as-jackson/-RK3588-Development-Board-/RK3588_image/rk3588-armsom-w3-bananer.png

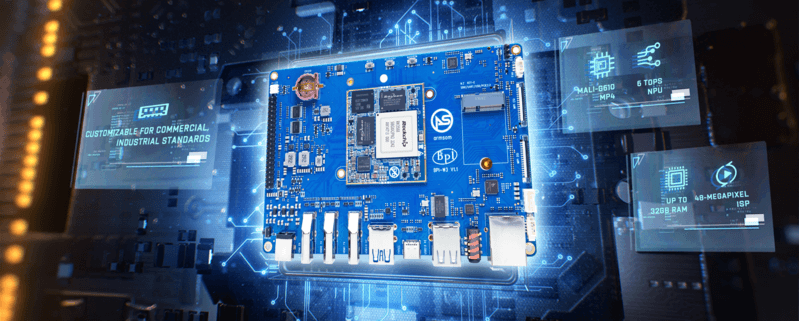
RK3588_image/rk3588-armsom-w3-bananer.png
