as-jackson/-RK3588-Development-Board-/RK3588_image/rk3588-sige7-Metal-shell.jpeg

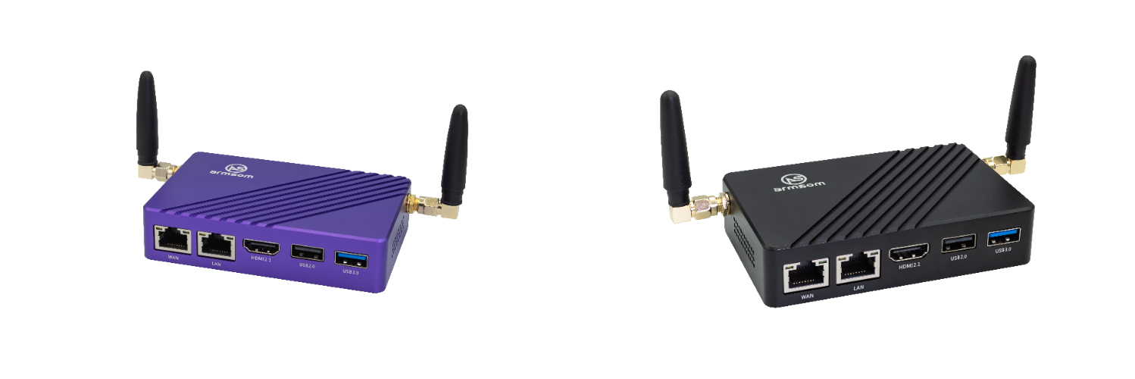
RK3588_image/rk3588-sige7-Metal-shell.jpeg
