as-jackson/-RK3588-Development-Board-/RK3588_Mechanical Drawings/rk3588_core_board_ArmSoM_W3_1V2_bot.dxf

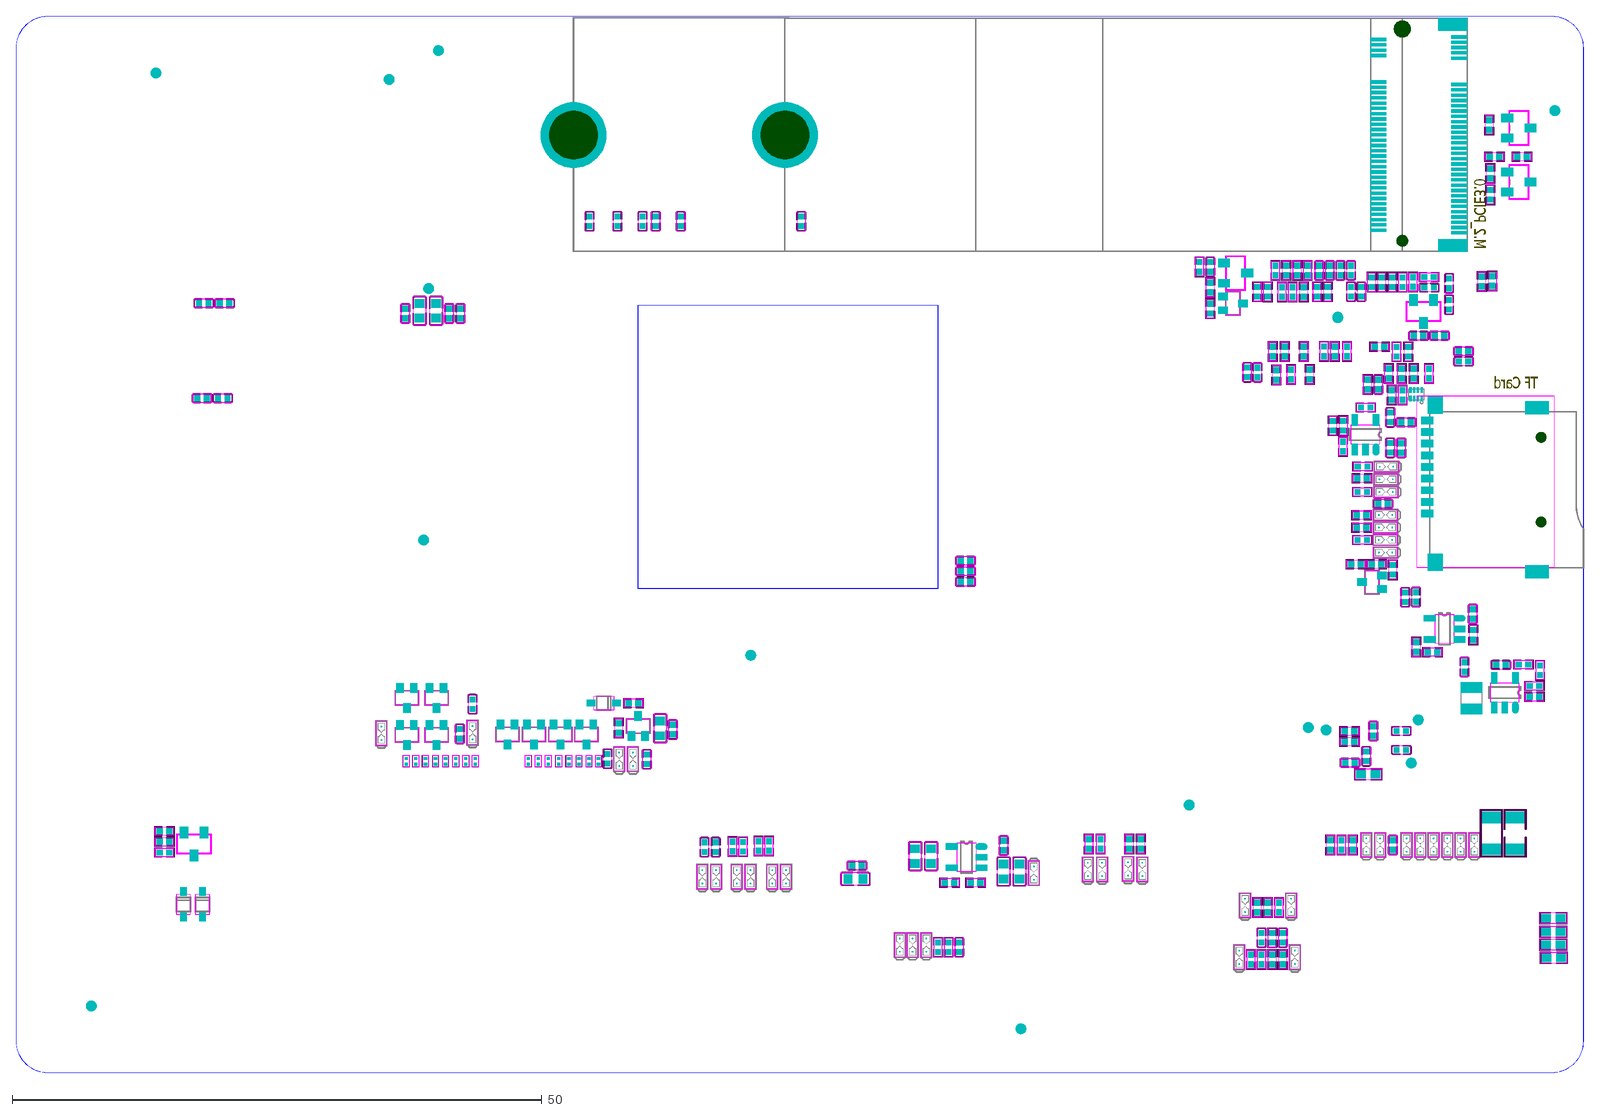
[picture p11: CAD file, 2024-10-31]
RK3588_Mechanical Drawings/rk3588_core_board_ArmSoM_W3_1V2_bot.dxf
M.2_PCIE3.0
TF Card
