as-jackson/-RK3588-Development-Board-/RK3588_Mechanical Drawings/RK3588_sbc_ArmSoM-Sige7_1V1_20231219_bot.dxf

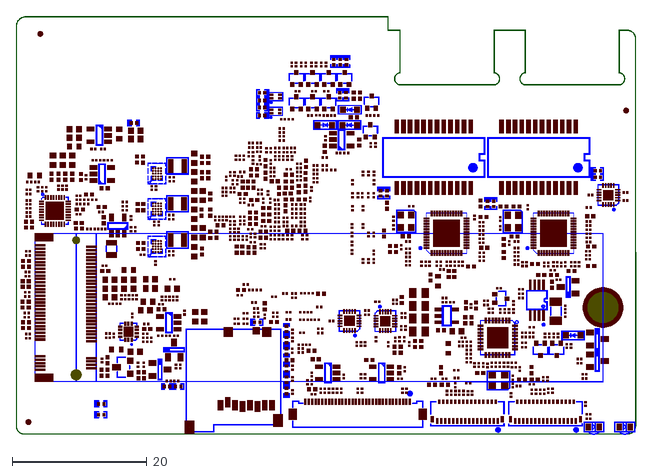
[picture p12: CAD file, 2024-10-31]
RK3588_Mechanical Drawings/RK3588_sbc_ArmSoM-Sige7_1V1_20231219_bot.dxf
92.1 x 62.1
