as-jackson/-RK3588-Development-Board-/RK3588_Component_diagram/RK3588_core_board_ArmSoM_W3_1V2_SMD.pdf

# LED

CR1220

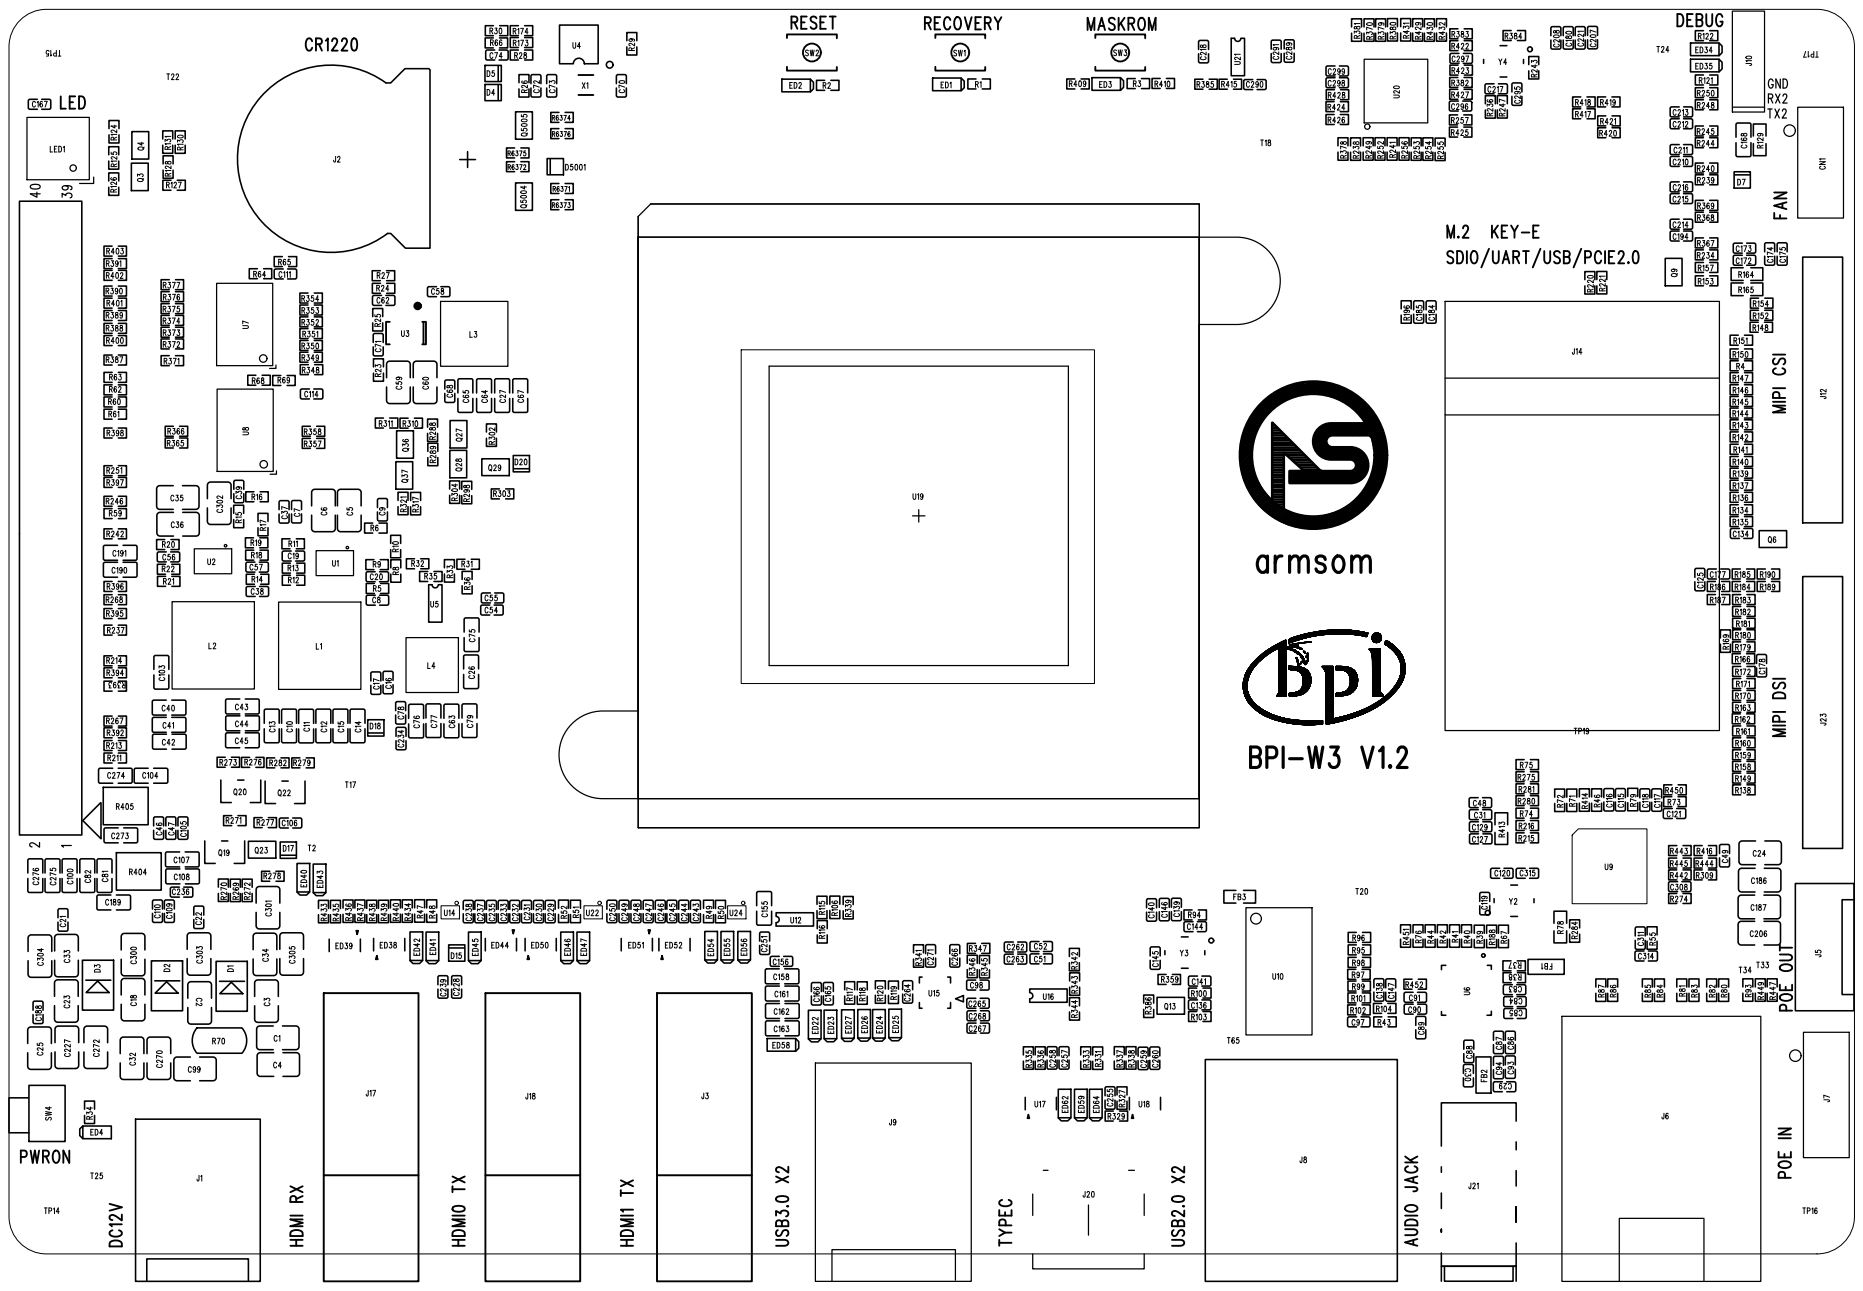
[picture p13: page 1]

POE IN POE OUT

T21

T23

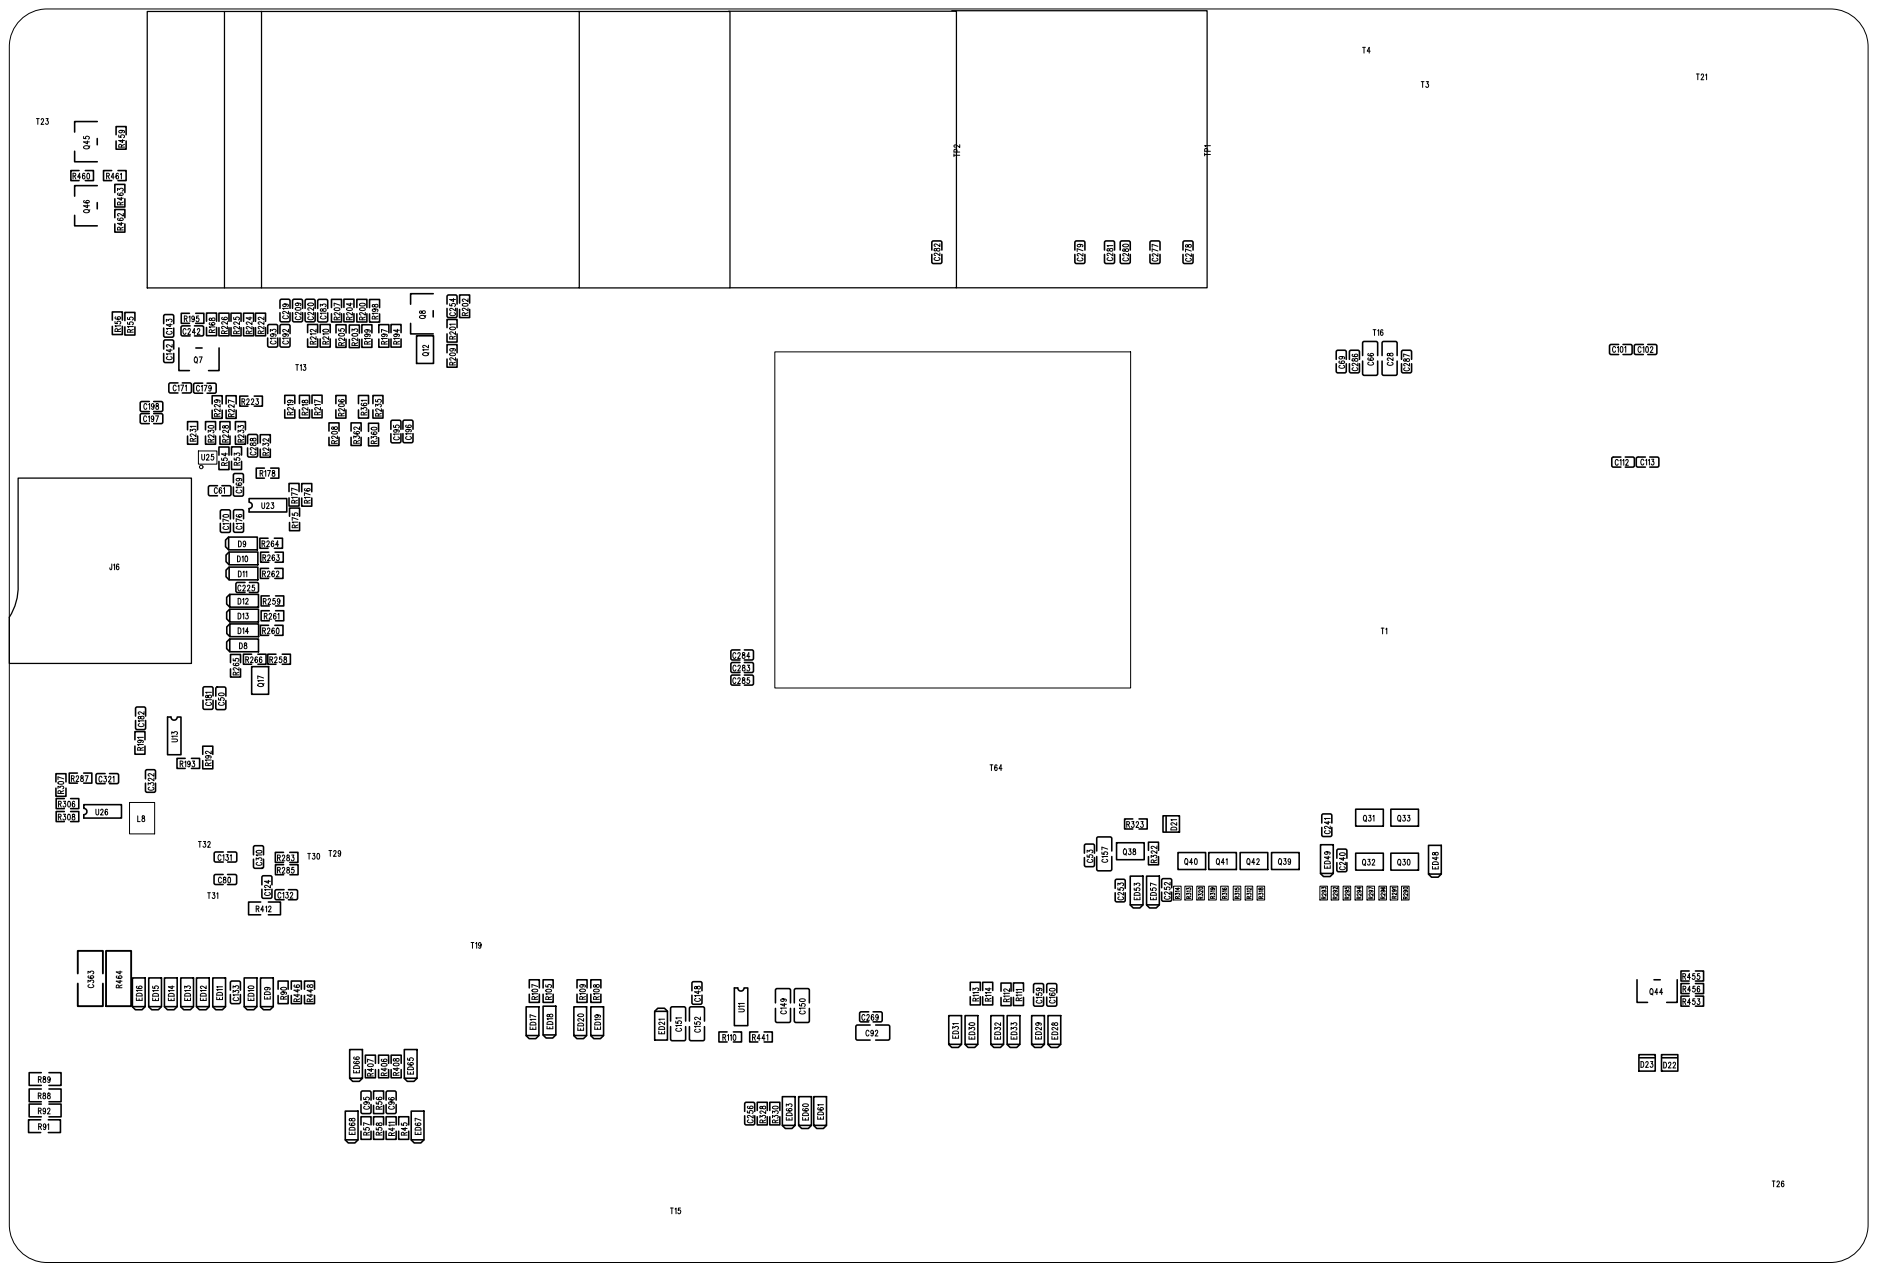
[picture p14: page 2]
