as-jackson/-RK3588-Development-Board-/RK3588_Component_diagram/RK3588_sbc_ArmSoM-Sige7_1V1_SMD.pdf

# SILKSCREEN TOP

CN30

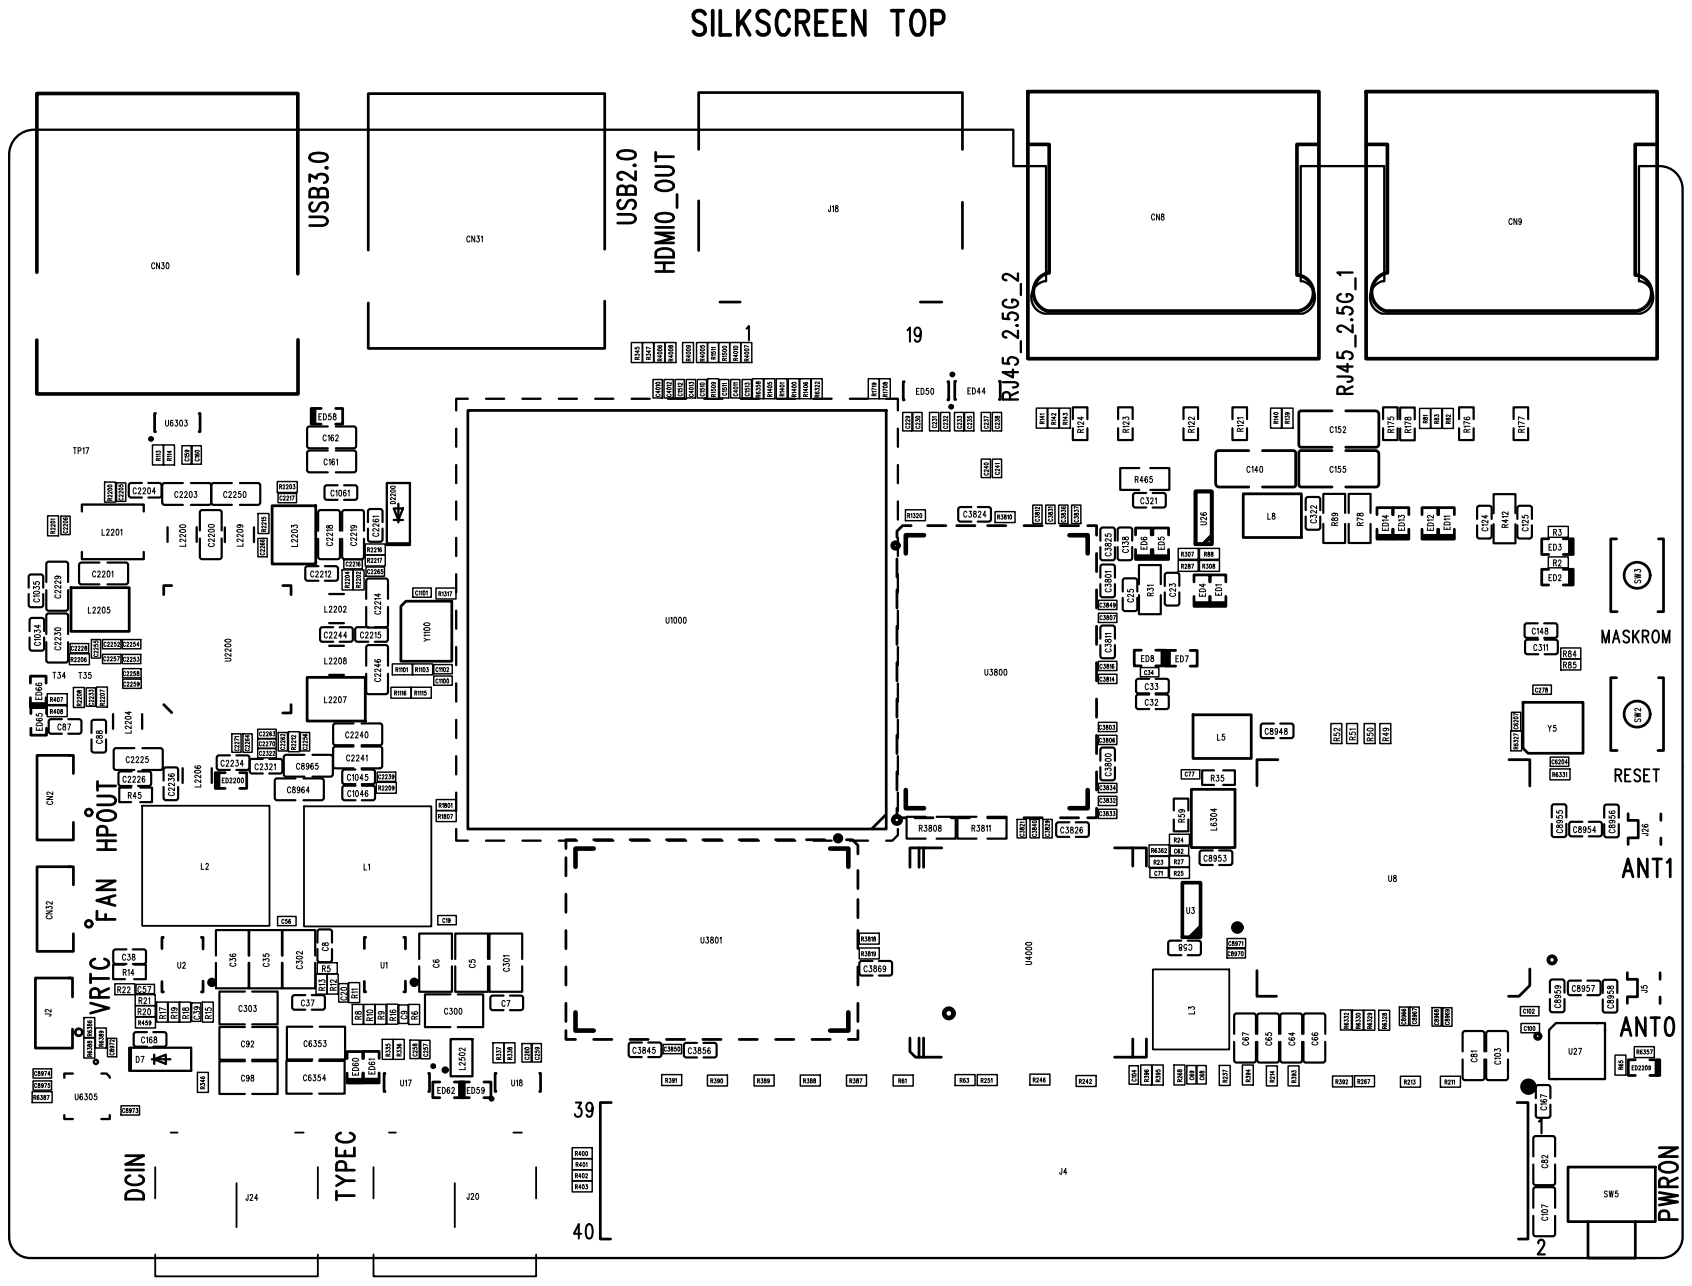
[picture p15: page 1]

# SILKSCREEN BOTTOM

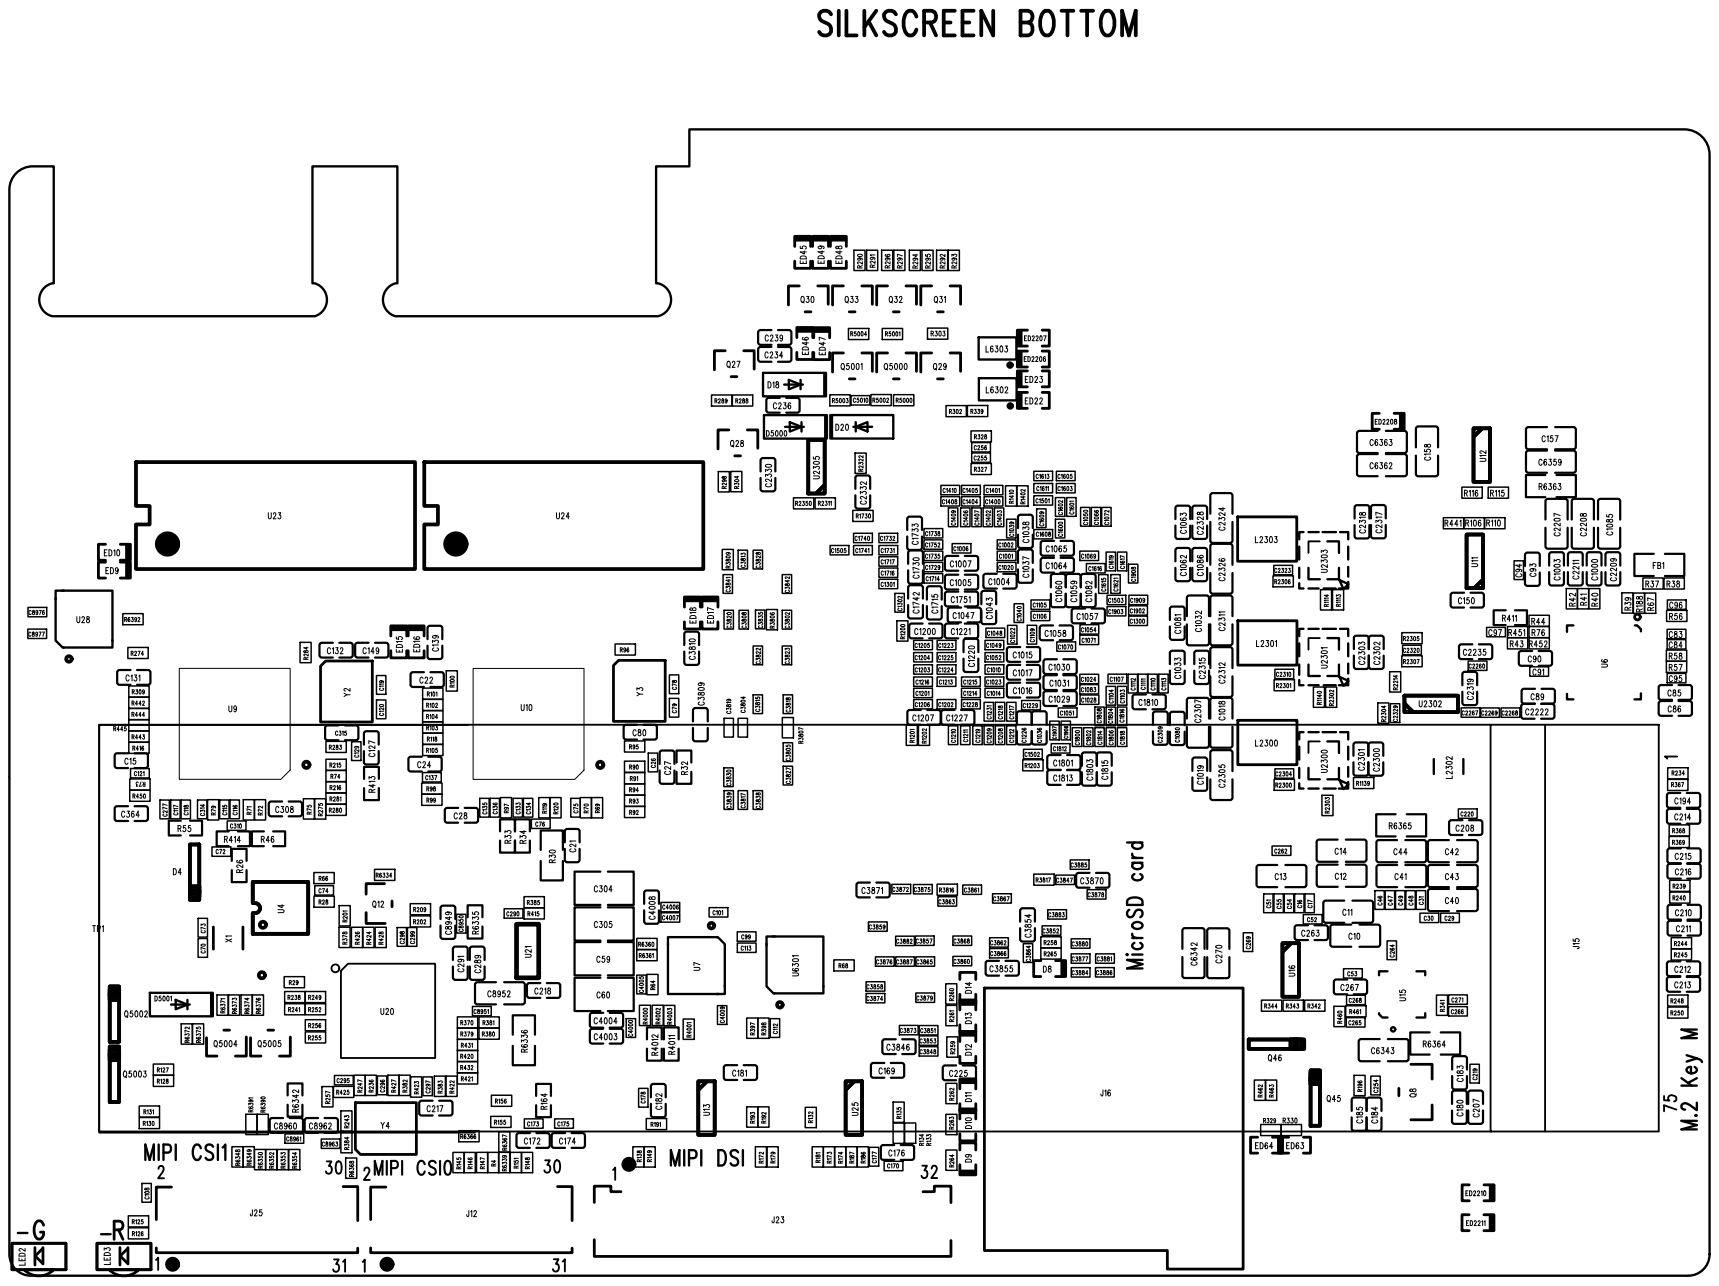
[picture p16: page 2]
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
