as-jackson/-RK3588-Development-Board-/RK3588_Schematics/RK3588_core_board_ArmSoM_W3_1V2_Sch.pdf

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
# Revsion V1.1:

1.PCBPackage change: USBx2=J8, touch switch=SW1/SW2/SW3, TF Card=J16,Typec=J20; 2.PCBPackage change: Debug CON=J10, 32.768KHz=X1; Shield=J13;
3.Fan =J11 change to 3 line;

# Revsion V1.2:

1.add uart2 protect circuit; R410=51K change to NC;

## Project :

Size | Page Name | Re v
Date: | Sheet | o f
https://armsom.org/ | Histroy | V1.2 ARMSOM_W3

# ArmSoM

A3 | Thursday, October 24, 2024 | 1 | 14
Size | Page Name | Re v
https://armsom.org/ | Histroy | V1.2 ARMSOM_W3

# ArmSoM

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

# ArmSoM

A3 | Thursday, October 24, 2024 | 1 | 14

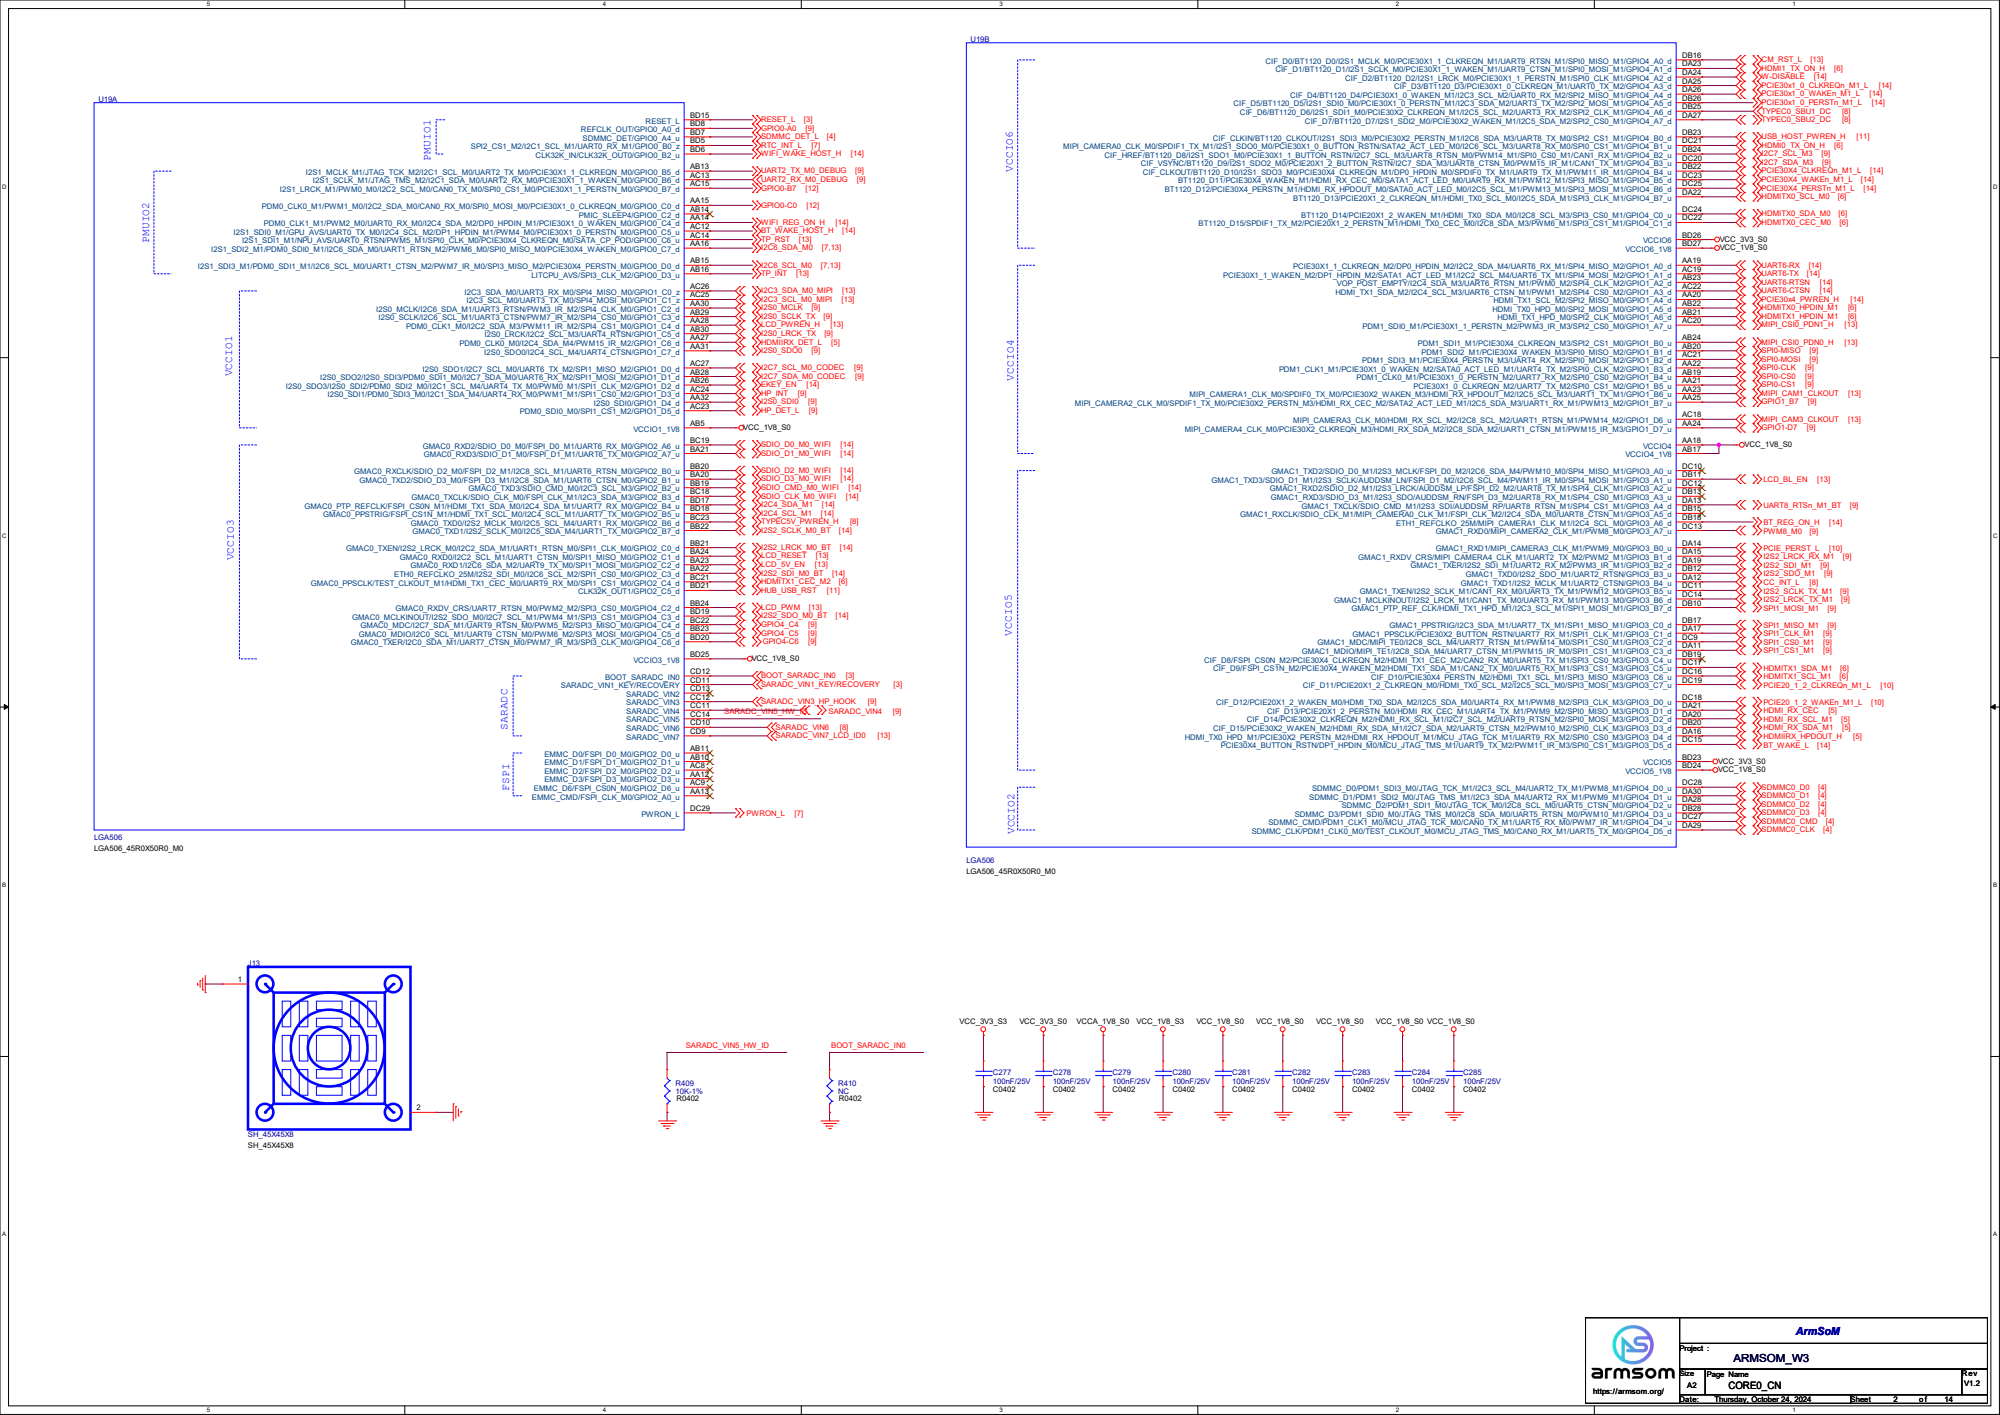
[picture p17: page 2]

PCIE20_1_REFCLKN | [14] PCIE20_1_REFCLKP [14] PCIE20_1_RXN [14] PCIE20_1_RXP [14] PCIE20_1_TXN [14] PCIE20_1_TXP [14] USB30_2_SSRXN [11] USB30_2_SSRXP [11] USB30_2_SSTXN [11] USB30_2_SSTXP [11] PCIE30_PORT0_TX0N [14] PCIE30_PORT0_TX0P [14] PCIE30_PORT0_RX0N [14] PCIE30_PORT0_RX0P [14] PCIE30_PORT0_TX1N [14] PCIE30_PORT0_TX1P [14] PCIE30_PORT0_RX1N [14] PCIE30_PORT0_RX1P [14] PCIE30_PORT1_REFCLKN_IN | [14] PCIE30_PORT1_REFCLKP_IN | [14] PCIE30_PORT1_TX2N [14] PCIE30_PORT1_TX2P [14] PCIE30_PORT1_RX2N [14] PCIE30_PORT1_RX2P [14] PCIE30_PORT1_TX3N [14] PCIE30_PORT1_TX3P [14] PCIE30_PORT1_RX3N [14] PCIE30_PORT1_RX3P [14] PCIE30_PORT0_REFCLKN_IN | [14] PCIE30_PORT0_REFCLKP_IN | [14]

# BA30 MIPI_CSI1_RX_D2P

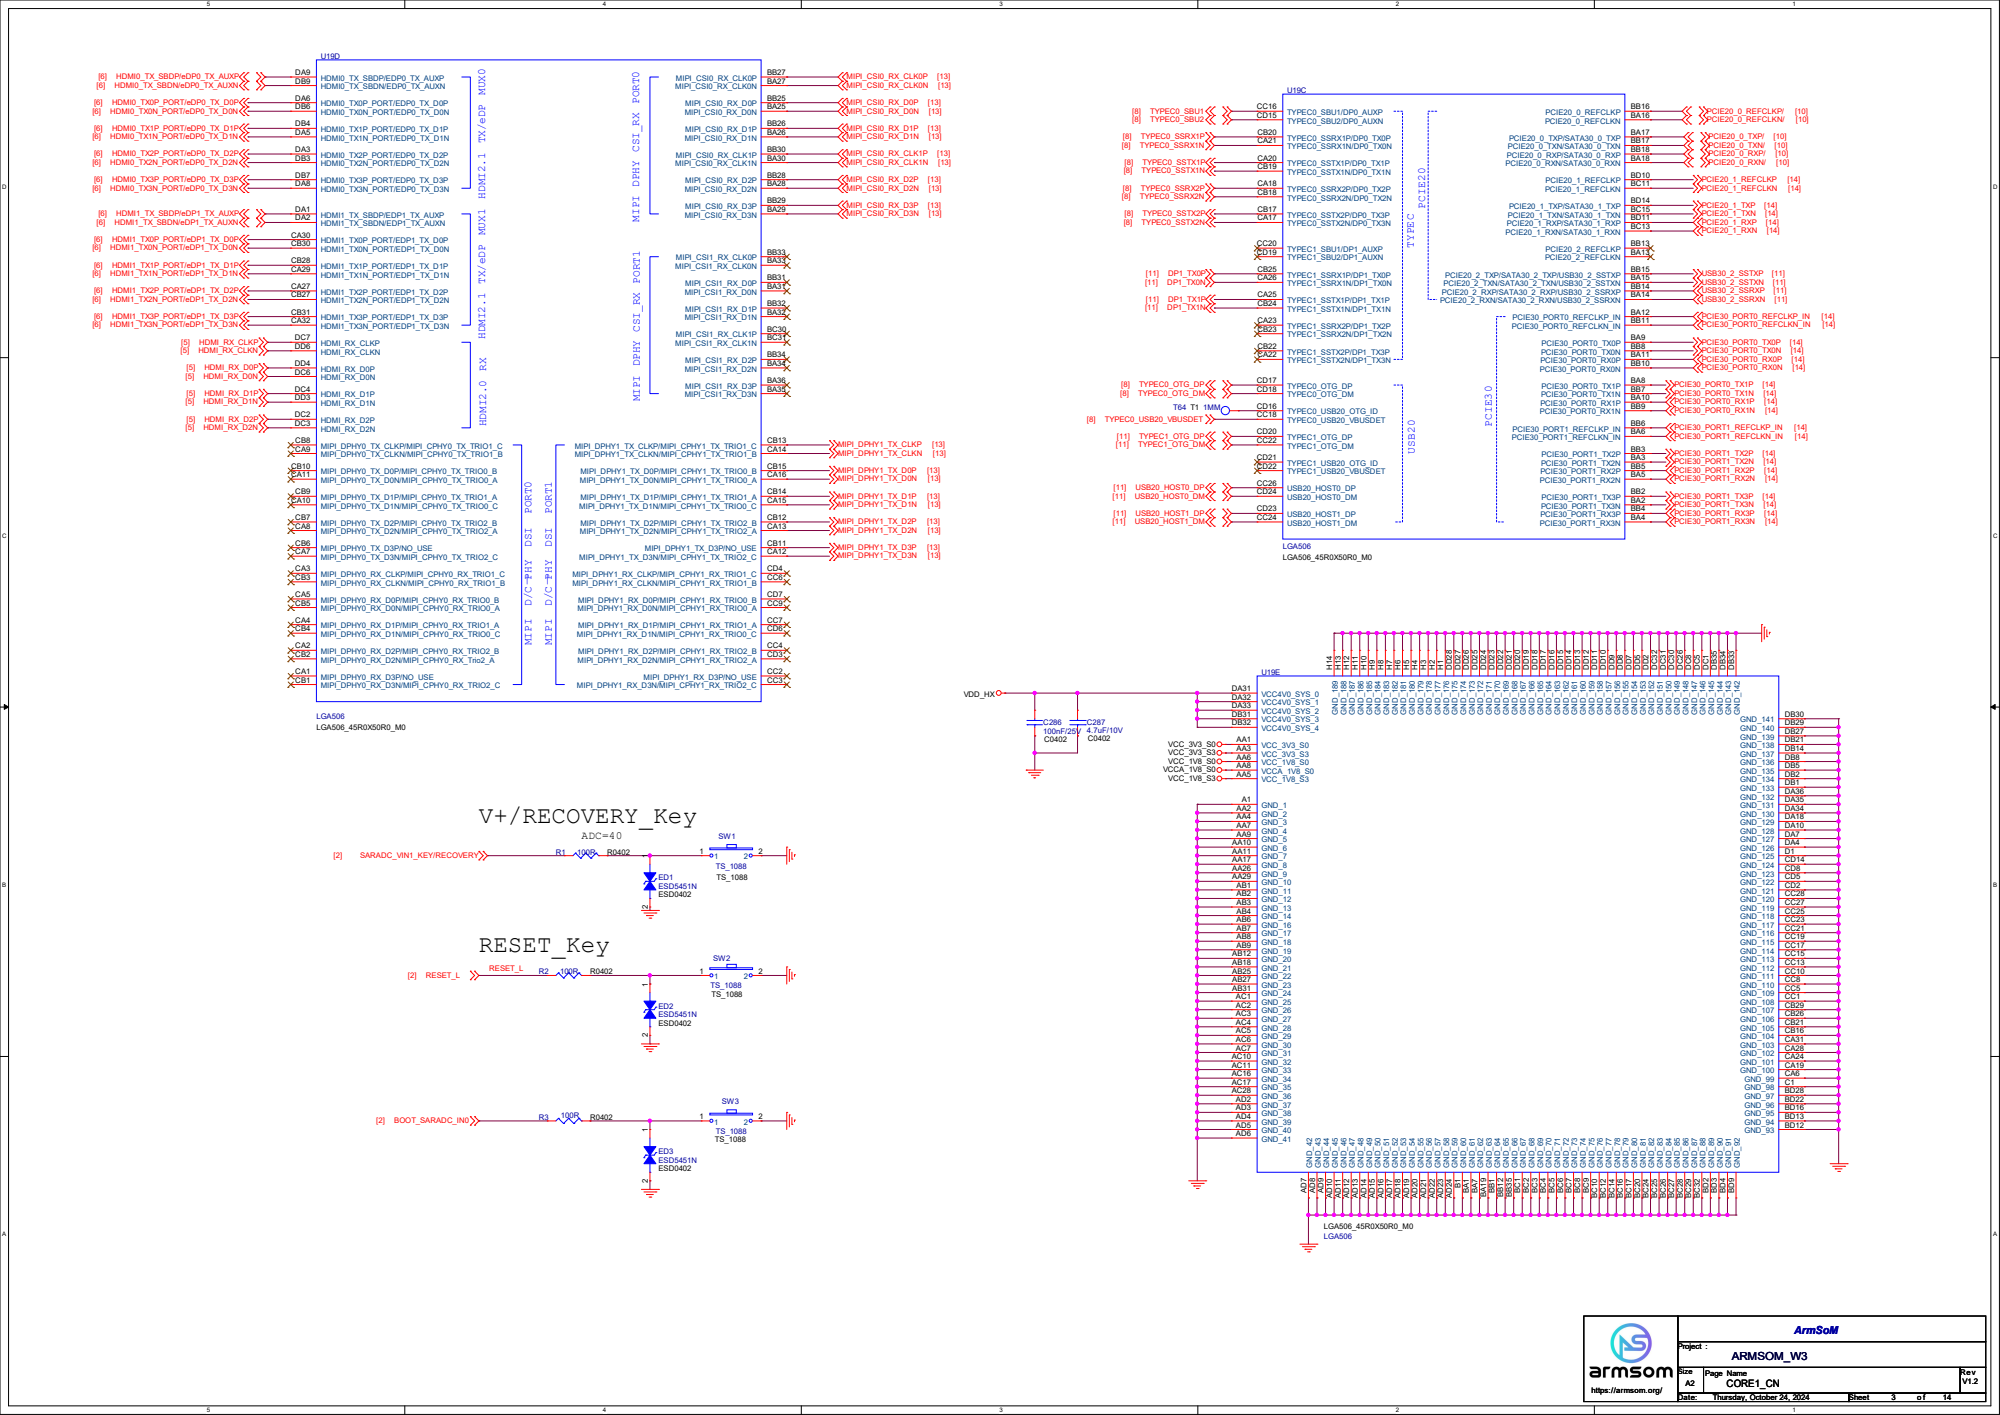
[picture p18: page 3]

D D

# TF CARD

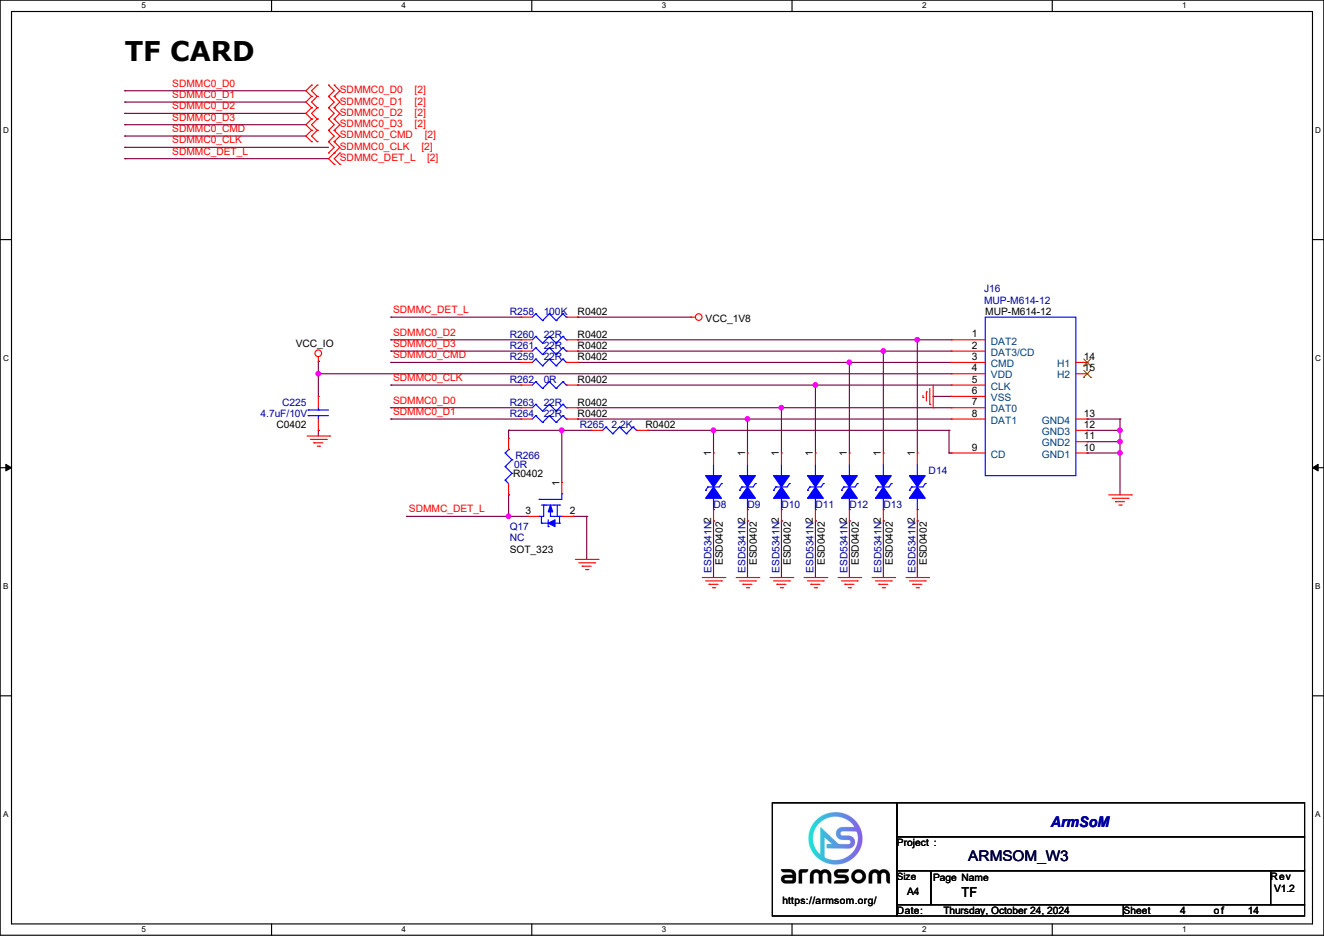
[picture p19: page 4]

# HDMI2.0 RX

HDMI_RX_D1P_PORT HDMI_RX_D1N_PORT | HDMI_RX_D1P_PORT HDMI_RX_D1N_PORT HDMI_RX_D2N_PORT HDMI_RX_D2P_PORT HDMI_RX_D2N_PORT HDMI_RX_D2P_PORT | HDMI_RX_D0N_PORT HDMI_RX_D0P_PORT | HDMI_RX_D0N_PORT HDMI_RX_D0P_PORT HDMI_RX_CLKP_PORT HDMI_RX_CLKN_PORT HDMI_RX_CLKP_PORT HDMIIRX_DET_L | HDMI_RX_CLKN_PORT HDMI_RX_CEC

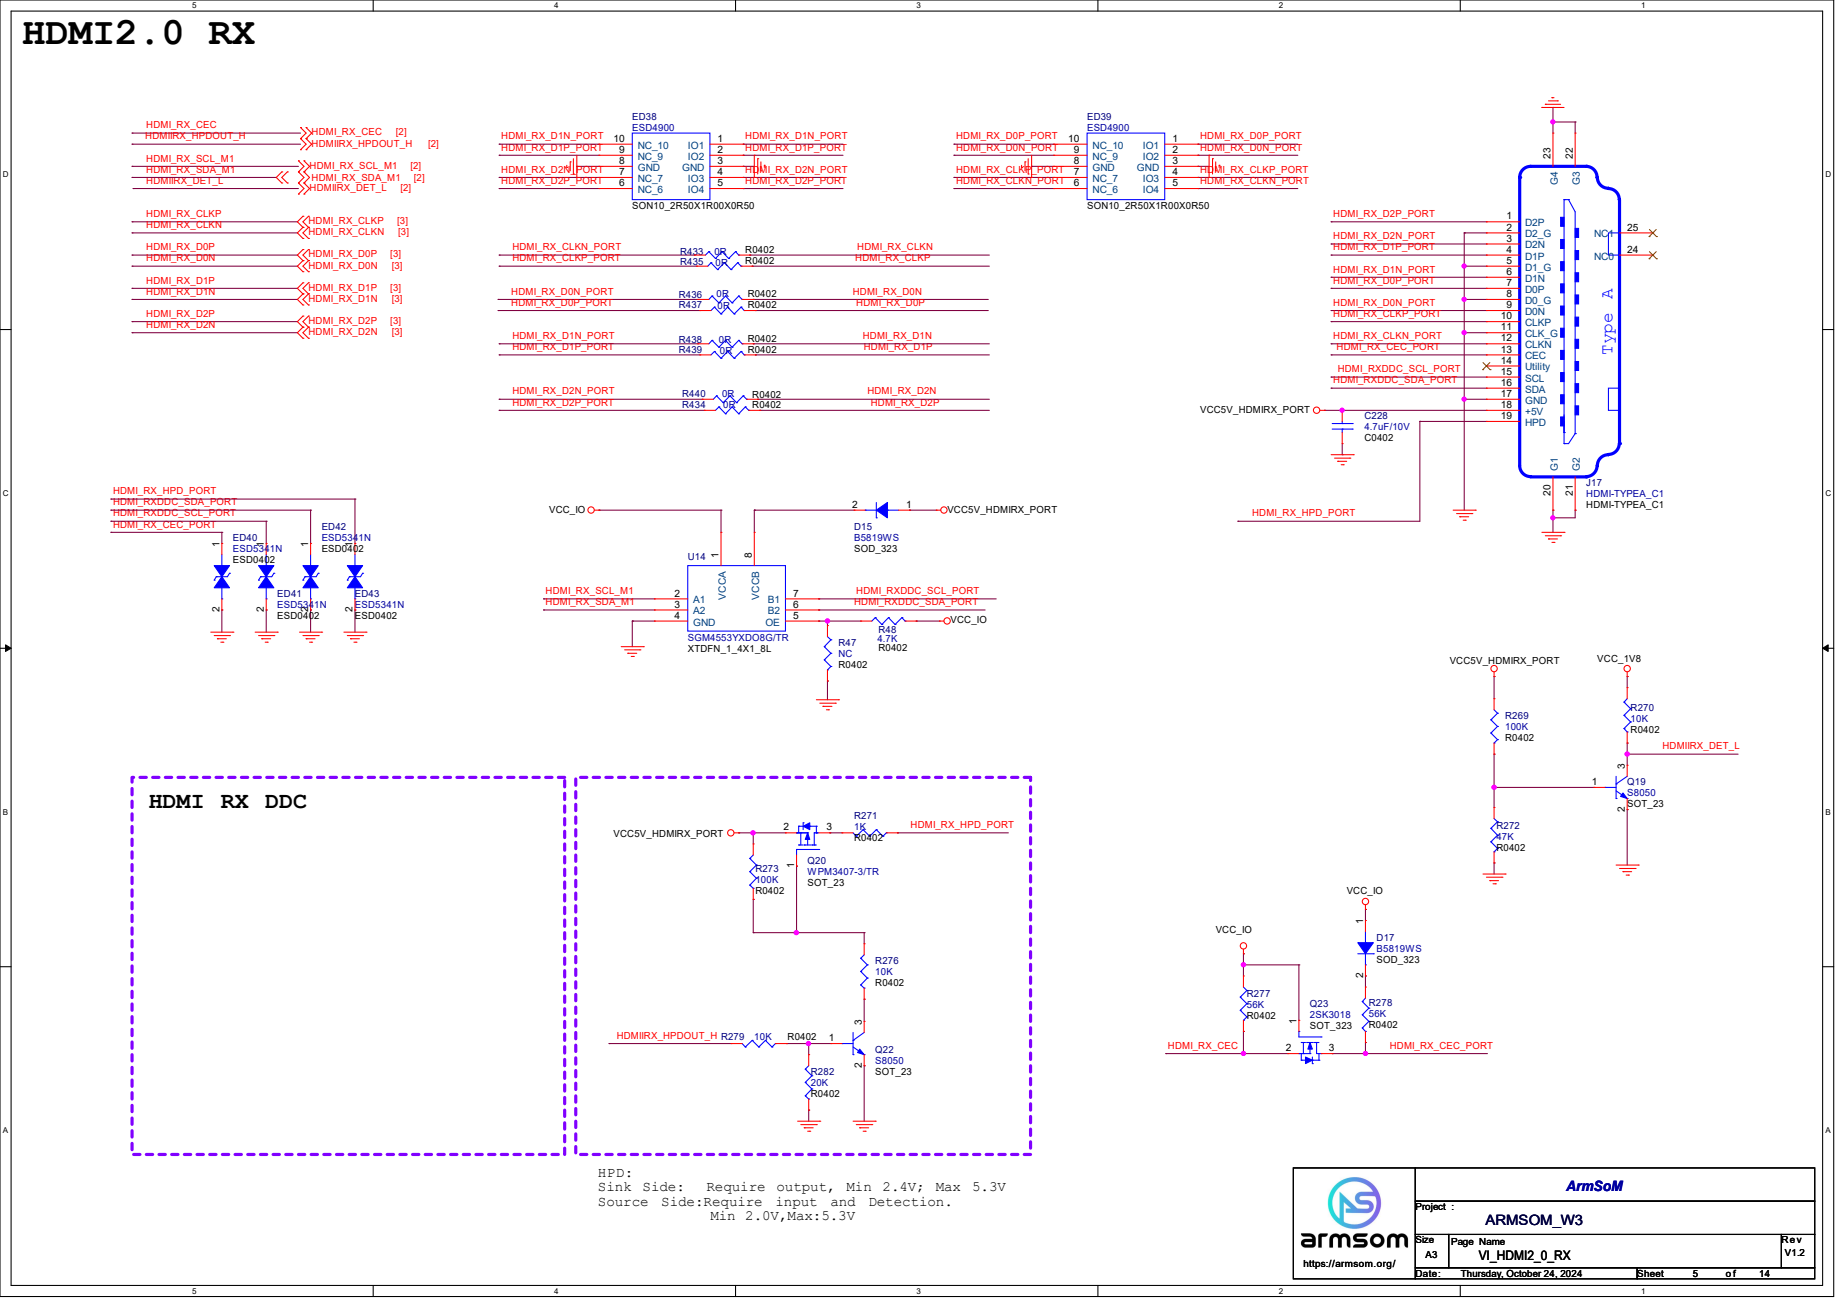
[picture p20: page 5]

HPD:
Source Side:Require input and Detection.

# HDMI TX0

# HDMI TX DDC

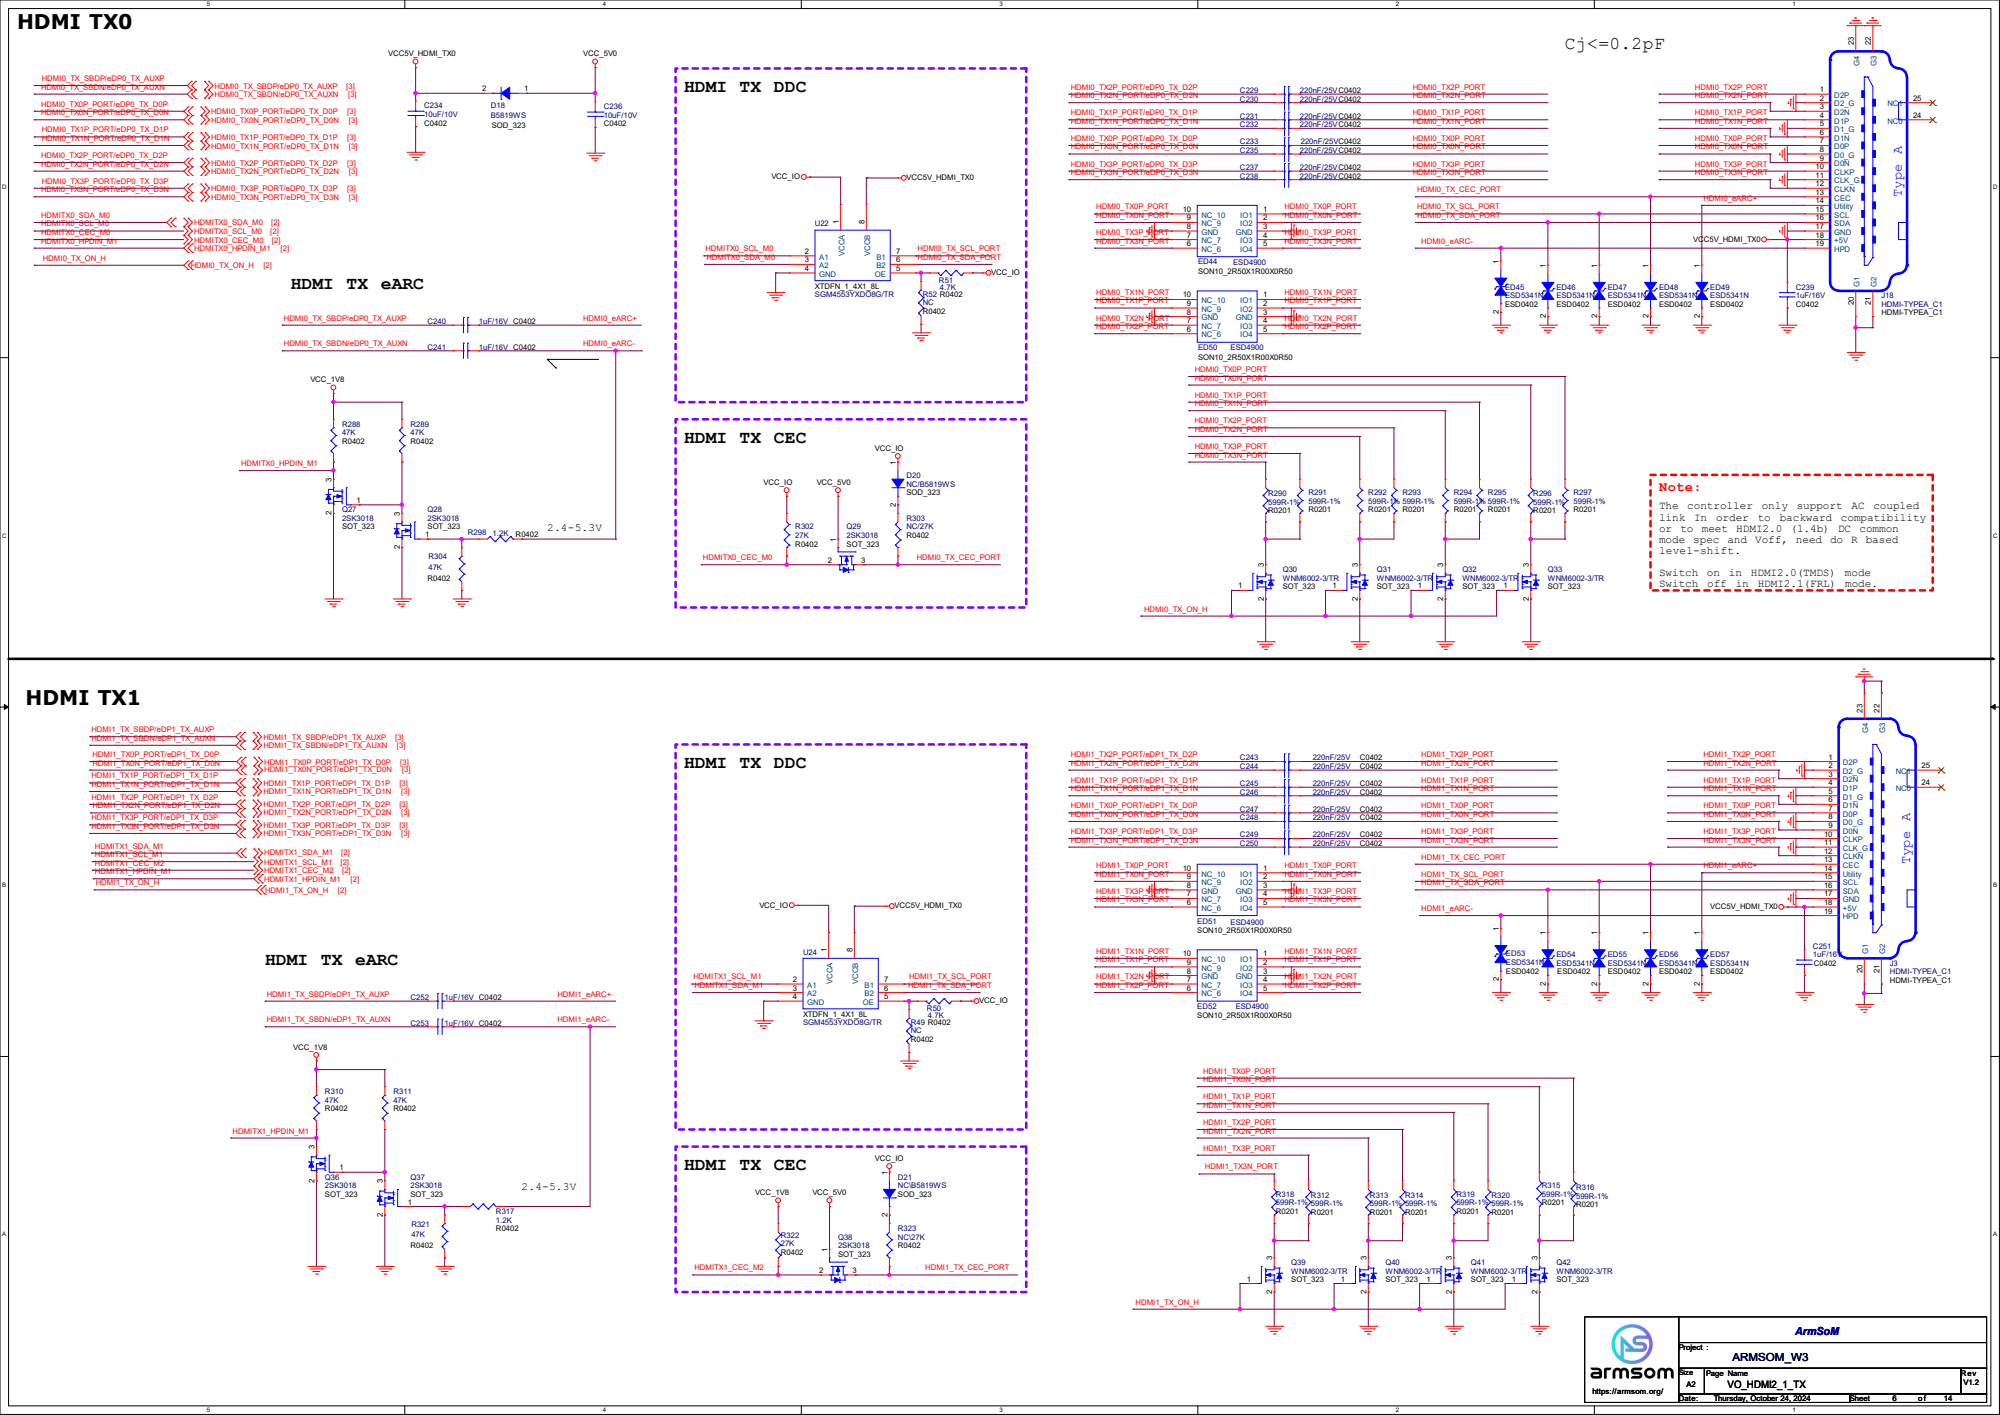
[picture p21: page 6]

Note:
The controller only support AC coupled
link In order to backward compatibility
or to meet HDMI2.0 (1.4b) DC common
mode spec and Voff, need do R based
level-shift.

Switch on in HDMI2.0(TMDS) mode
Switch off in HDMI2.1(FRL) mode.

# DC_5V

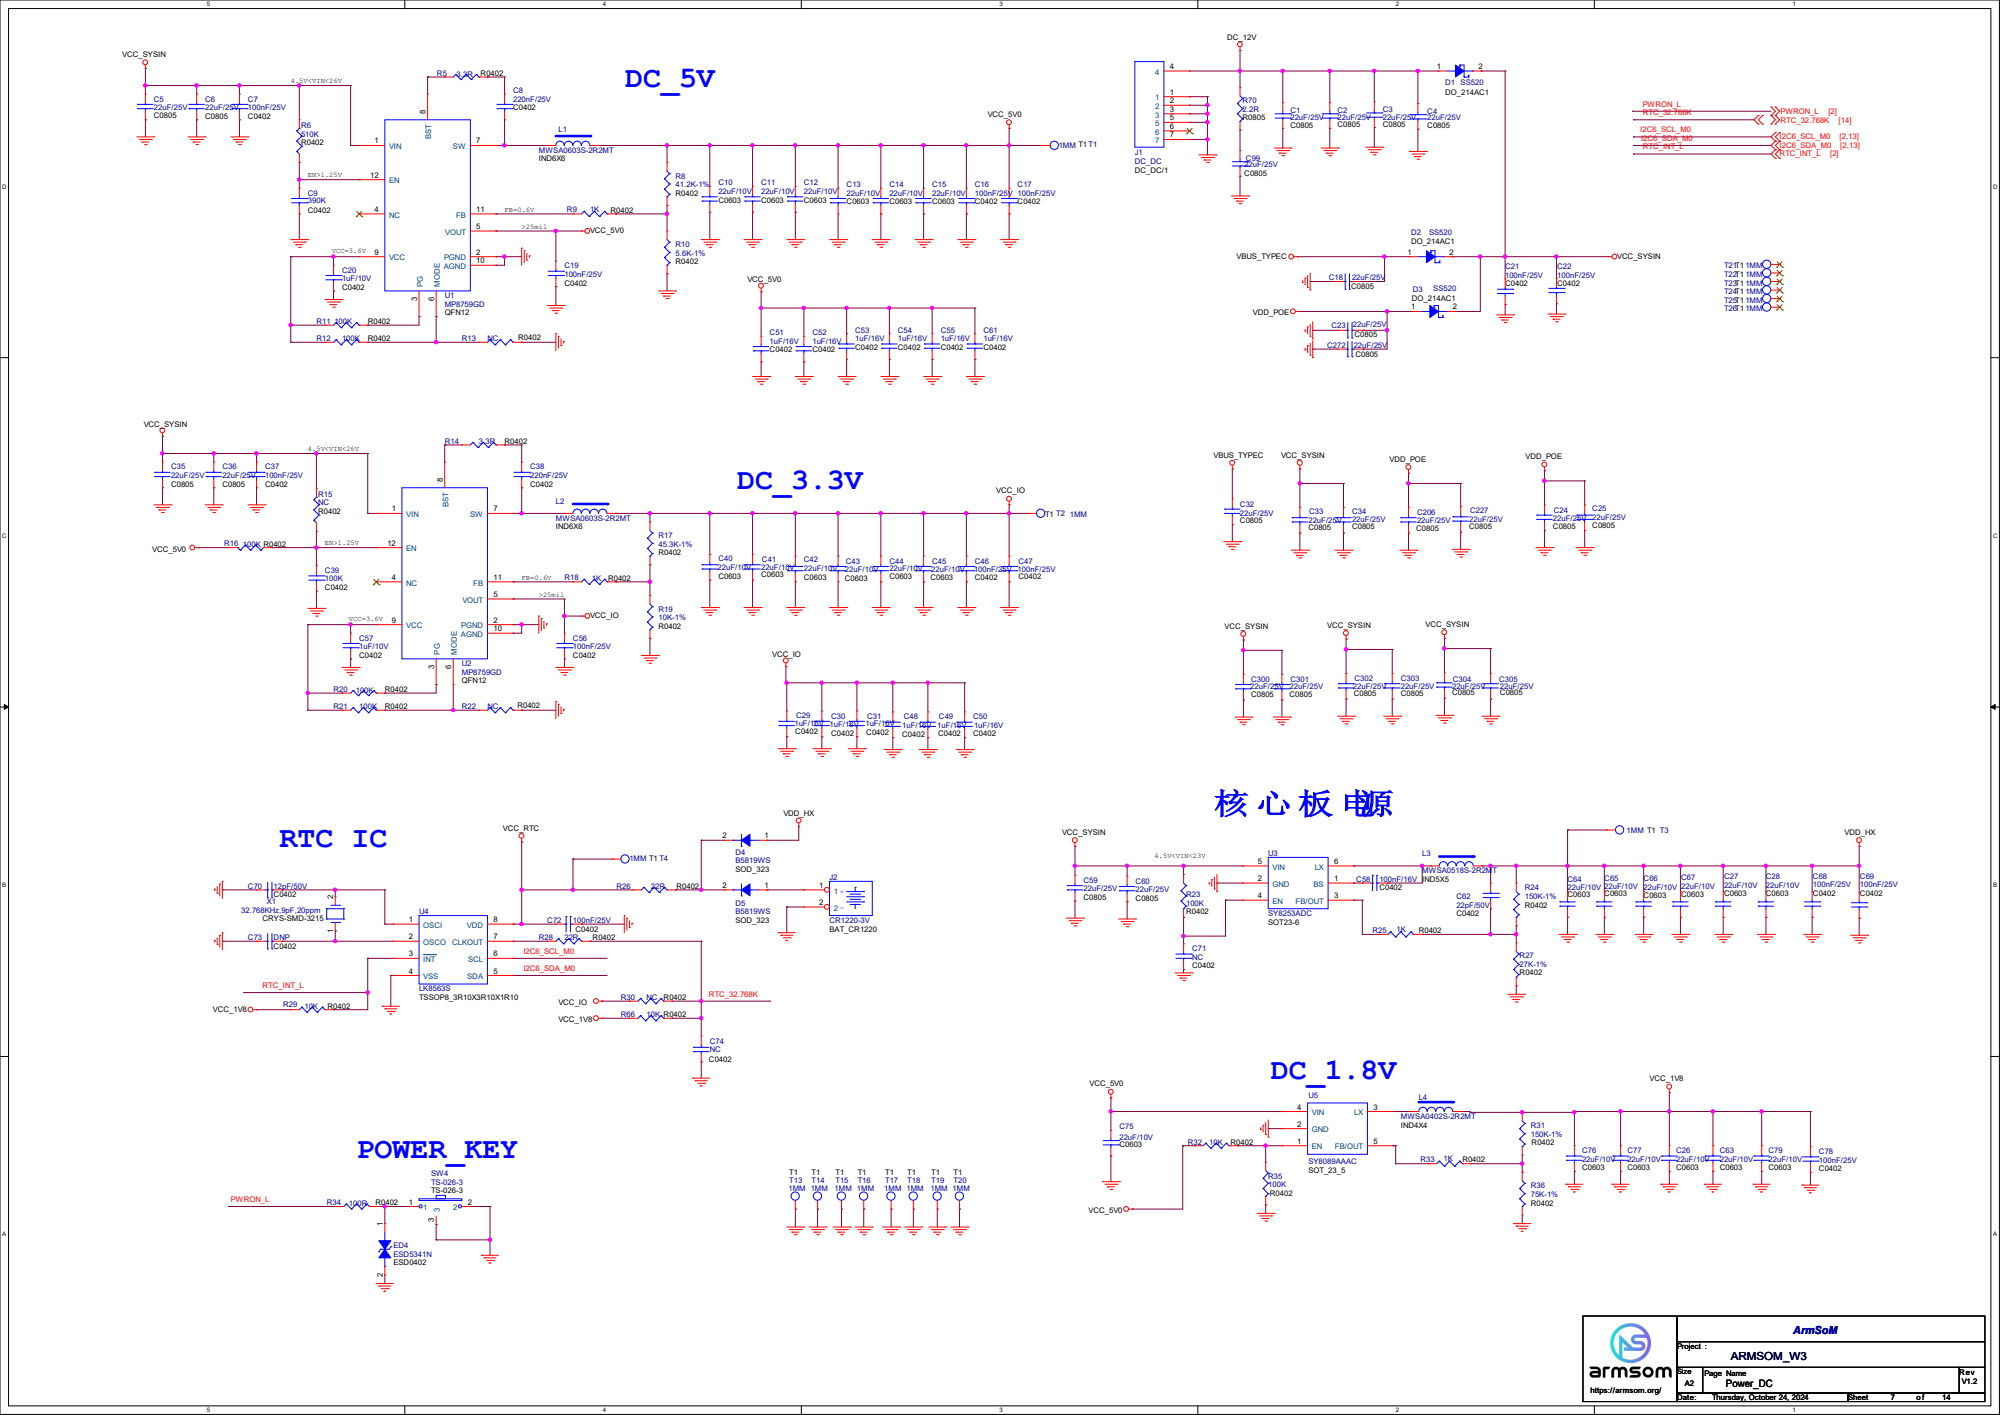
[picture p22: page 7]

D D

# Type-C PORT

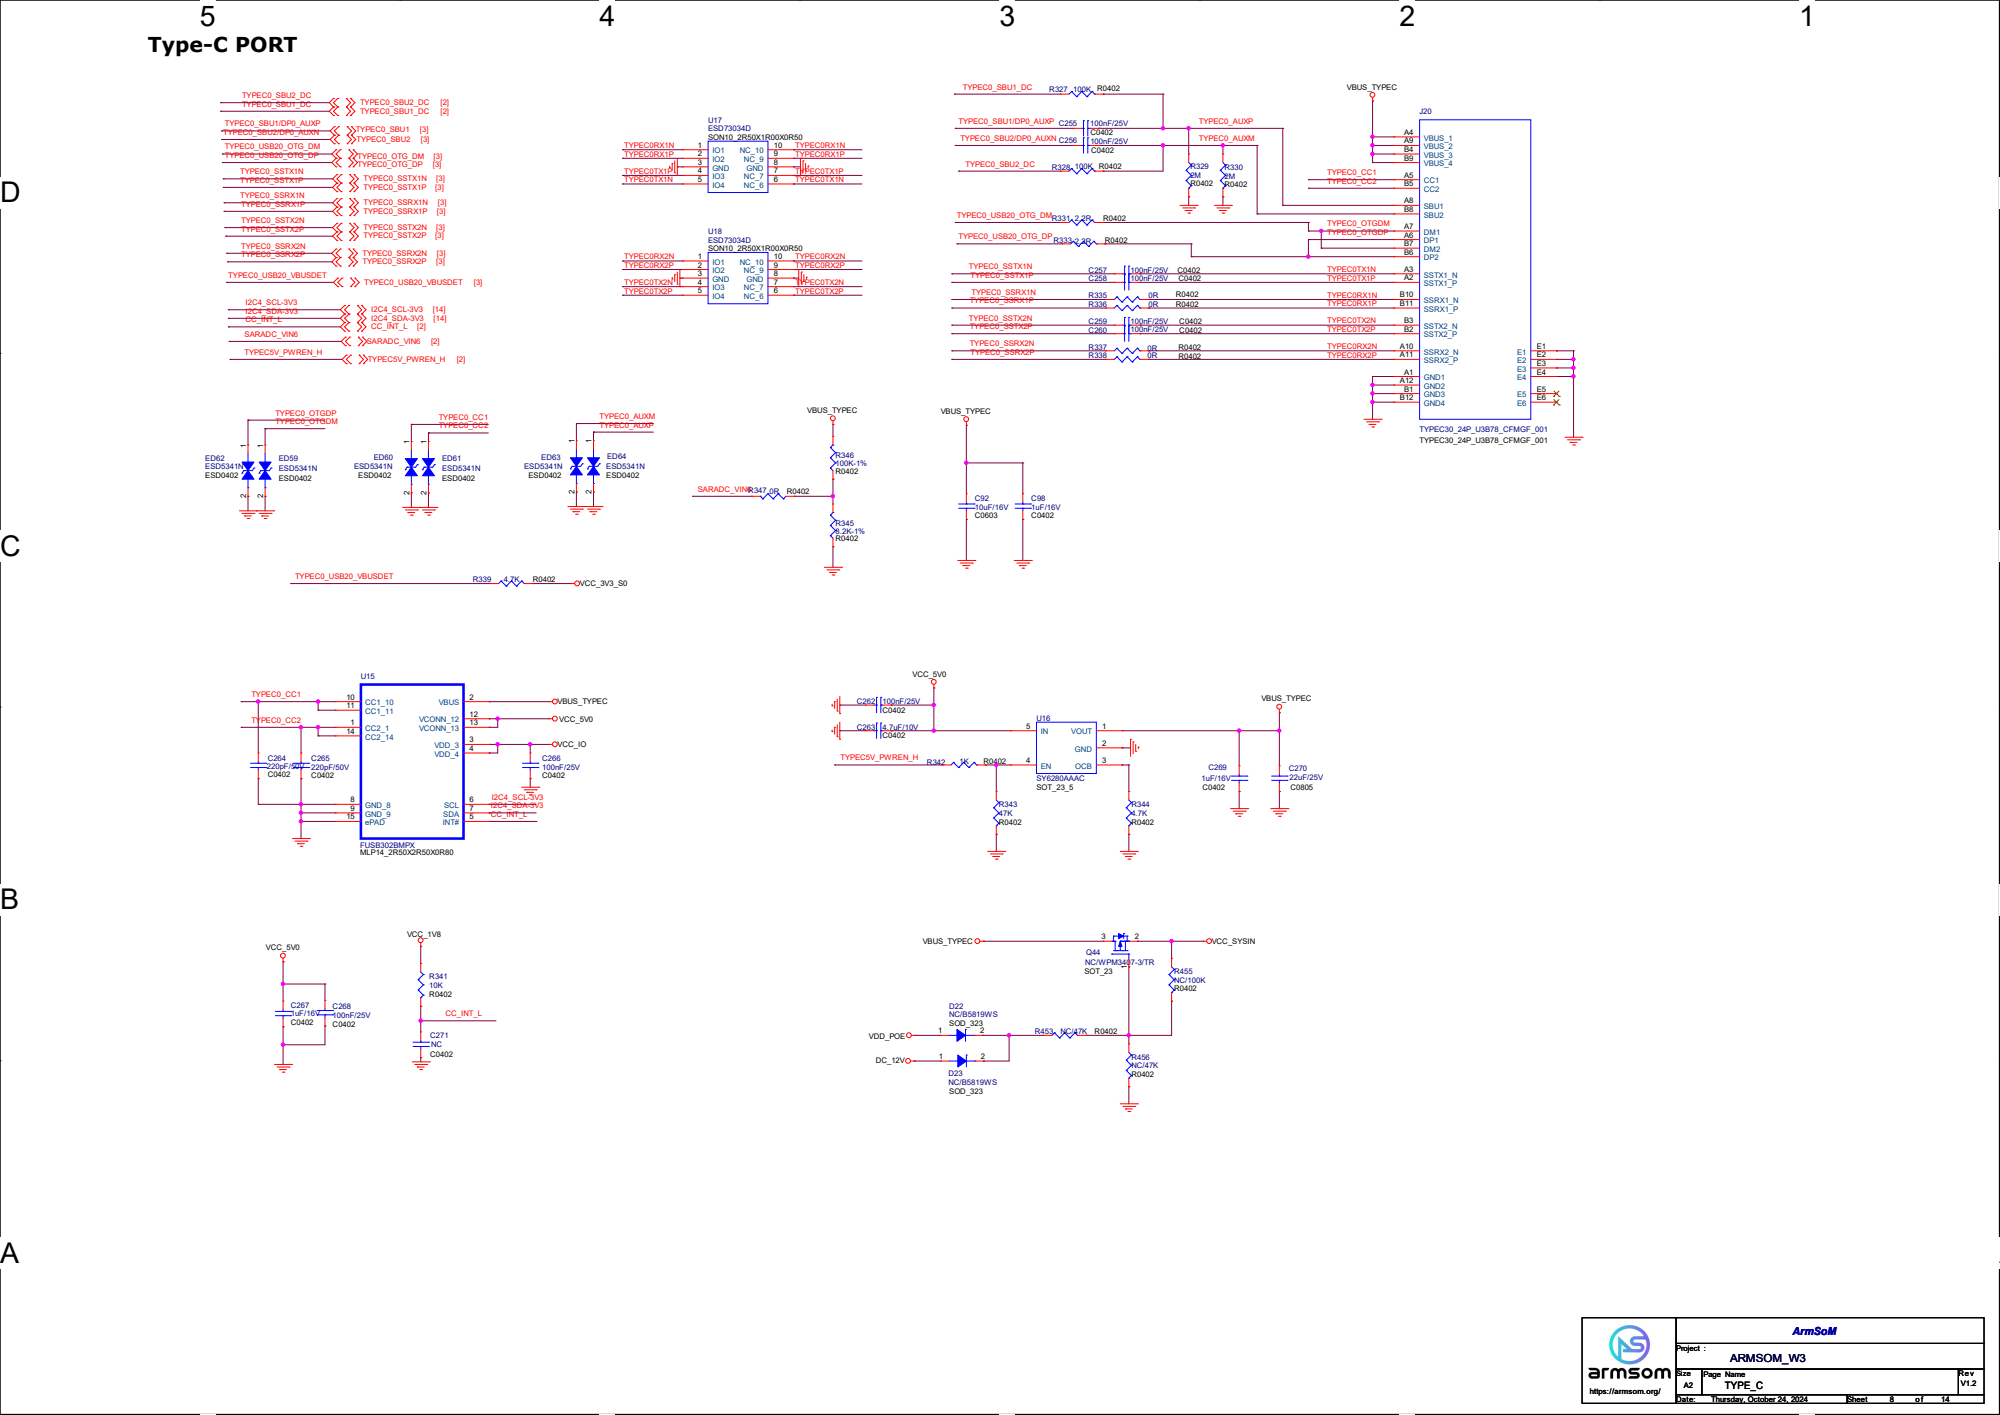
[picture p23: page 8]

# CODEC ES8316

# FB2 120R-2A L0603 R45 NC

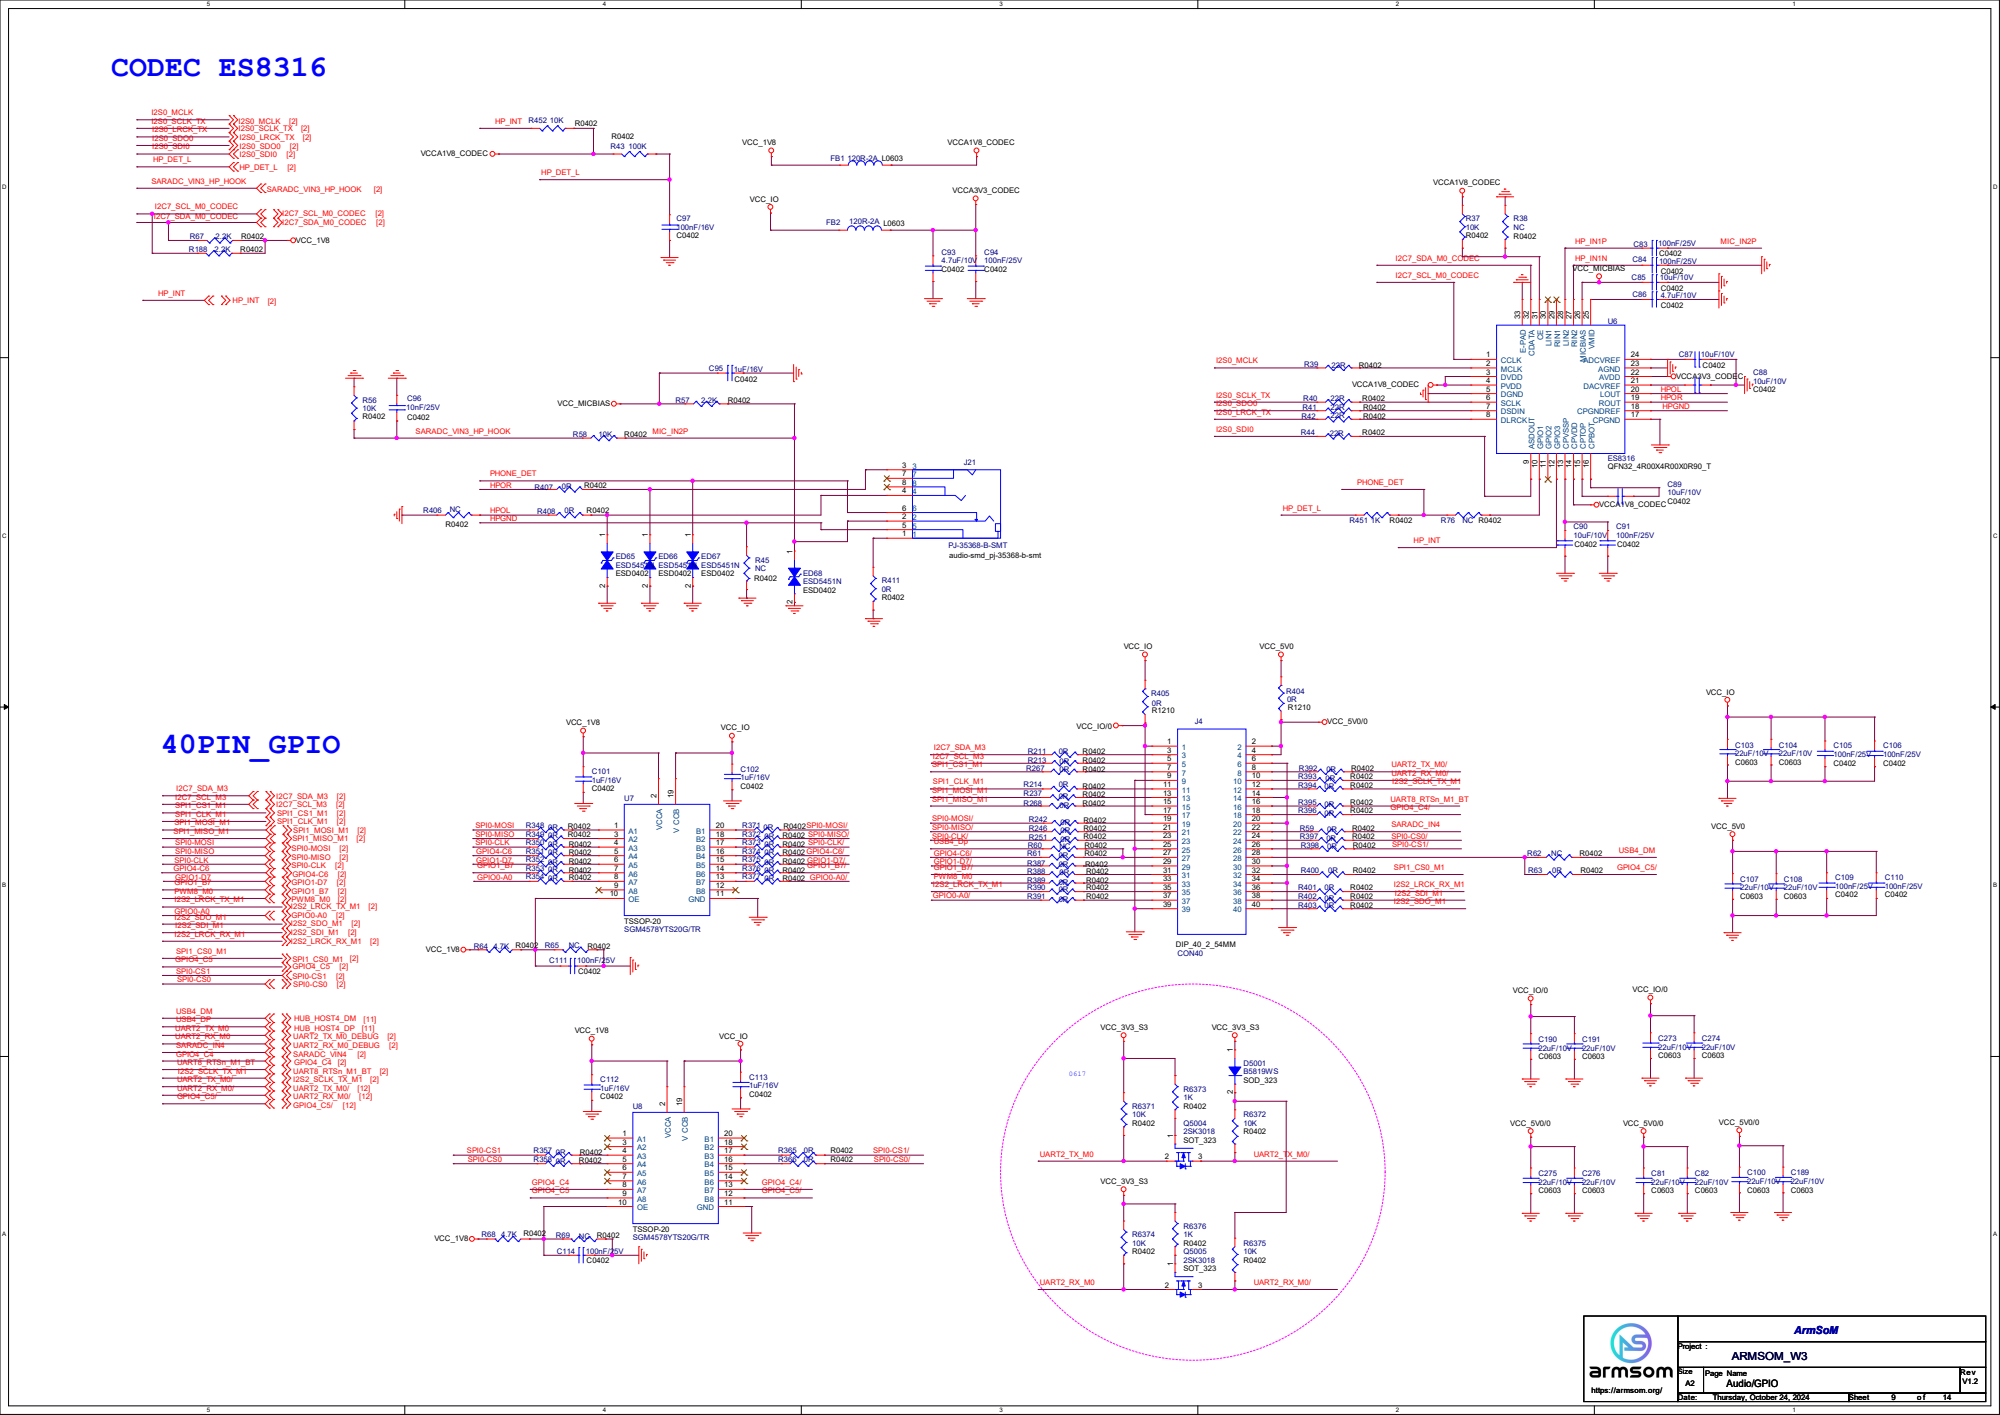
[picture p24: page 9]

24 VMID ²⁵ MICBIAS ²⁶ RIN² ²⁷ LIN² ²⁸ RIN¹ ²⁹ LIN¹ ³⁰ CE ³¹ CDATA ³² E⁻PAD ³³
U6ES8316 QFN32_4R00X4R00X0R90_T CCLK

9 GPIO1 10 GPIO2 11 GPIO3 12 CPVSSP 13 CPVDD 14 CPTOP 15 CPBOT 16 CPGND

# PCIE TO RJ45

RJ45_2_MDI3- | VC1 VC2 VC3 VC4 CLKREQB DVDD⁰⁹_10_47 | REFCLK_N REFCLK_P | EVDD³³/DVDD¹⁰ HSIN HSIP GND/DVDD¹⁰ HSON HSOP EVDD⁰⁹_10

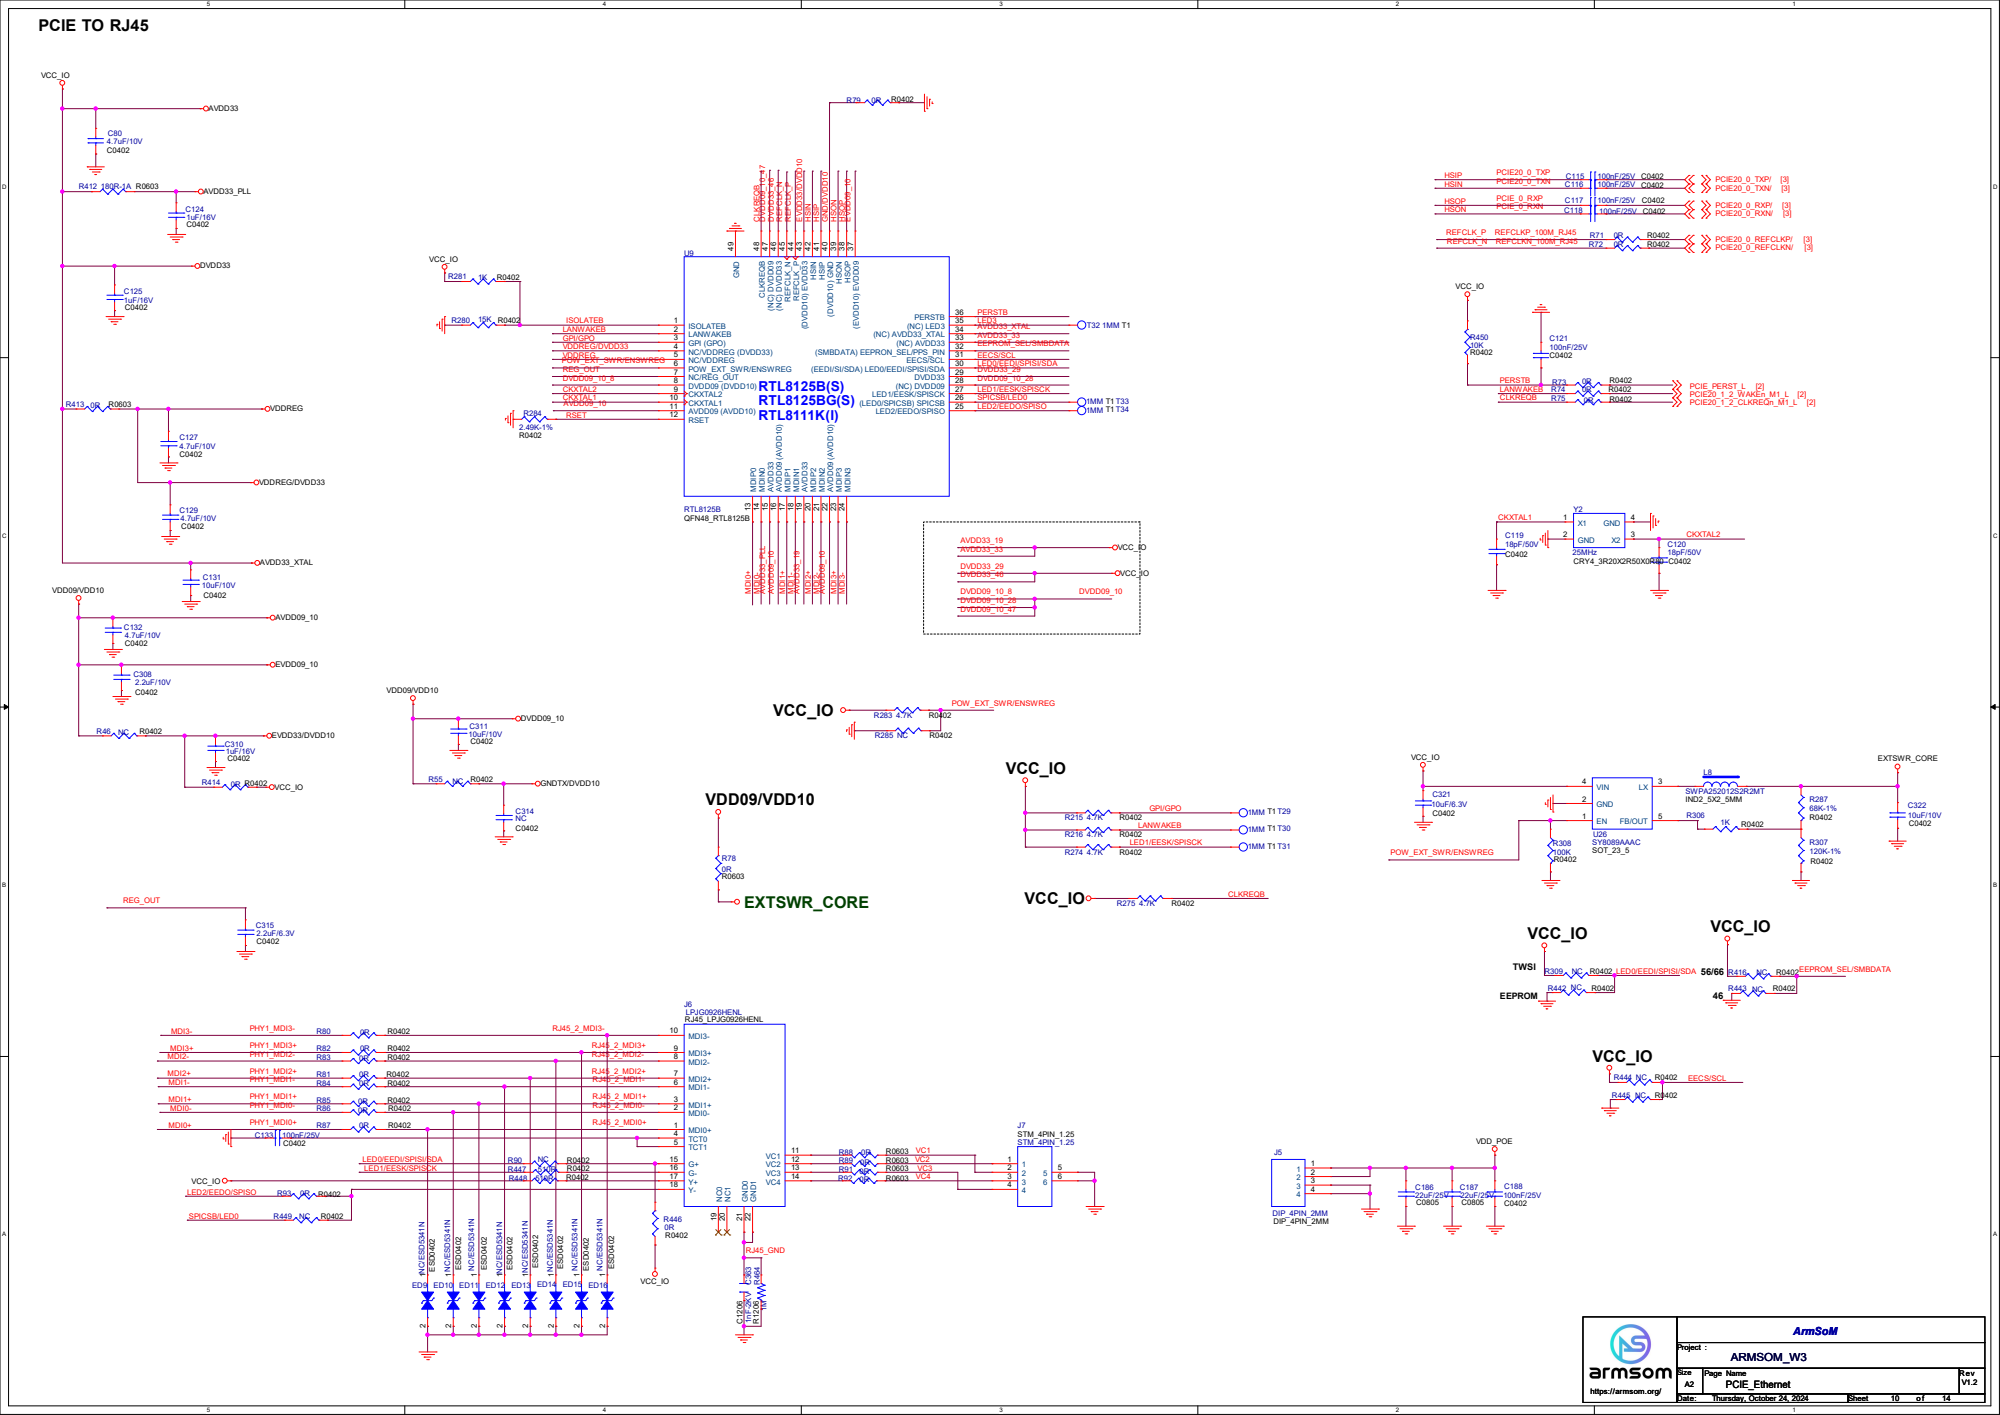
[picture p25: page 10]

2 48 CLKREQB (NC⁾ DVDD⁰⁹ ⁴⁷ GPI (GPO) 3 NC/VDDREG (DVDD33) 4 NC/VDDREG
RTL8111K(I) U9QFN48_RTL8125B RTL8125B

25 ⁽NC⁾ DVDD³³ ⁴⁶ REFCLK_N ⁴⁵⁴⁴ REFCLK_P (DVDD¹⁰⁾ EVDD³³ ⁴³ HSIN ⁴²⁴¹ HSIP (DVDD¹⁰⁾ GND ⁴⁰ HSON ³⁹³⁸ HSOP (EVDD¹⁰⁾ EVDD⁰⁹ ³⁷ GND ⁴⁹

(EEDI/SI/SDA) LED0/EEDI/SPISI/SDA

# USB_HUB

## DVDD3V3_HUB USB20_HOST0_DM

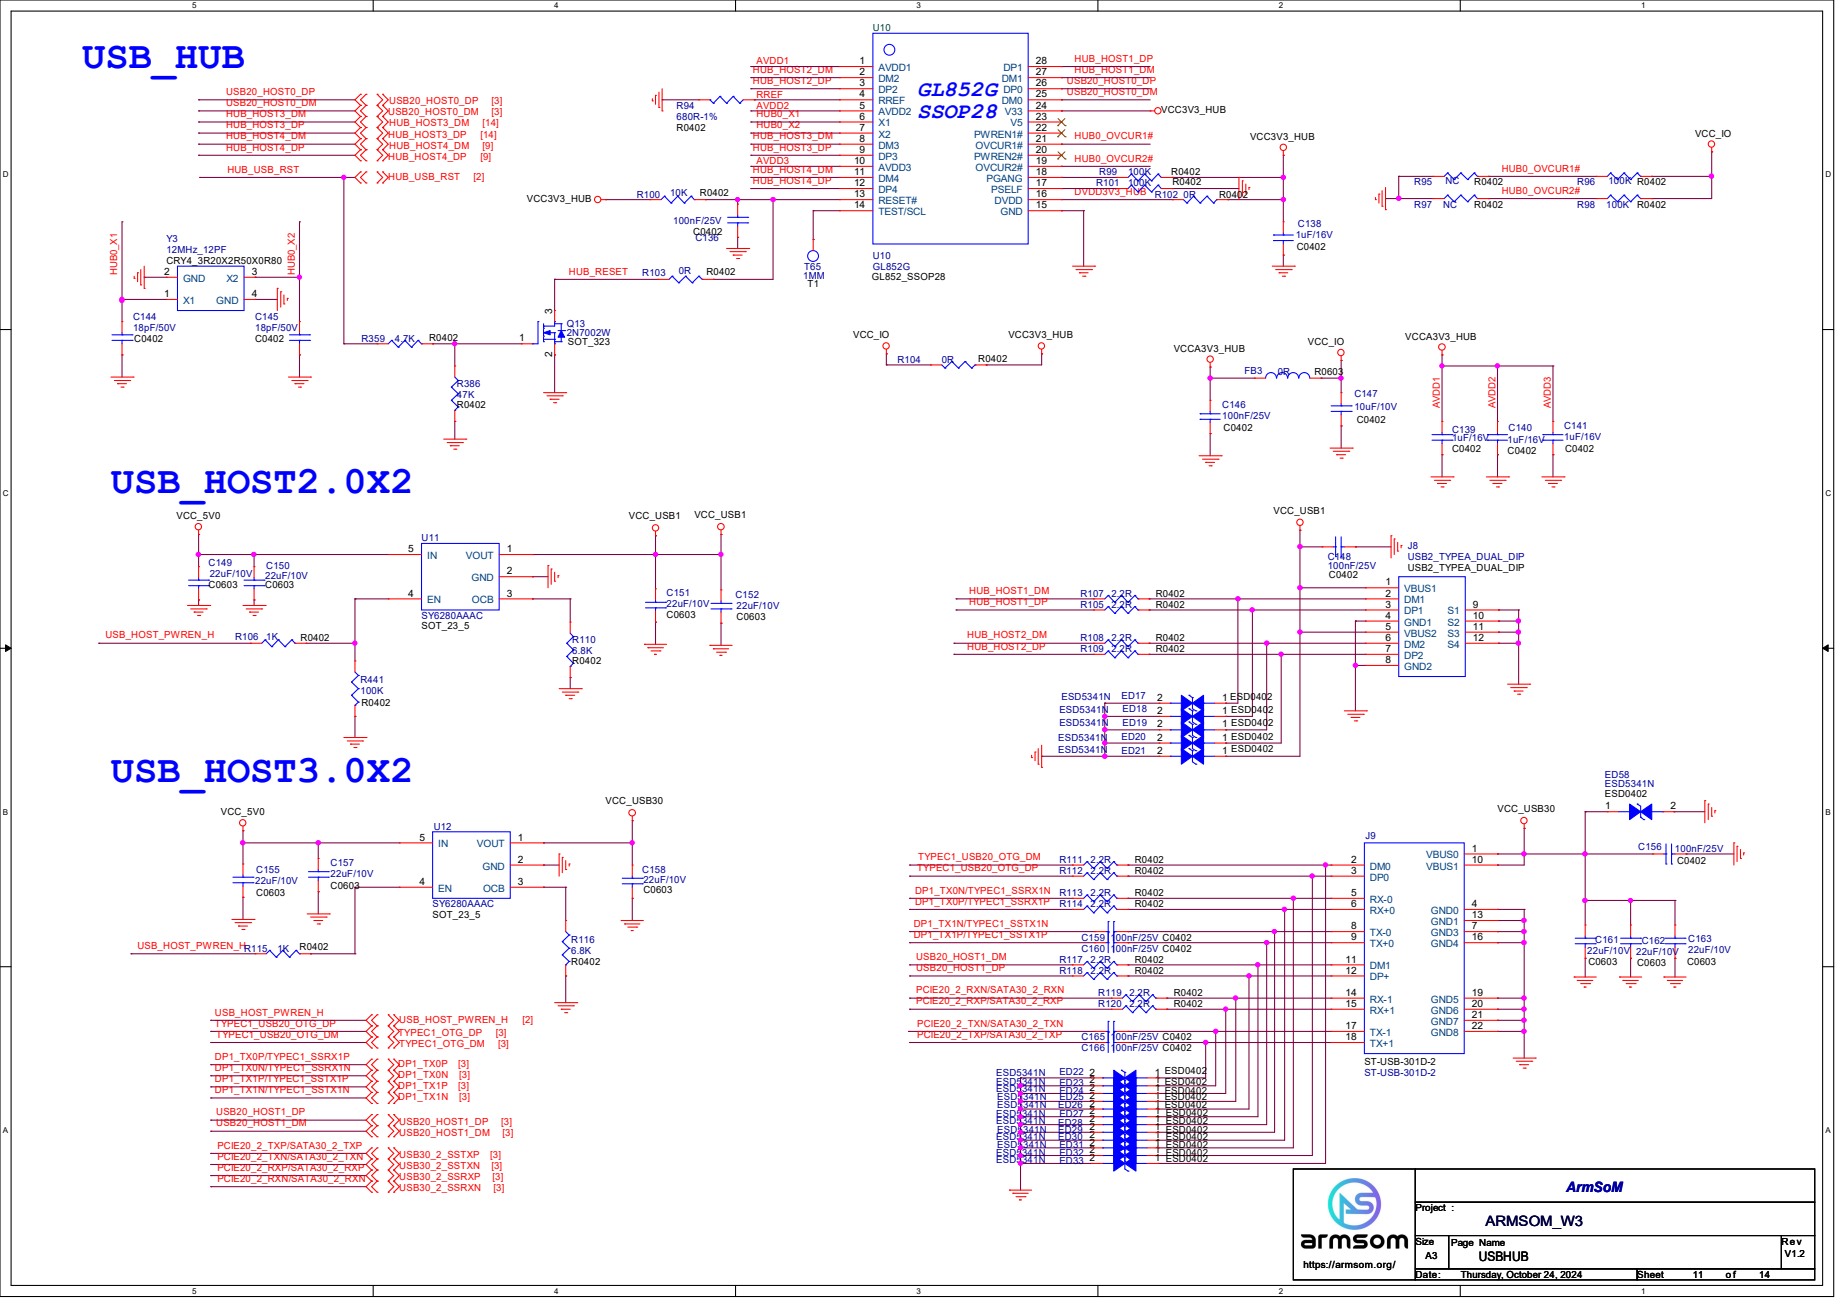
[picture p26: page 11]

U11 SY6280AAAC
SOT_23_5 OCB 3 GND 2 VOUT 1 EN 4

D D

# UART TO USB(DEBUG)

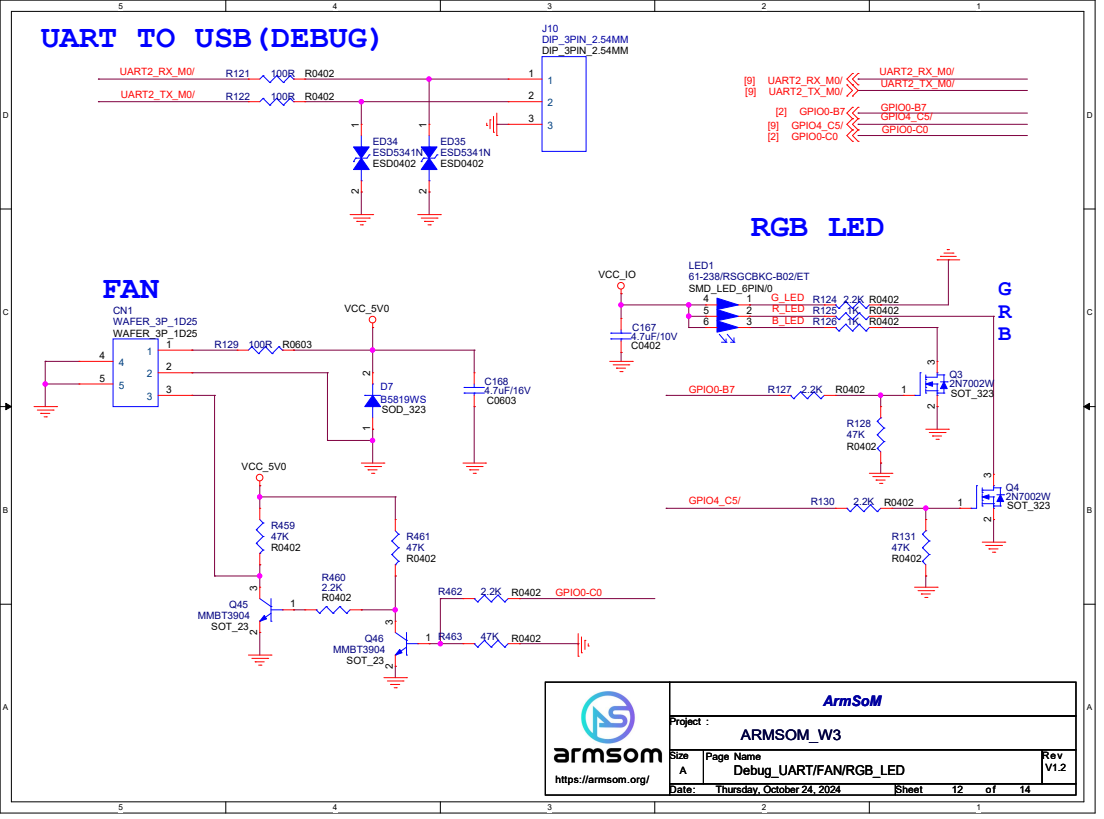
[picture p27: page 12]

# CSI_MIPI

## MIPI_CAM3_CLKOUT MIPI_CAM1_CLKOUT

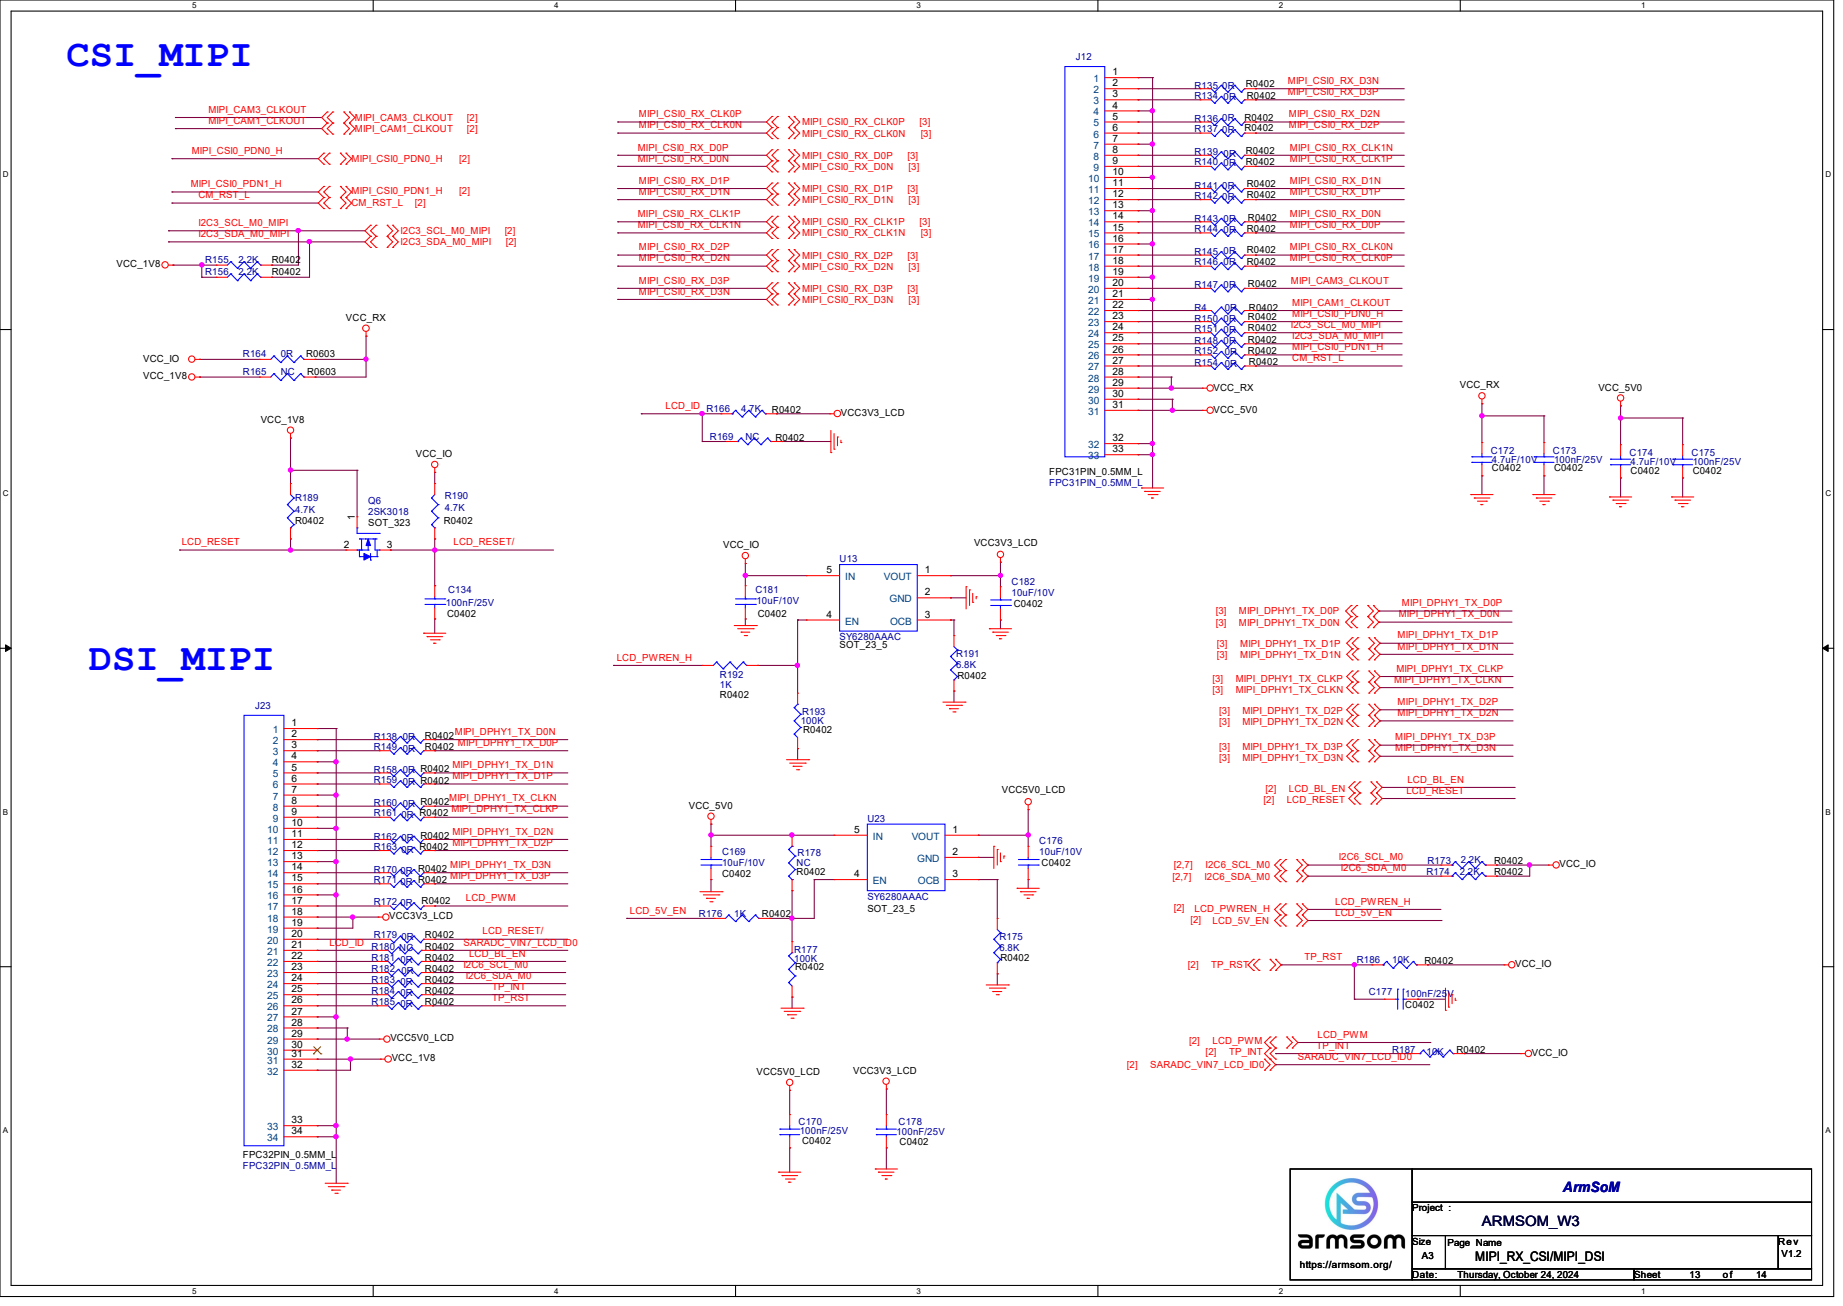
[picture p28: page 13]

U13 SY6280AAAC
SOT_23_5 OCB 3 GND 2 VOUT 1 EN 4

M.2 | NGFF
E_KEY J14 | M2_NGFF_KEY_E M2_NGFF_KEY_E/0

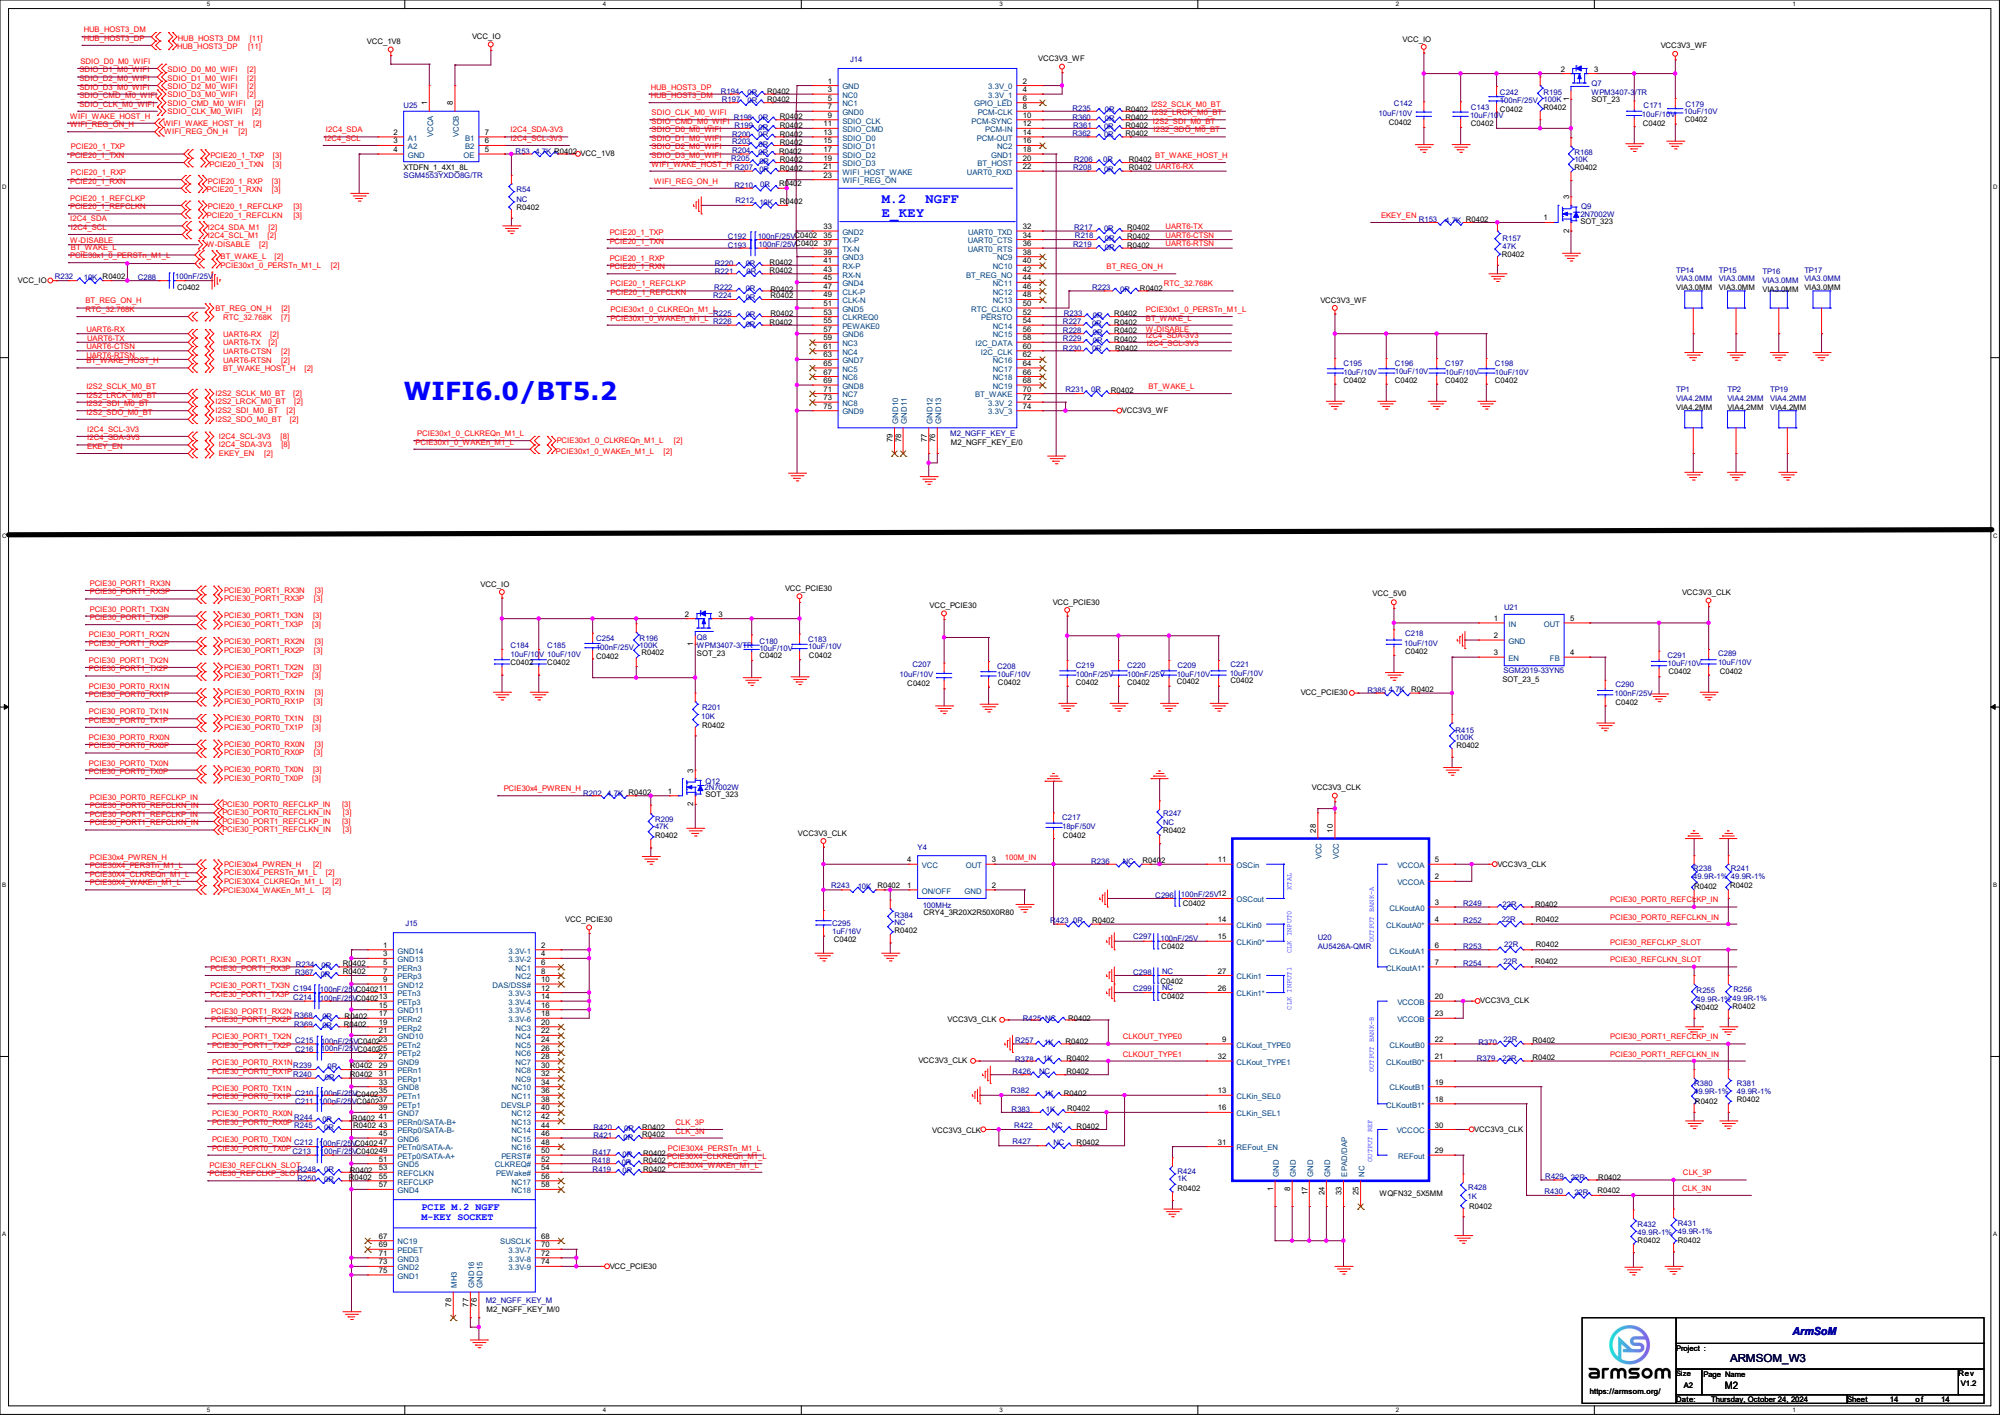
[picture p29: page 14]

I2C4_SDA_M1 [2]
I2C4_SCL_M1 [2] W-DISABLE [2] BT_WAKE_L [2] PCIE30x1_0_PERSTn_M1_L [2] RTC_32.768K [7] UART6-RX [2] UART6-TX [2] UART6-CTSN [2] UART6-RTSN [2] BT_WAKE_HOST_H [2]

75 GND¹³ 76 GND¹² 77 GND¹¹ 78 GND¹⁰ 79 C180
