as-jackson/-RK3588-Development-Board-/RK3588_Schematics/RK3588_sbc_ArmSoM-Sige7_1V1_20231218 Sch.pdf

## USB3.0

## Mean to Interface

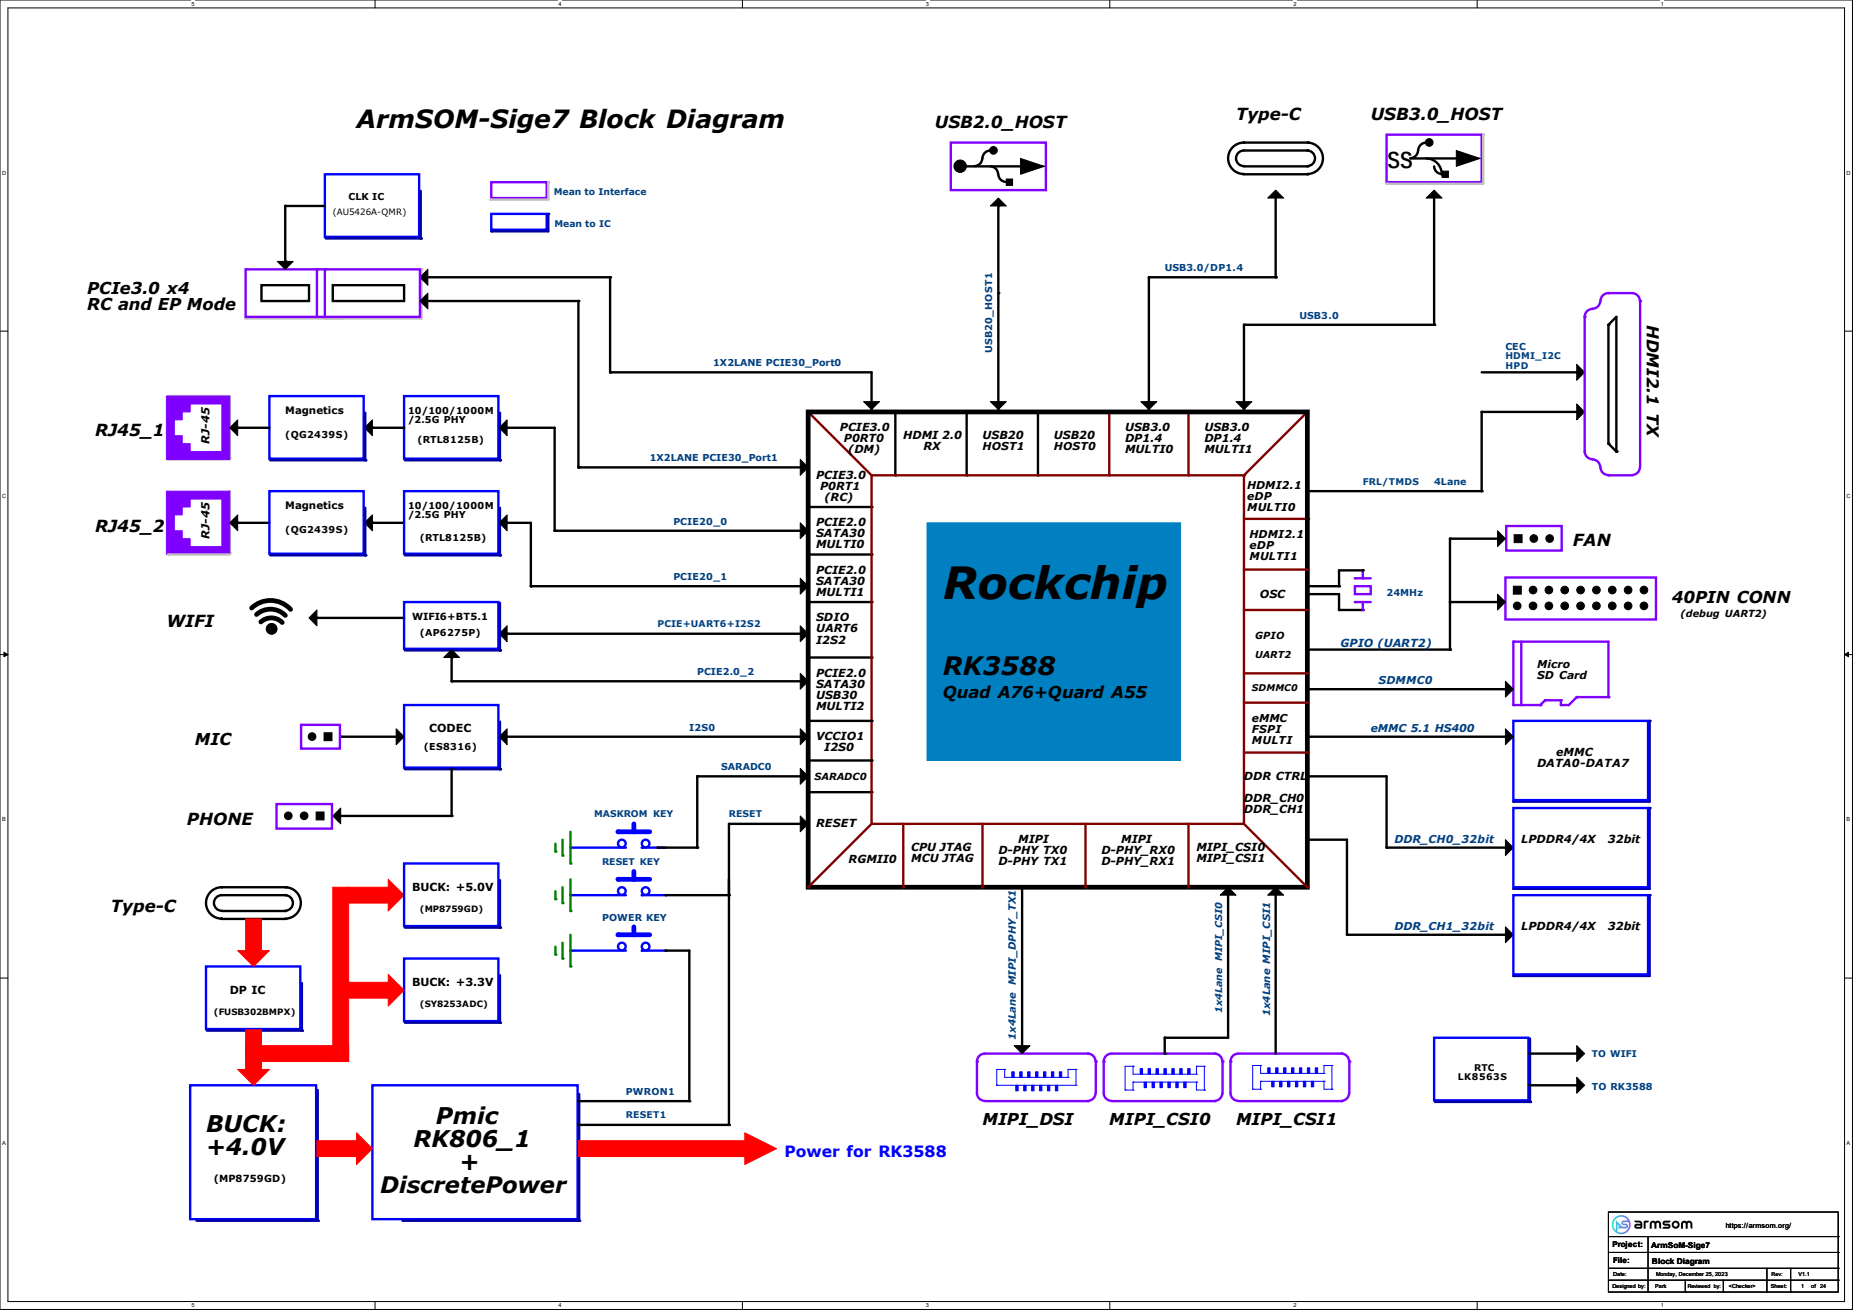
[picture p30: page 1]
WIFI; USB20_HOST1; 1x4Lane MIPI_CSI0; LPDDR4/4X 32bit; Type-C; HDMI 2.0 RX; MIPI_DSI; MIPI D-PHY TX0 D-PHY TX1 1x4Lane MIPI_DPHY_TX¹; BUCK: +4.0V; 1X2LANE PCIE30_Port1; 1X2LANE PCIE30_Port0; RESET1; PWRON1; RTC LK8563S; TO WIFI; DDR_CH1_32bit; MIPI_CSI1; MIPI_CSI0 MIPI_CSI1; RESET; Pmic RK806_1 + DiscretePower; Power for RK3588; SARADC0; HDMI2.1 eDP MULTI1; PHONE; CEC HDMI_I2C; HPD; HDMI2.1 TX; eMMC FSPI MULTI; Rockchip; Quad A76+Quard A55; HDMI2.1 eDP MULTI0; USB20 HOST0; OSC; VCCIO1 I2S0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

ArmSOM-Sige7 Block Diagram

Mean to IC

PCIe3.0 x4
RC and EP Mode

https://armsom.org/ Monday, December 25, 2023 Block Diagram

# RK3588_V(POWER)

# 100nF/10V C0201 C1040

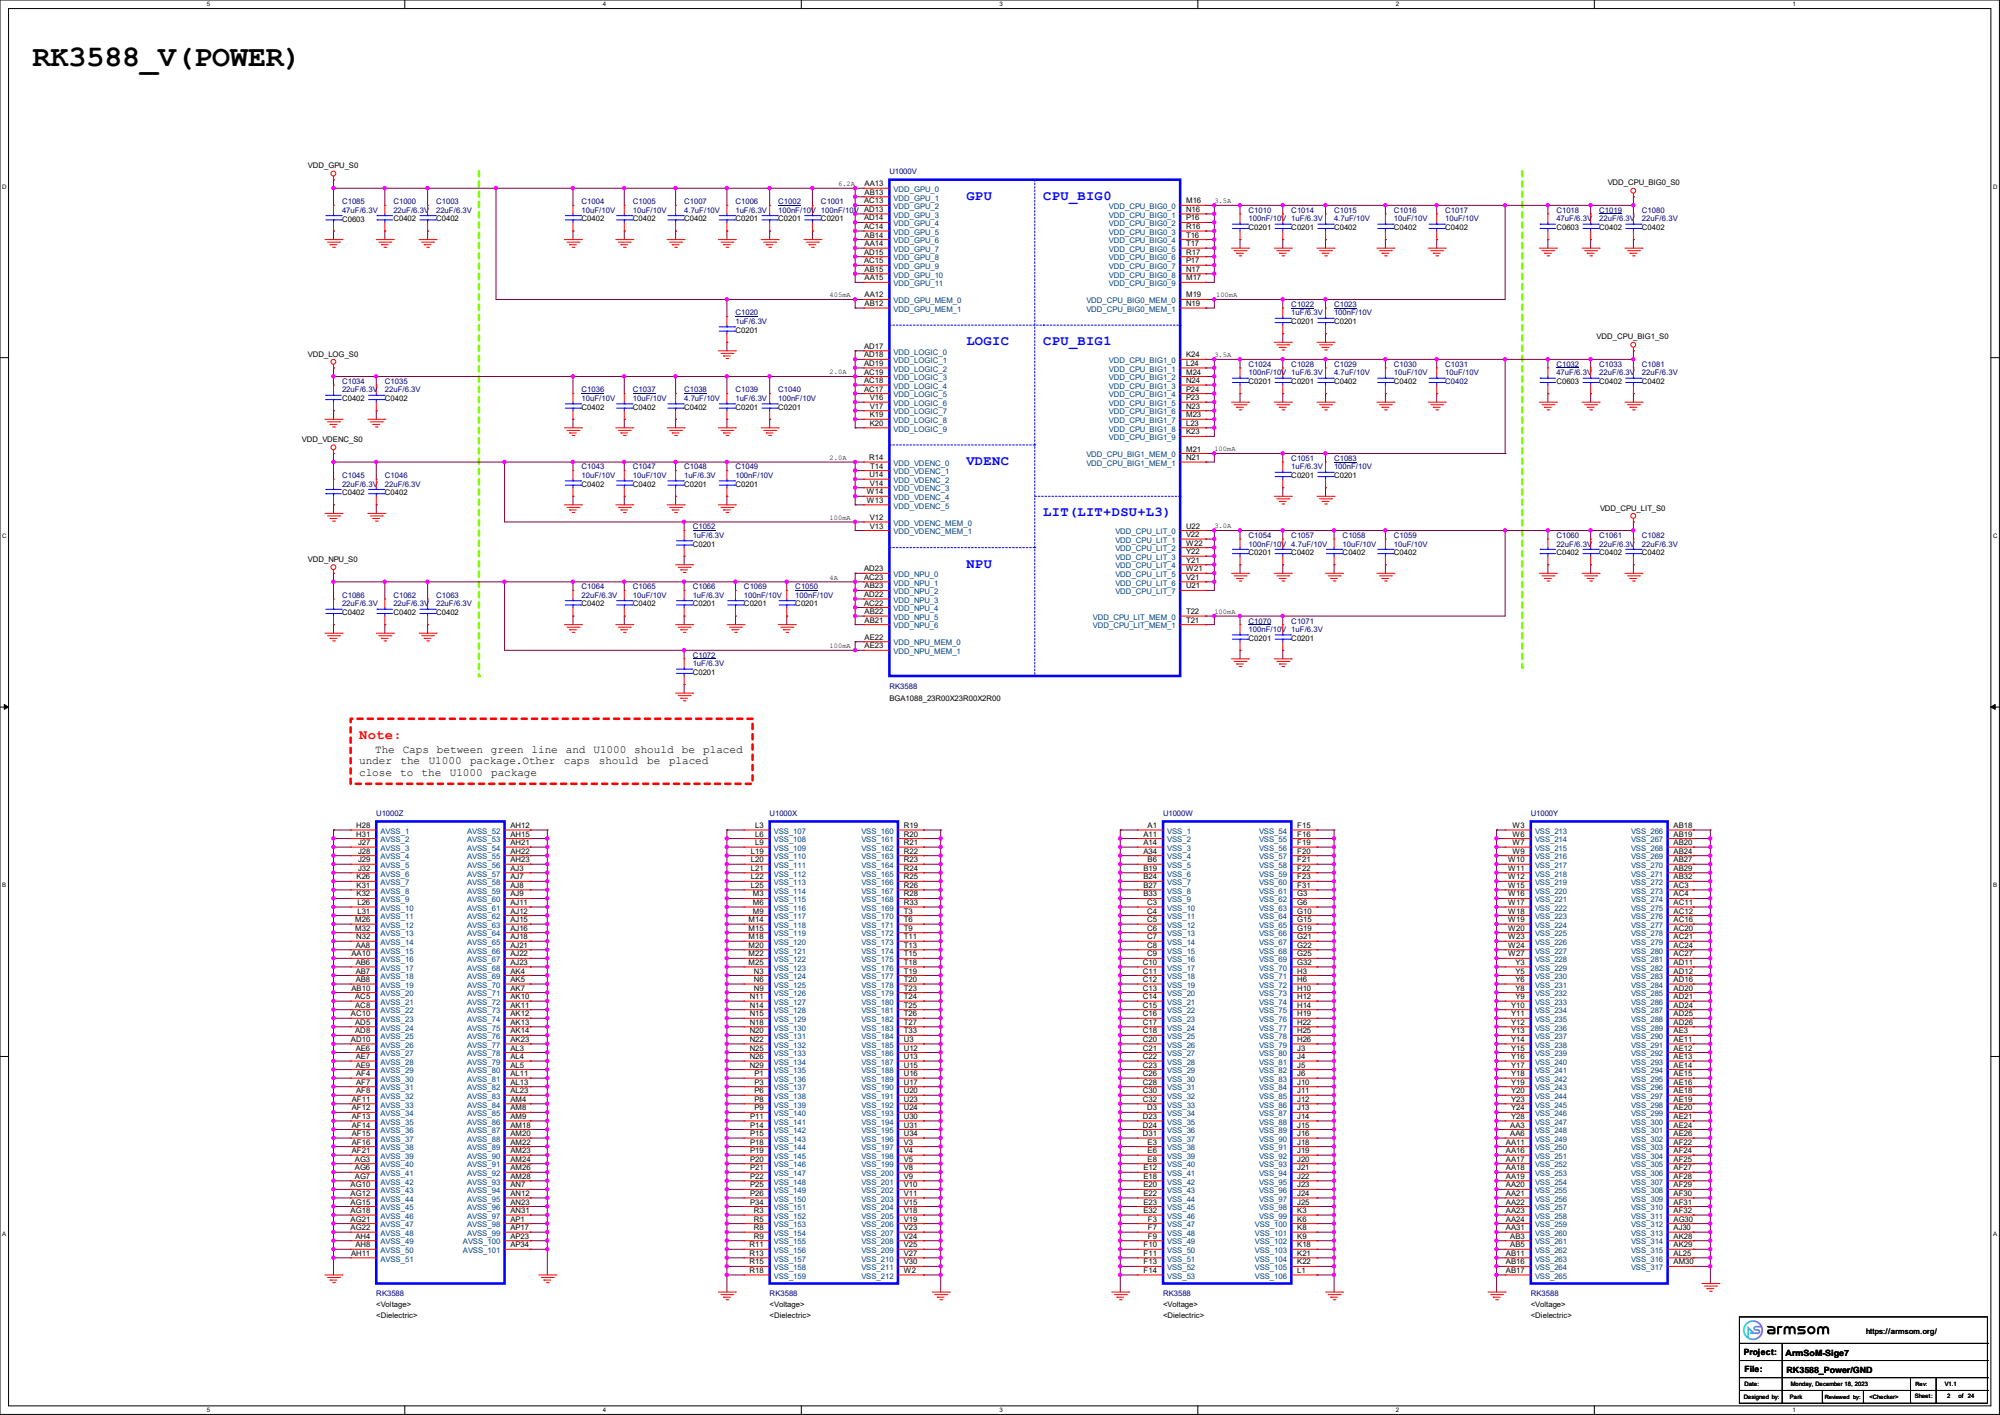
[picture p31: page 2]

close to the U1000 package VDD_NPU_S0 VDD_VDENC_S0

Note:
The Caps between green line and U1000 should be placed
under the U1000 package.Other caps should be placed
AVSS_52 AH12 AVSS_53 AH15 AVSS_54 AH21 AVSS_55 AH22 AVSS_56 AH23 AVSS_57 AJ3 AVSS_58 AJ7 AVSS_59 AJ8 AVSS_60 AJ9 AVSS_61 AJ11 AVSS_62 AJ12 AVSS_63 AJ15 AVSS_64 AJ16 AVSS_65 AJ18 AVSS_66 AJ21 AVSS_67 AJ22 AVSS_68 AJ23 AVSS_69 AK4 AVSS_70 AK5 AVSS_71 AK7 AVSS_72 AK10 AVSS_73 AK11 AVSS_74 AK12 AVSS_75 AK13 AVSS_76 AK14 AVSS_77 AK23 AVSS_78 AL3 AVSS_79 AL4 AVSS_80 AL5 AVSS_81 AL11 AVSS_82 AL13 AVSS_83 AL23 AVSS_84 AM4 AVSS_85 AM8 AVSS_86 AM9 AVSS_87 AM18 AVSS_88 AM20 AVSS_89 AM22 AVSS_90 AM23 AVSS_91 AM24 AVSS_92 AM26 AVSS_93 AM28 AVSS_94 AN7 AVSS_95 AN12 AVSS_96 AN23 AVSS_97 AN31 AVSS_98 AP1 AVSS_99 AP17 AVSS_100 AP23 AVSS_101 AP34
L31 AVSS_12 M26 AVSS_13 M32 AVSS_14 N32 AVSS_15 AA8 AVSS_16 AA10 AVSS_17 AB6 AVSS_18 AB7 AVSS_19 AB8 AVSS_20 AB10 AVSS_21 AC5 AVSS_22 AC8 AVSS_23 AC10 AVSS_24 AD5 AVSS_25 AD8 AVSS_26 AD10 AVSS_27 AE6 AVSS_28 AE7 AVSS_29 AE9 AVSS_30 AF4 AVSS_31 AF7 AVSS_32 AF8 AVSS_33 AF11 AVSS_34 AF12 AVSS_35 AF13 AVSS_36 AF14 AVSS_37 AF15 AVSS_38 AF16 AVSS_39 AF21 AVSS_40 AG3 AVSS_41 AG6 AVSS_42 AG7 AVSS_43 AG10 AVSS_44 AG12 AVSS_45 AG15 AVSS_46 AG18 AVSS_47 AG21 AVSS_48 AG22 AVSS_49 AH4 AVSS_50 AH8 AVSS_51 AH11

https://armsom.org/ Monday, December 18, 2023 RK3588_Power/GND

# RK3588_E(OSC/PLL/PMUIO1/2)

# Adjusted the load capacitance

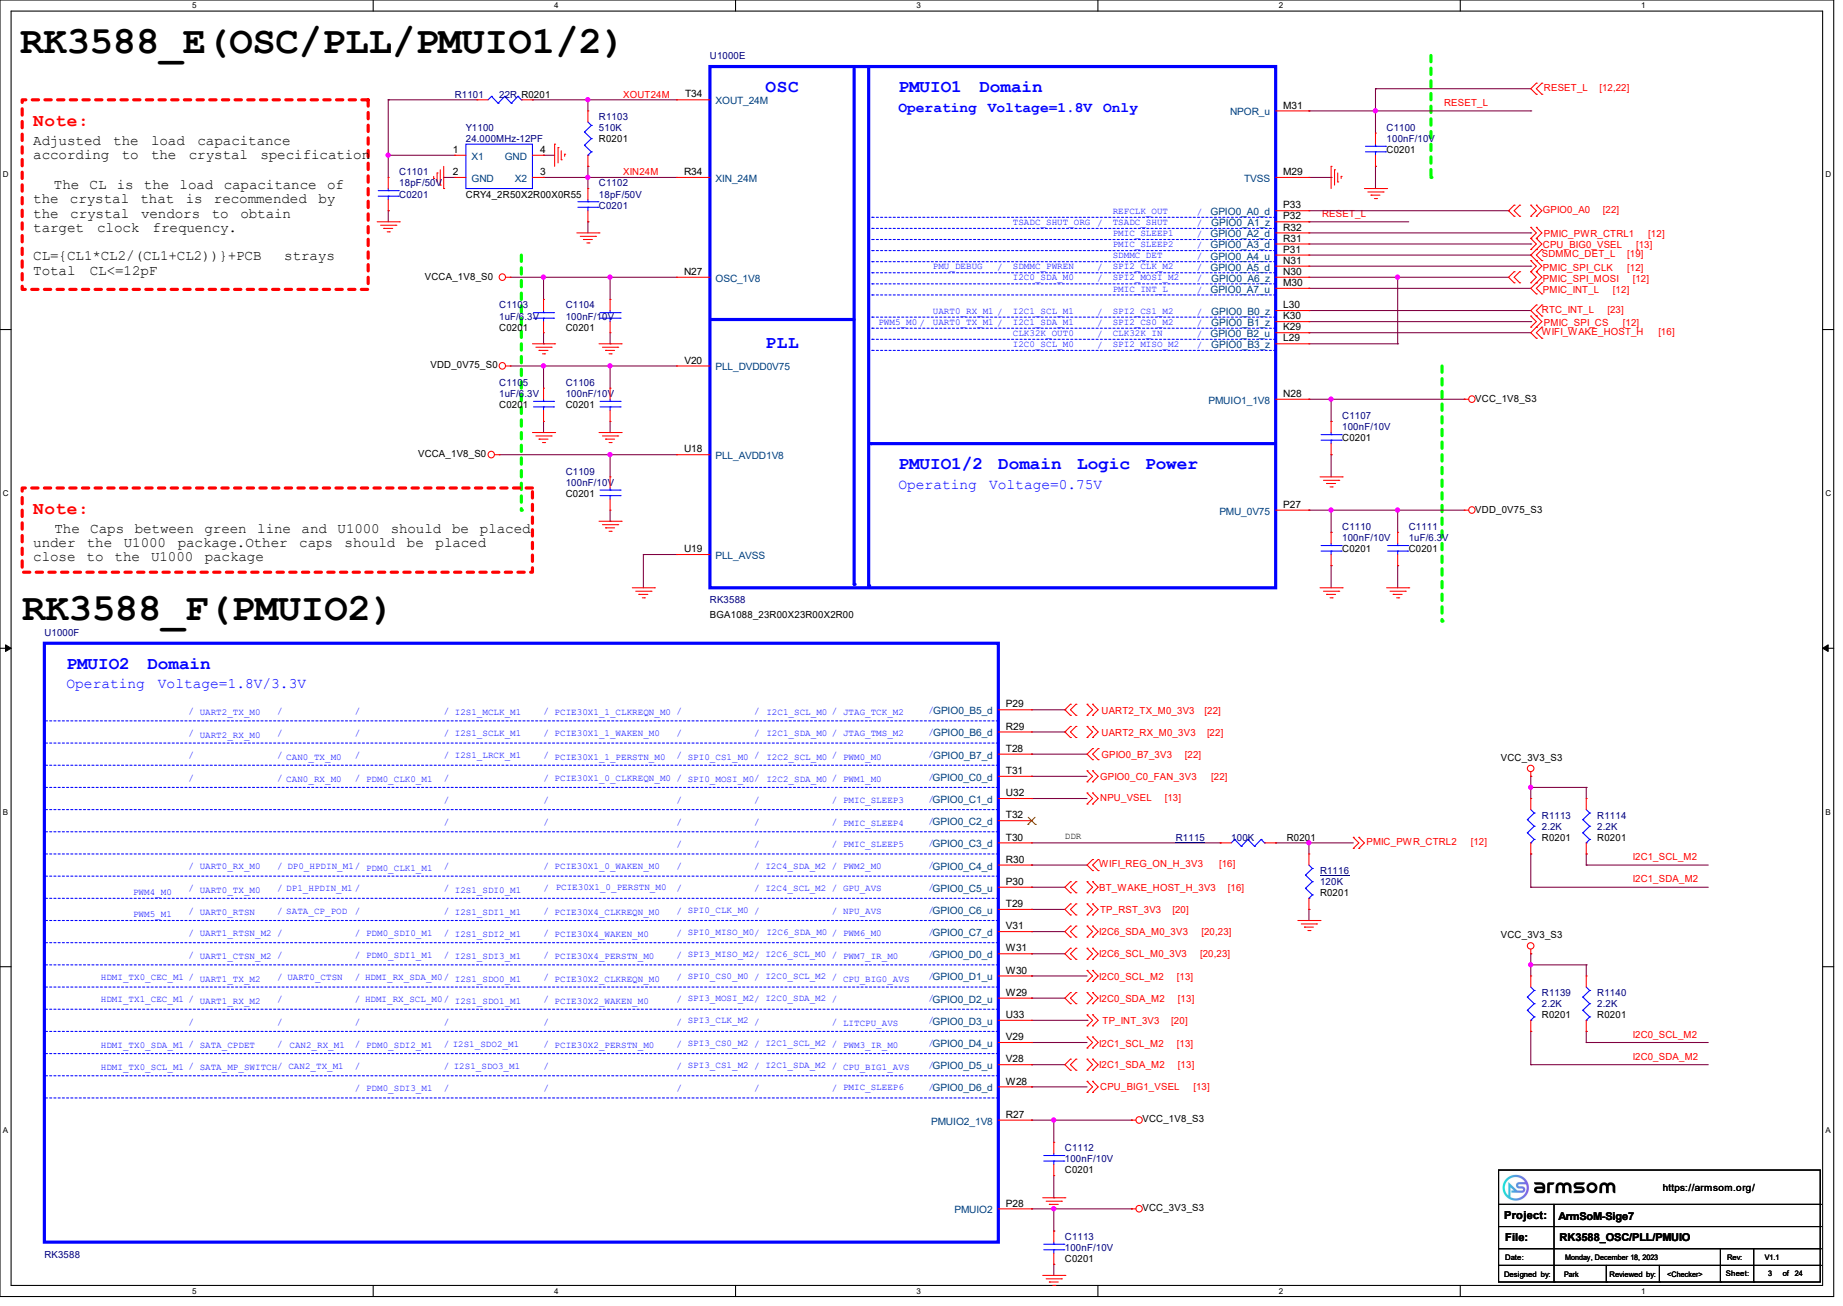
[picture p32: page 3]

according to the crystal specification
The CL is the load capacitance of
the crystal that is recommended by
the crystal vendors to obtain
target clock frequency.
Total CL<=12pF

Note:
The Caps between green line and U1000 should be placed
under the U1000 package.Other caps should be placed
close to the U1000 package
RK3588_F(PMUIO2)

https://armsom.org/ Monday, December 18, 2023 RK3588_OSC/PLL/PMUIO

## [14] DDR_CH1_DM0_C [14] DDR_CH1_DM1_C

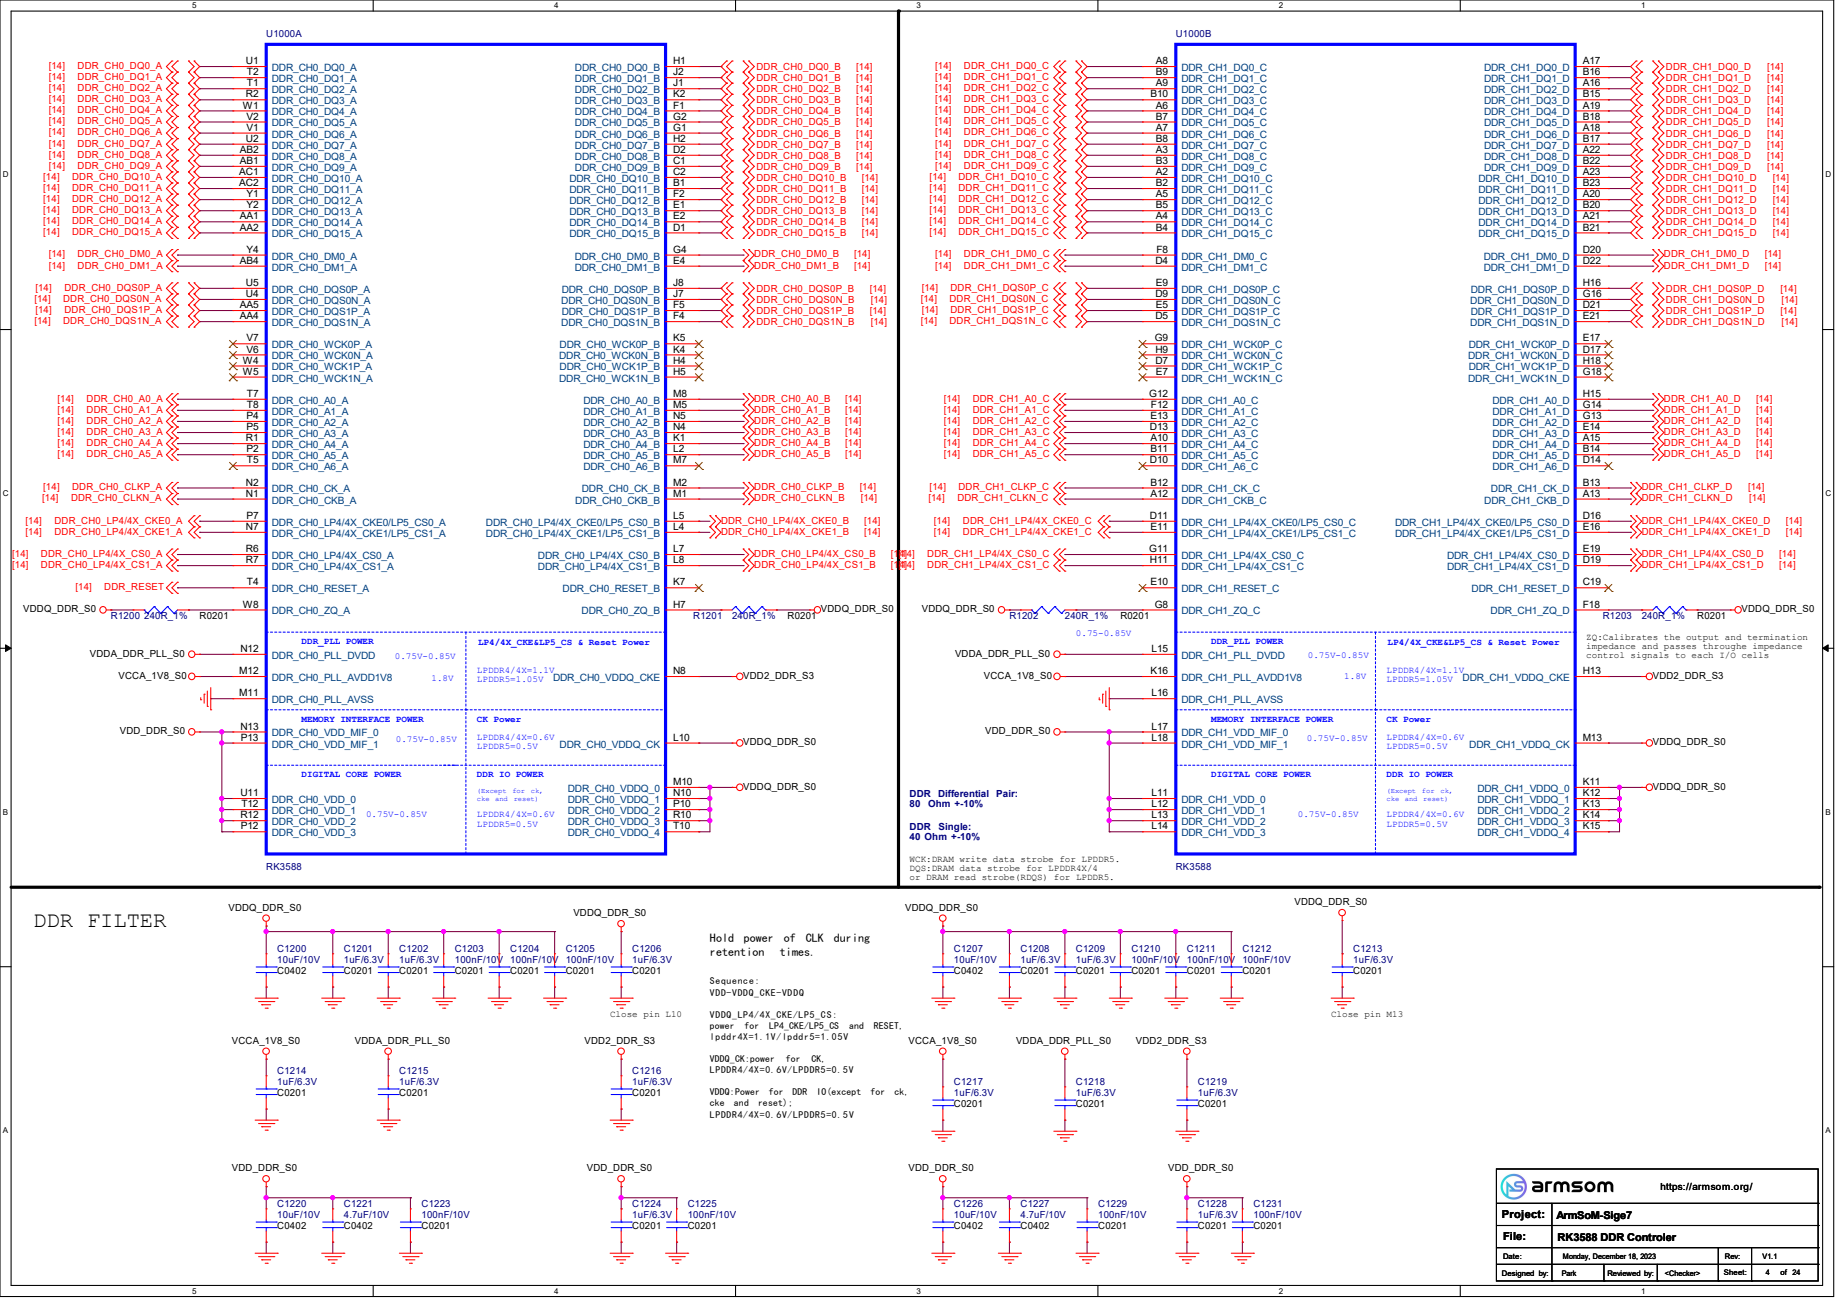
[picture p33: page 4]

ZQ:Calibrates the output and termination
impedance and passes throughe impedance
control signals to each I/O cells

WCK:DRAM write data strobe for LPDDR5.
DQS:DRAM data strobe for LPDDR4X/4
or DRAM read strobe(RDQS) for LPDDR5.

Hold power of CLK during

power for LP4_CKE/LP5_CS and RESET,
lpddr4X=1.1V/lpddr5=1.05 V

VDDQ:Power for DDR IO(except for ck,
cke and reset);
LPDDR4/4X=0.6V/LPDDR5=0. 5V

D D

# RK3588_C(EMMCIO Domain)

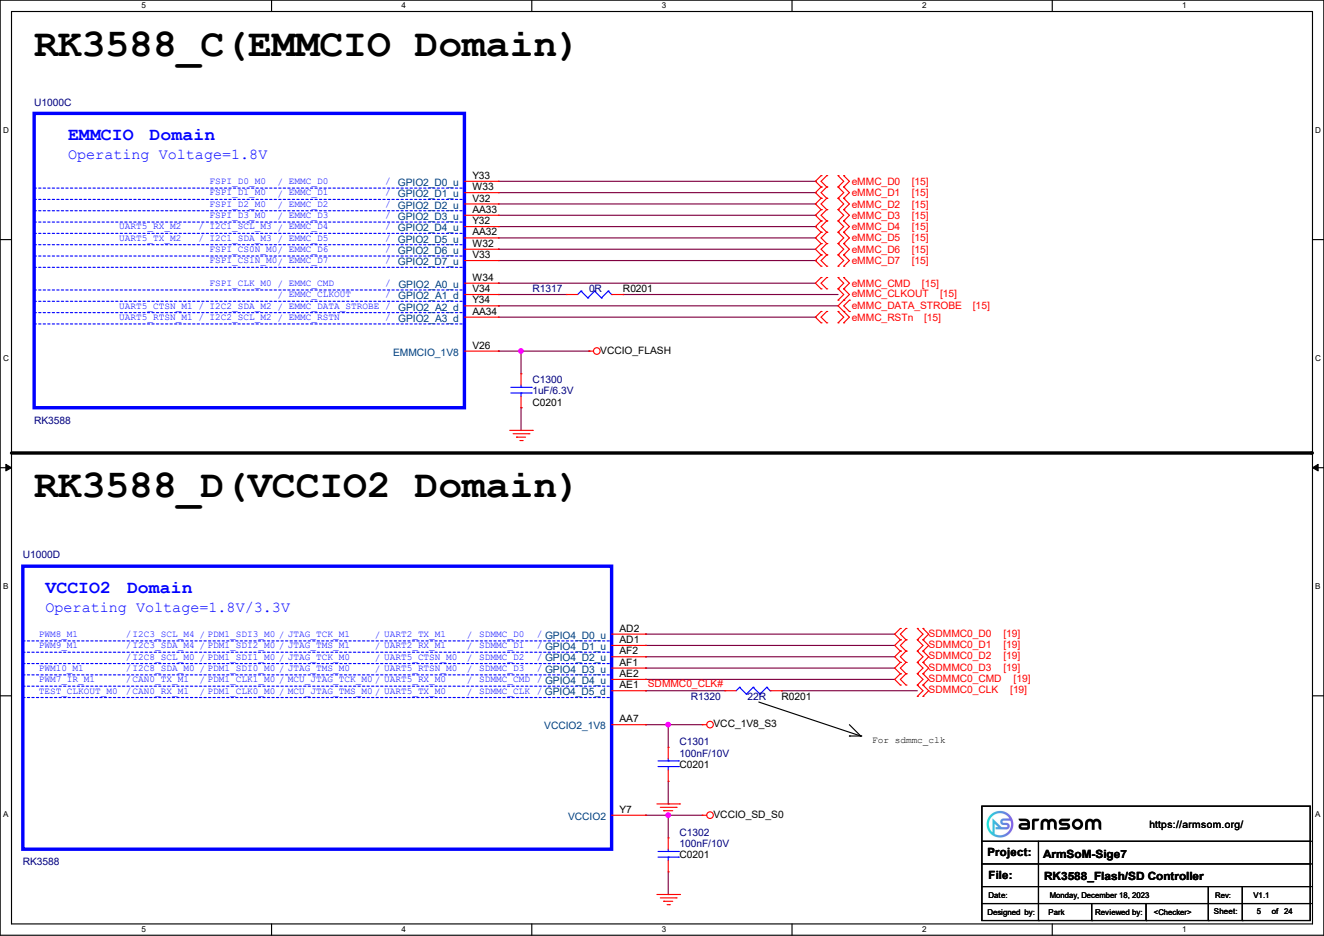
[picture p34: page 5]

RK3588_M(TYPEC/DP) | RK3588_L(USB2.0 HOST/OTG)

<=3.3V

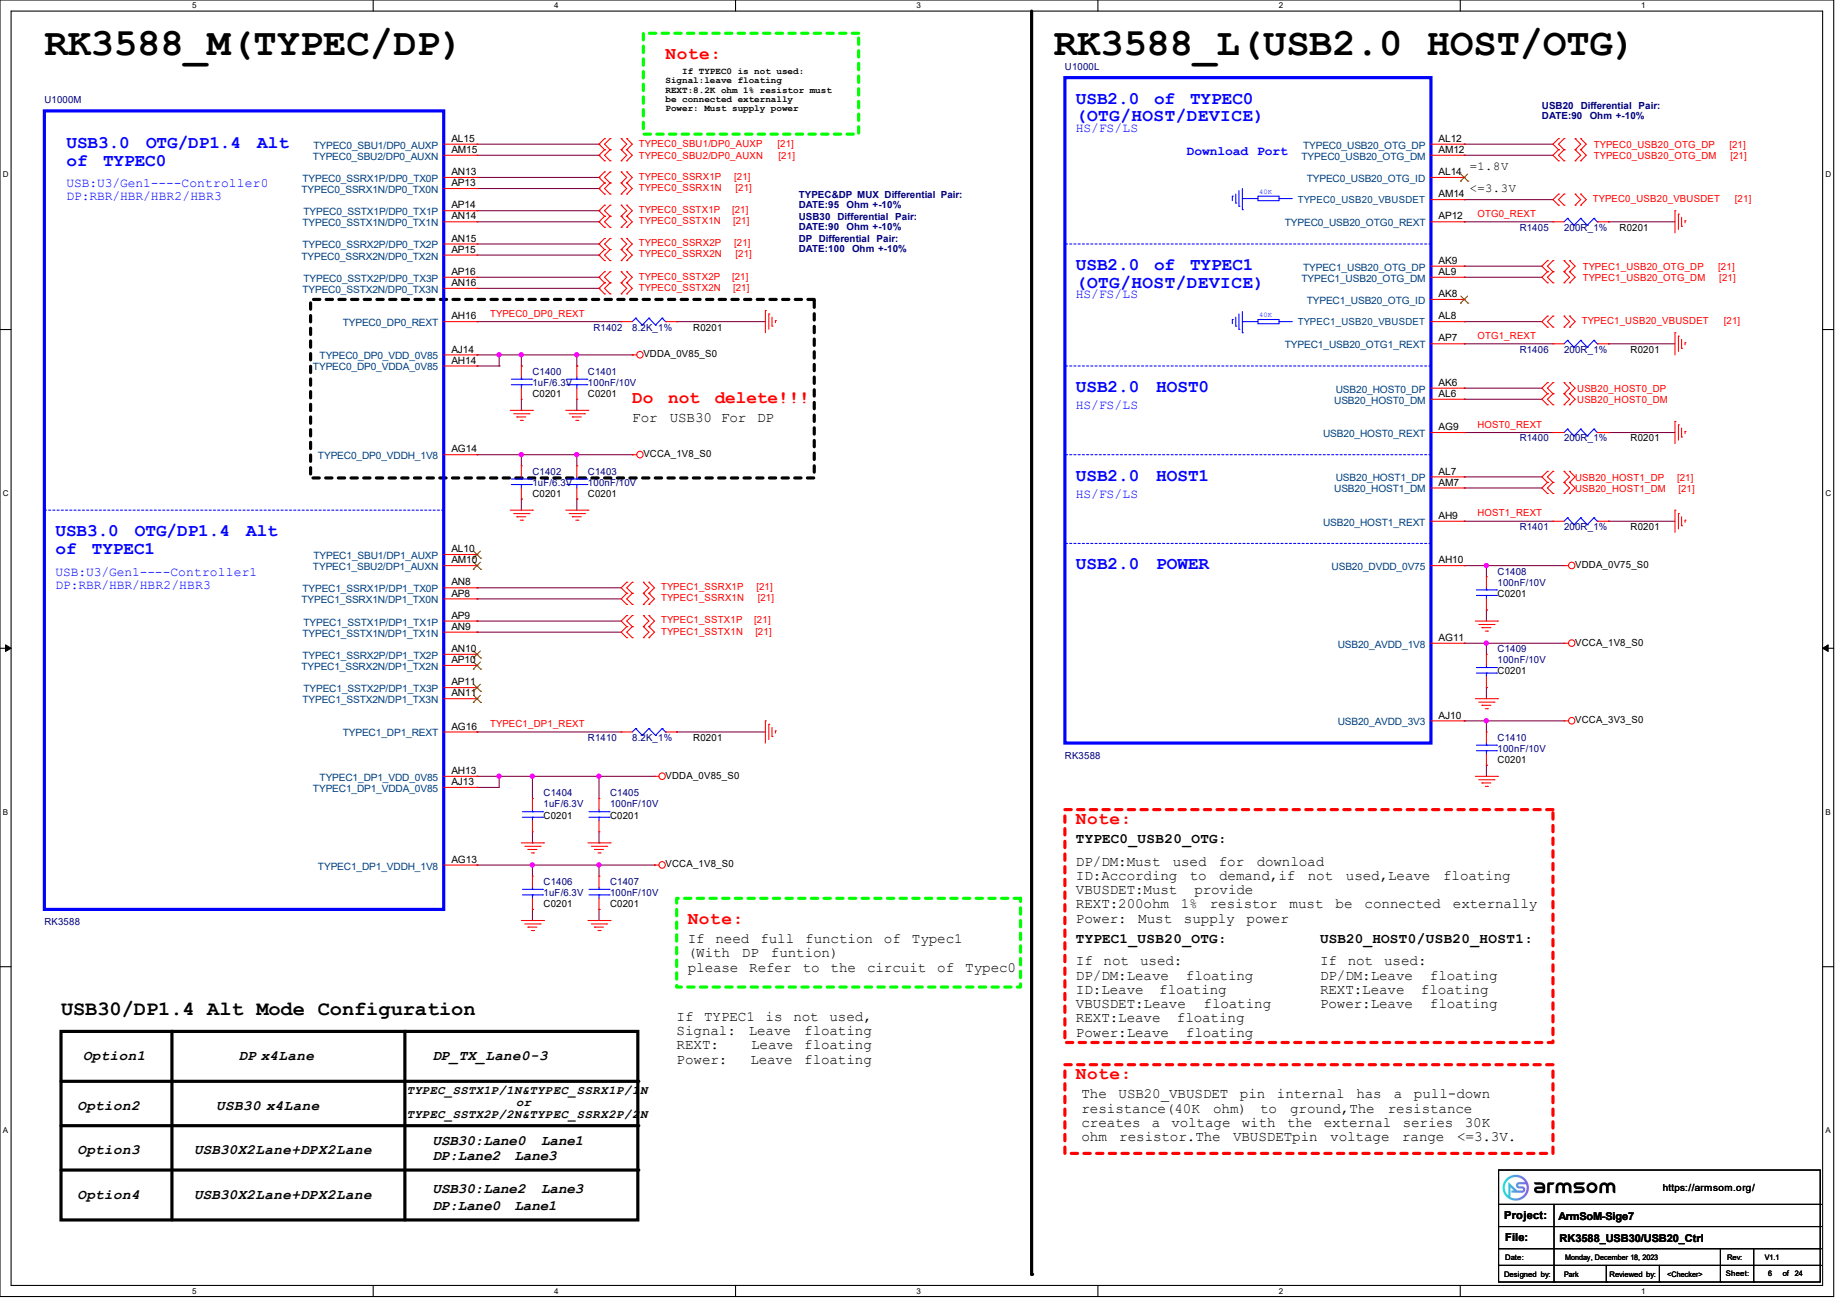
[picture p35: page 6]

If TYPEC0 is not used:
Signal:leave floating
REXT:8.2K ohm 1% resistor must
be connected externally
Power: Must supply power

TYPEC&DP MUX Differential Pair:
DATE:95 Ohm +-10%
USB30 Differential Pair:
DATE:90 Ohm +-10%
DP Differential Pair:
DATE:100 Ohm +-10%

Note:
TYPEC0_USB20_OTG:
DP/DM:Must used for download
ID:According to demand,if not used,Leave floating
VBUSDET:Must provide
REXT:200ohm 1% resistor must be connected externally
TYPEC1_USB20_OTG:
If not used:
DP/DM:Leave floating
ID:Leave floating
VBUSDET:Leave floating
REXT:Leave floating
Power:Leave floating

If need full function of Typec1
(With DP funtion)
please Refer to the circuit of Typec0

USB20_HOST0/USB20_HOST1:

If TYPEC1 is not used,
Signal: Leave floating

The USB20_VBUSDET pin internal has a pull-down
resistance(40K ohm) to ground,The resistance
creates a voltage with the external series 30K
ohm resistor.The VBUSDETpin voltage range <=3.3V.

https://armsom.org/ Monday, December 18, 2023 RK3588_USB30/USB20_Ctrl

RK3588_G(VCCIO1 Domain) | RK3588_U(SARADC/OTP)

# Must floating

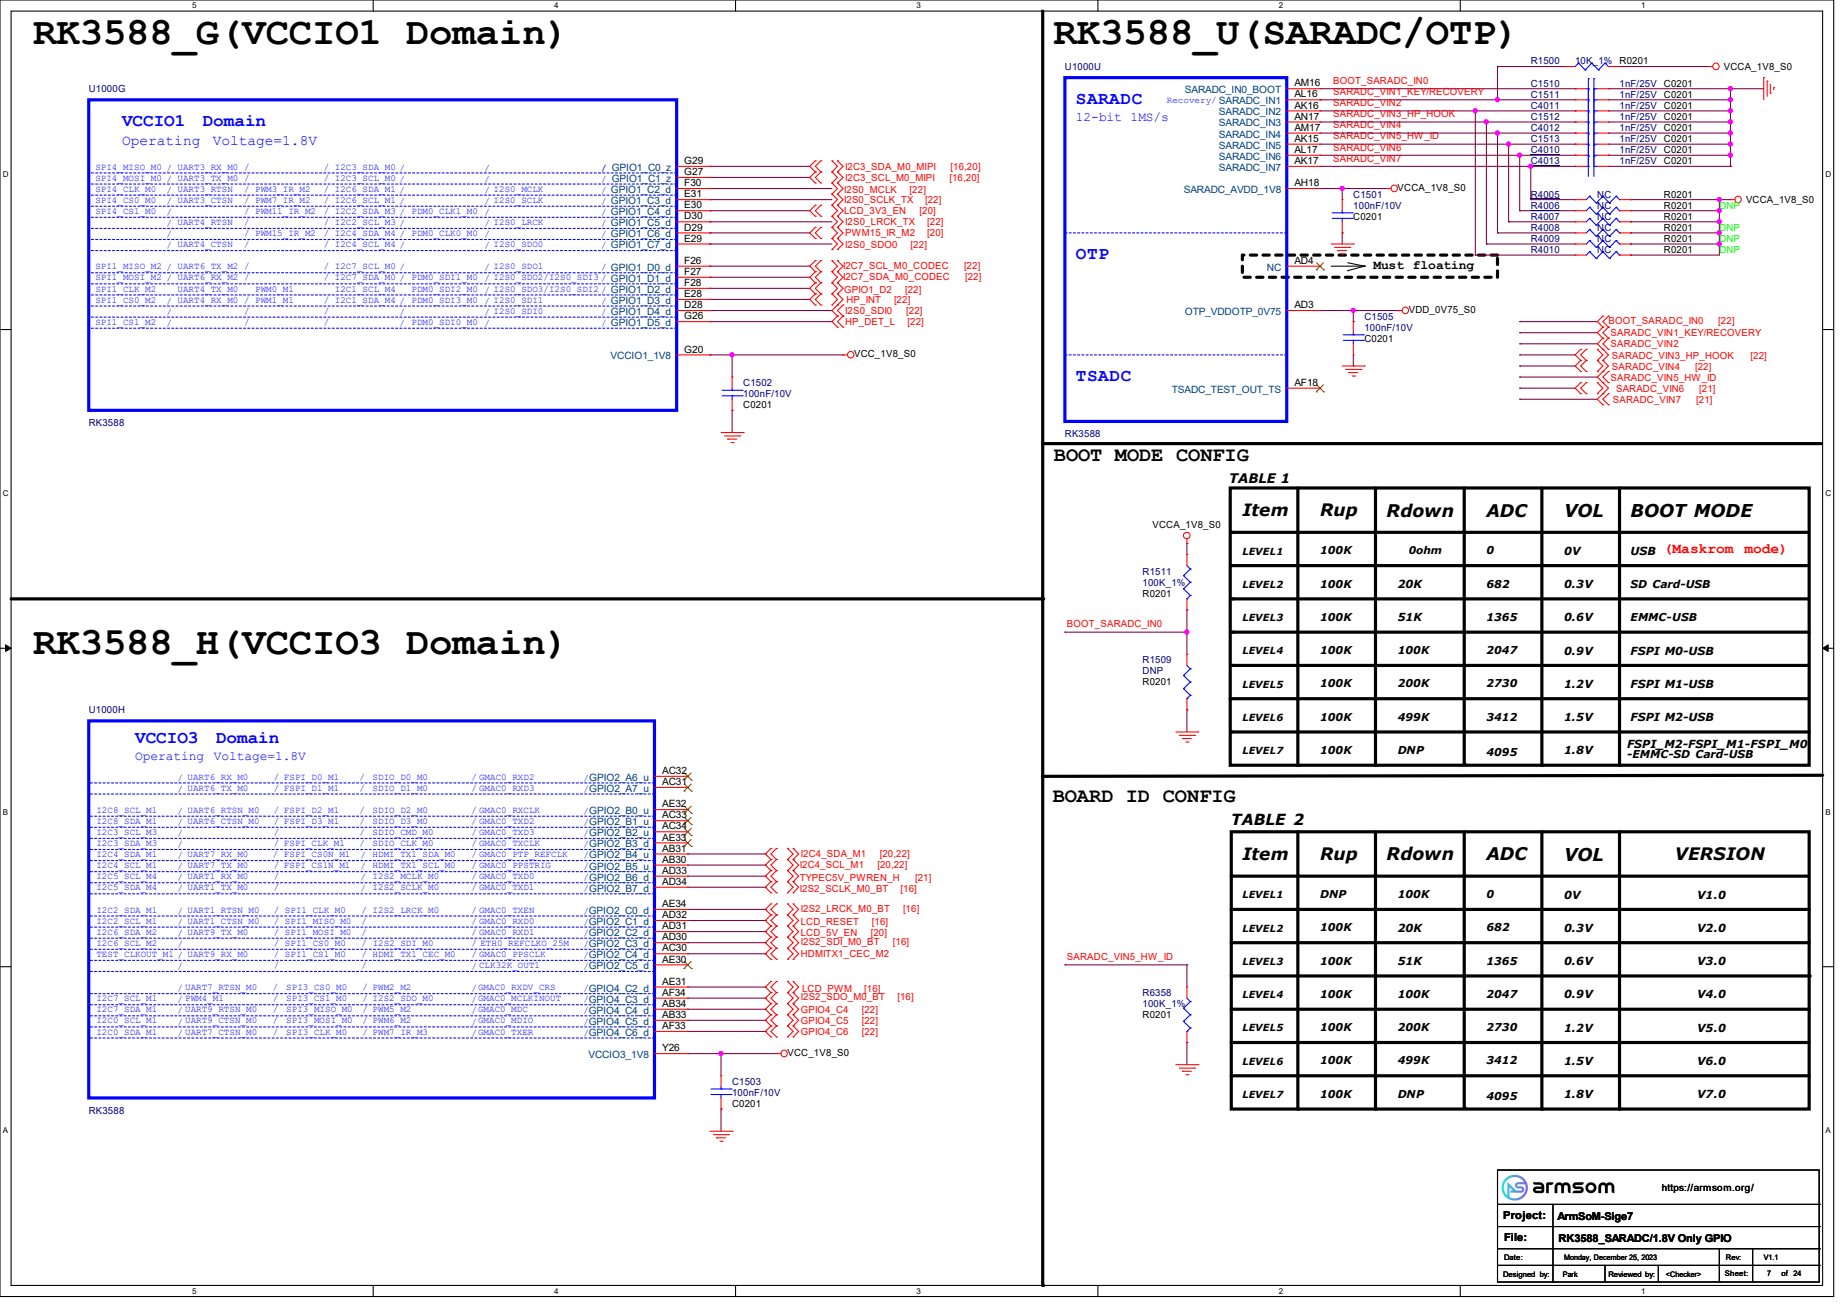
[picture p36: page 7]

FSPI_M2-FSPI_M1-FSPI_M0
-EMMC-SD Card-USB

https://armsom.org/ Monday, December 25, 2023 RK3588_SARADC/1.8V Only GPIO

# RK3588_Q/R(MIPI_D/C_PHY0/1)

### MIPI CPHY Single:

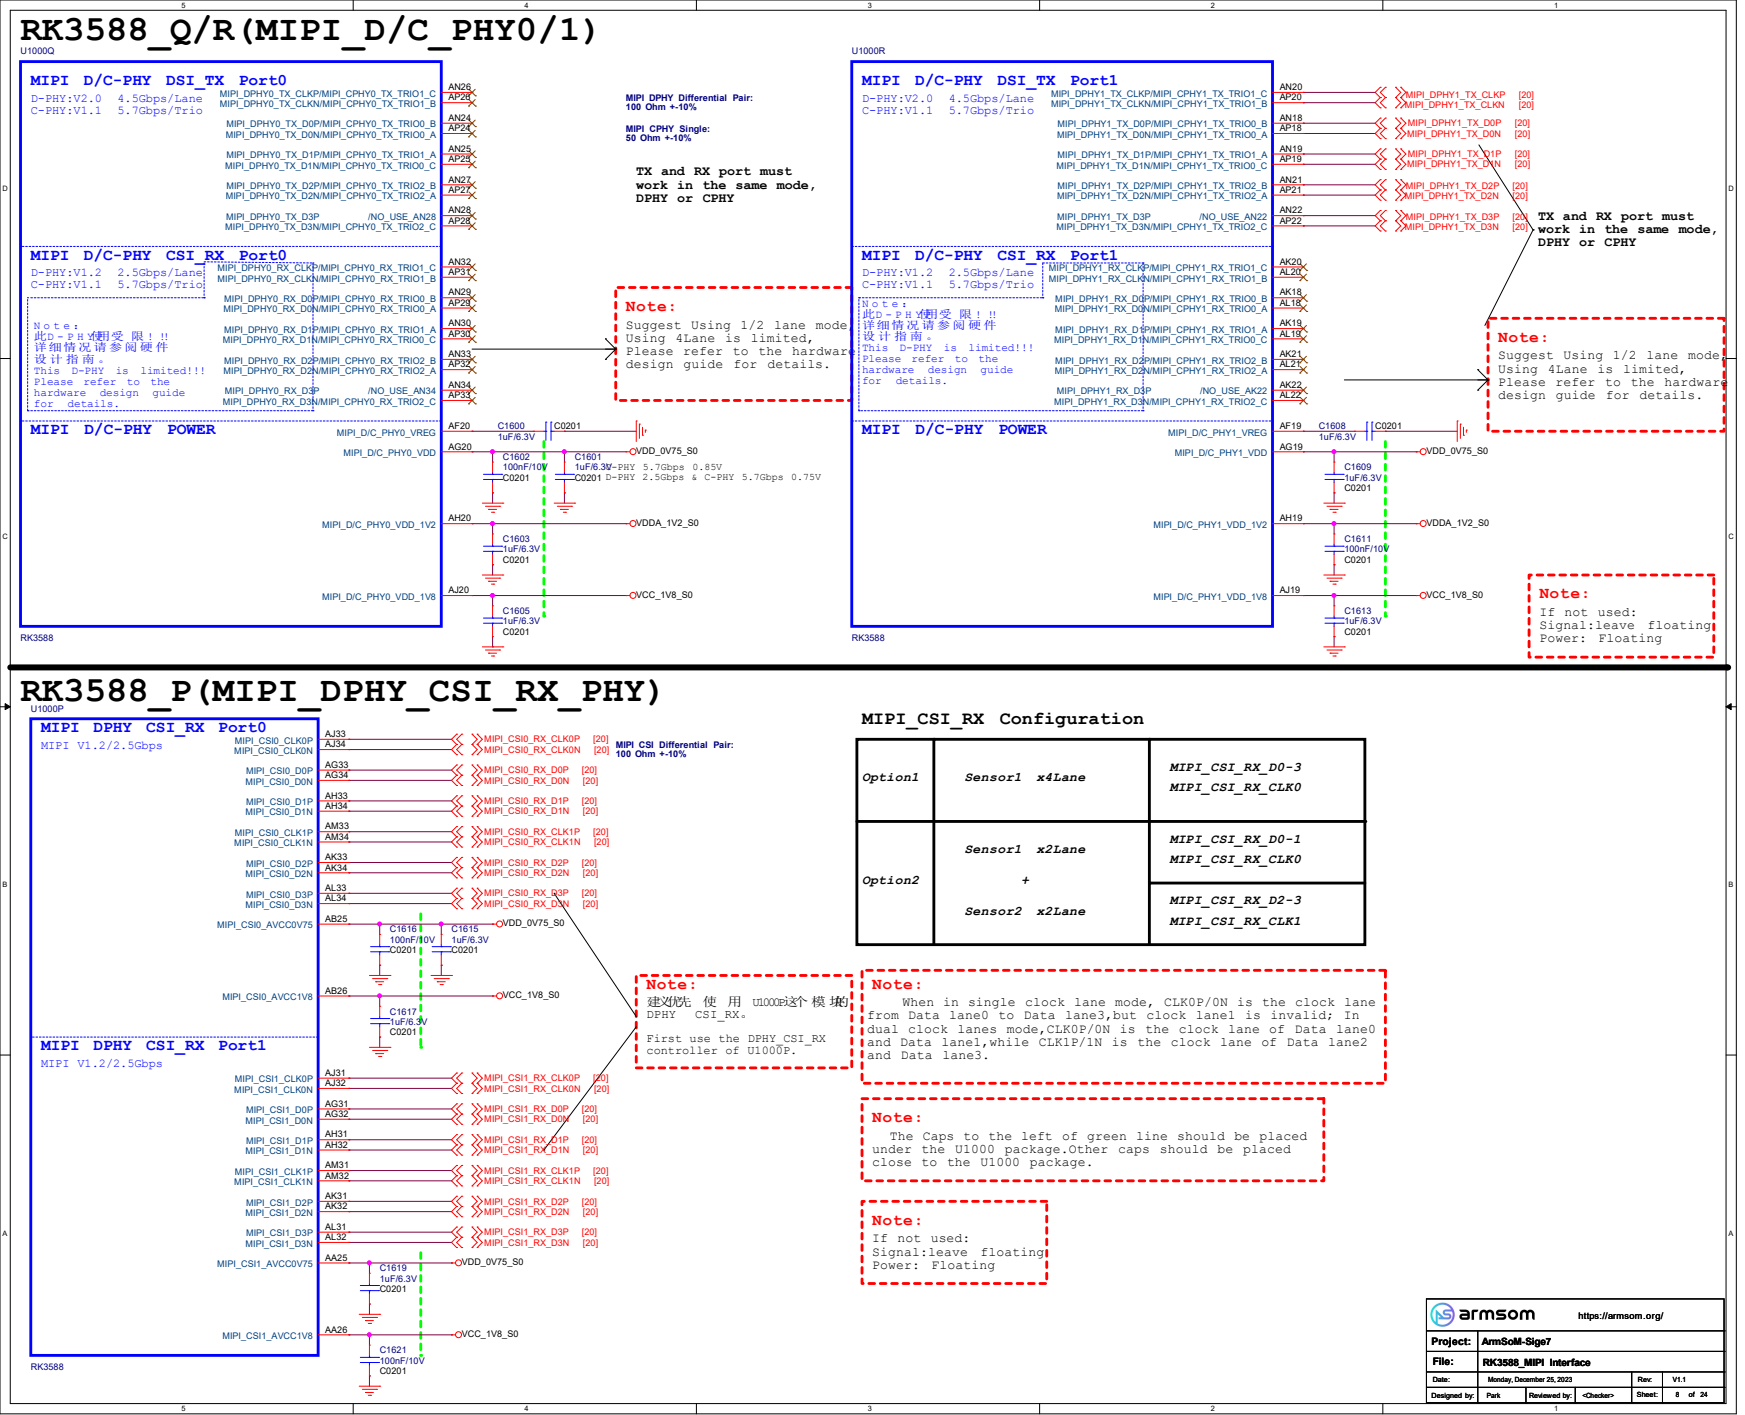
[picture p37: page 8]

MIPI DPHY Differential Pair:
100 Ohm +-10%

TX and RX port must
work in the same mode,

DPHY or CPHY

Note:
Suggest Using 1/2 lane mode,
Using 4Lane is limited,
Please refer to the hardware
design guide for details.

This D-PHY is limited!!!
Please refer to the
hardware design guide

VDD_0V75_S0 VCC_1V8_S0 VDDA_1V2_S0

MIPI CSI Differential Pair:

When in single clock lane mode, CLK0P/0N is the clock lane
from Data lane0 to Data lane3,but clock lane1 is invalid; In
dual clock lanes mode,CLK0P/0N is the clock lane of Data lane0
and Data lane1,while CLK1P/1N is the clock lane of Data lane2
and Data lane3.

The Caps to the left of green line should be placed
under the U1000 package.Other caps should be placed
close to the U1000 package.

RK3588_S(HDMI2.1 TX) | RK3588_T(HDMI20 RX)

# HDMI20_RX

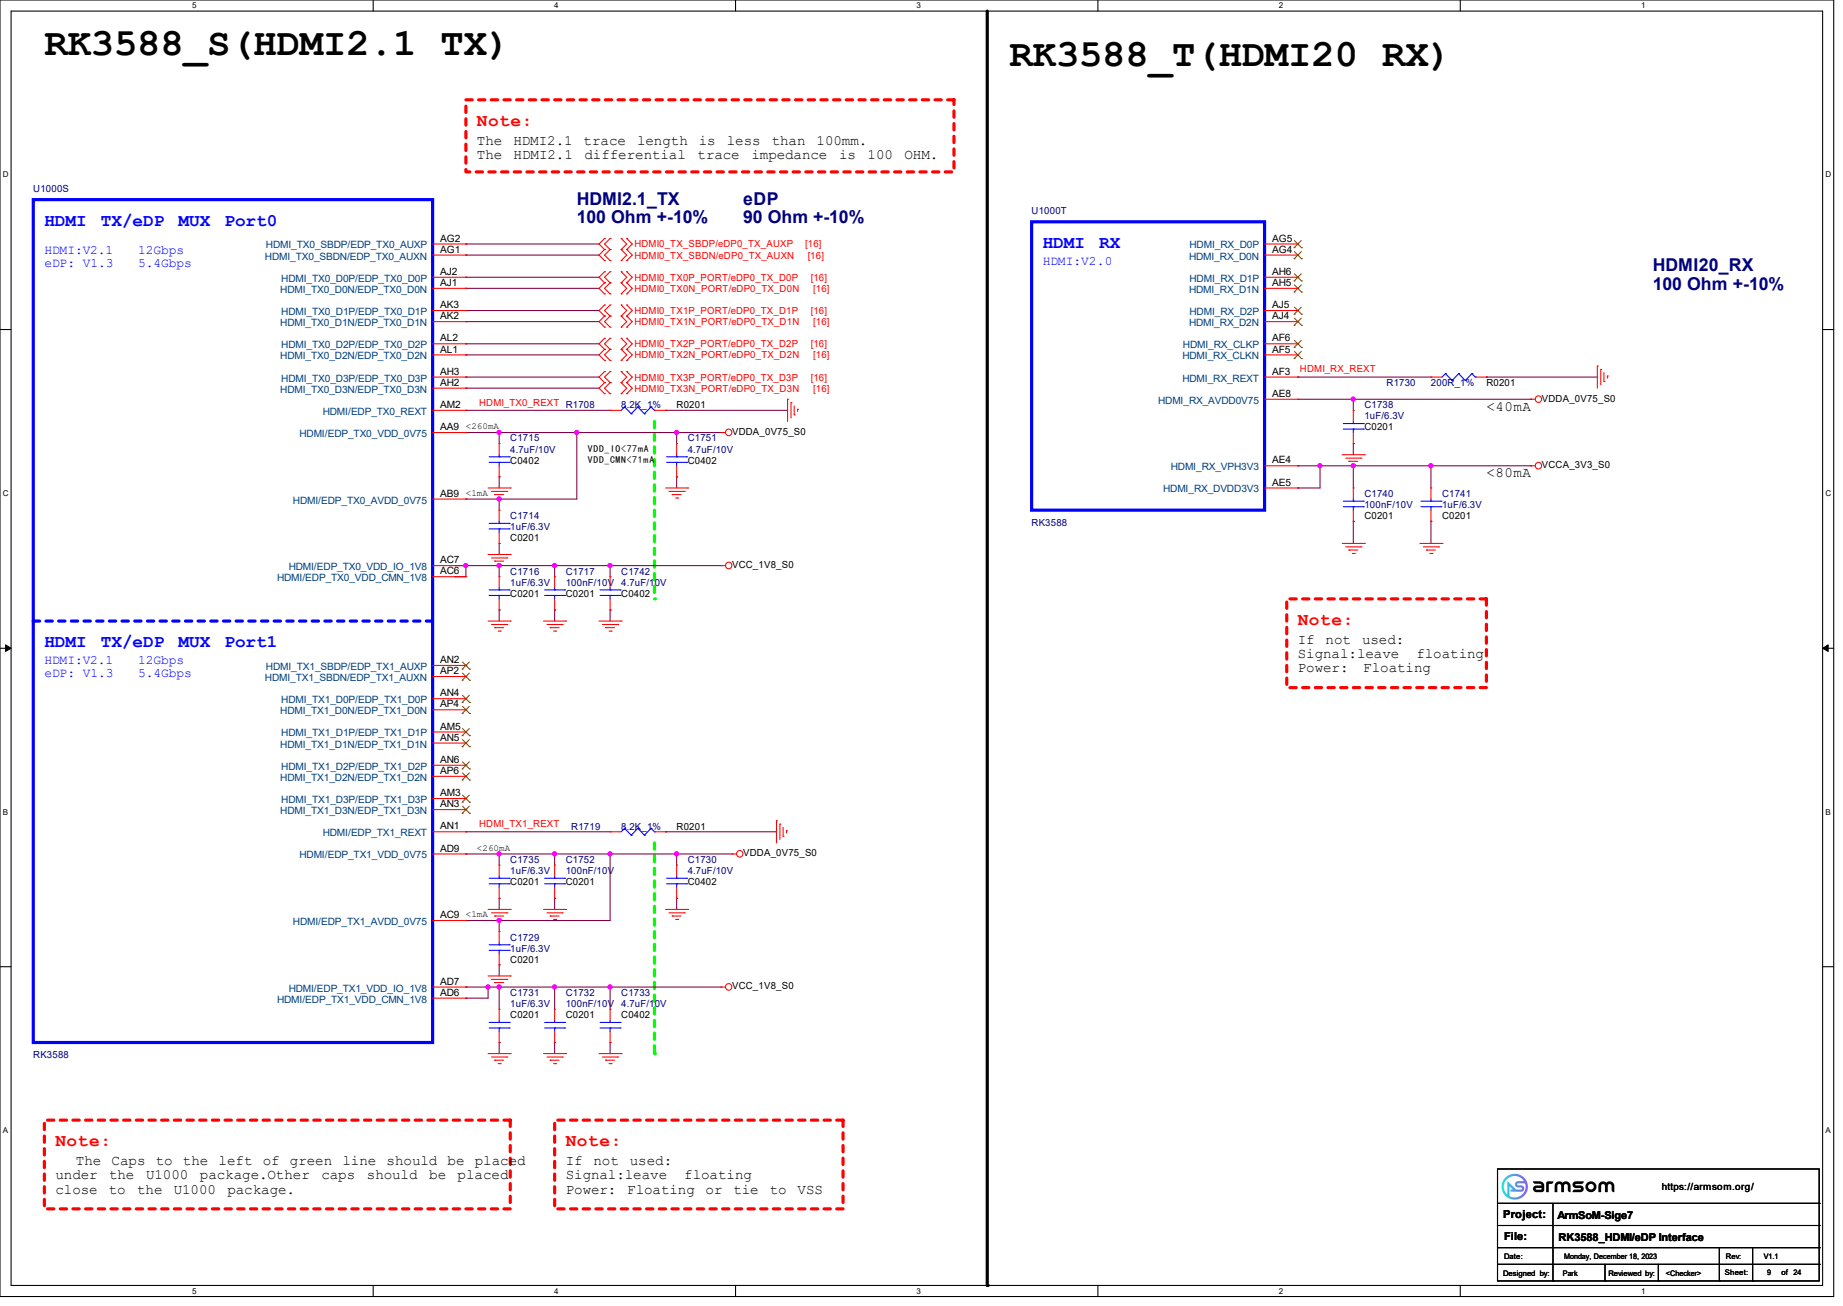
[picture p38: page 9]

Note:
The HDMI2.1 trace length is less than 100mm.
The HDMI2.1 differential trace impedance is 100 OHM.

HDMI TX/eDP MUX Port0

HDMI TX/eDP MUX Port1

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

If not used:
Signal:leave floating
Power: Floating or tie to VSS

https://armsom.org/ Monday, December 18, 2023 RK3588_HDMI/eDP Interface

# RK3588_N(PCIE20)

## CLK Differential Pair:

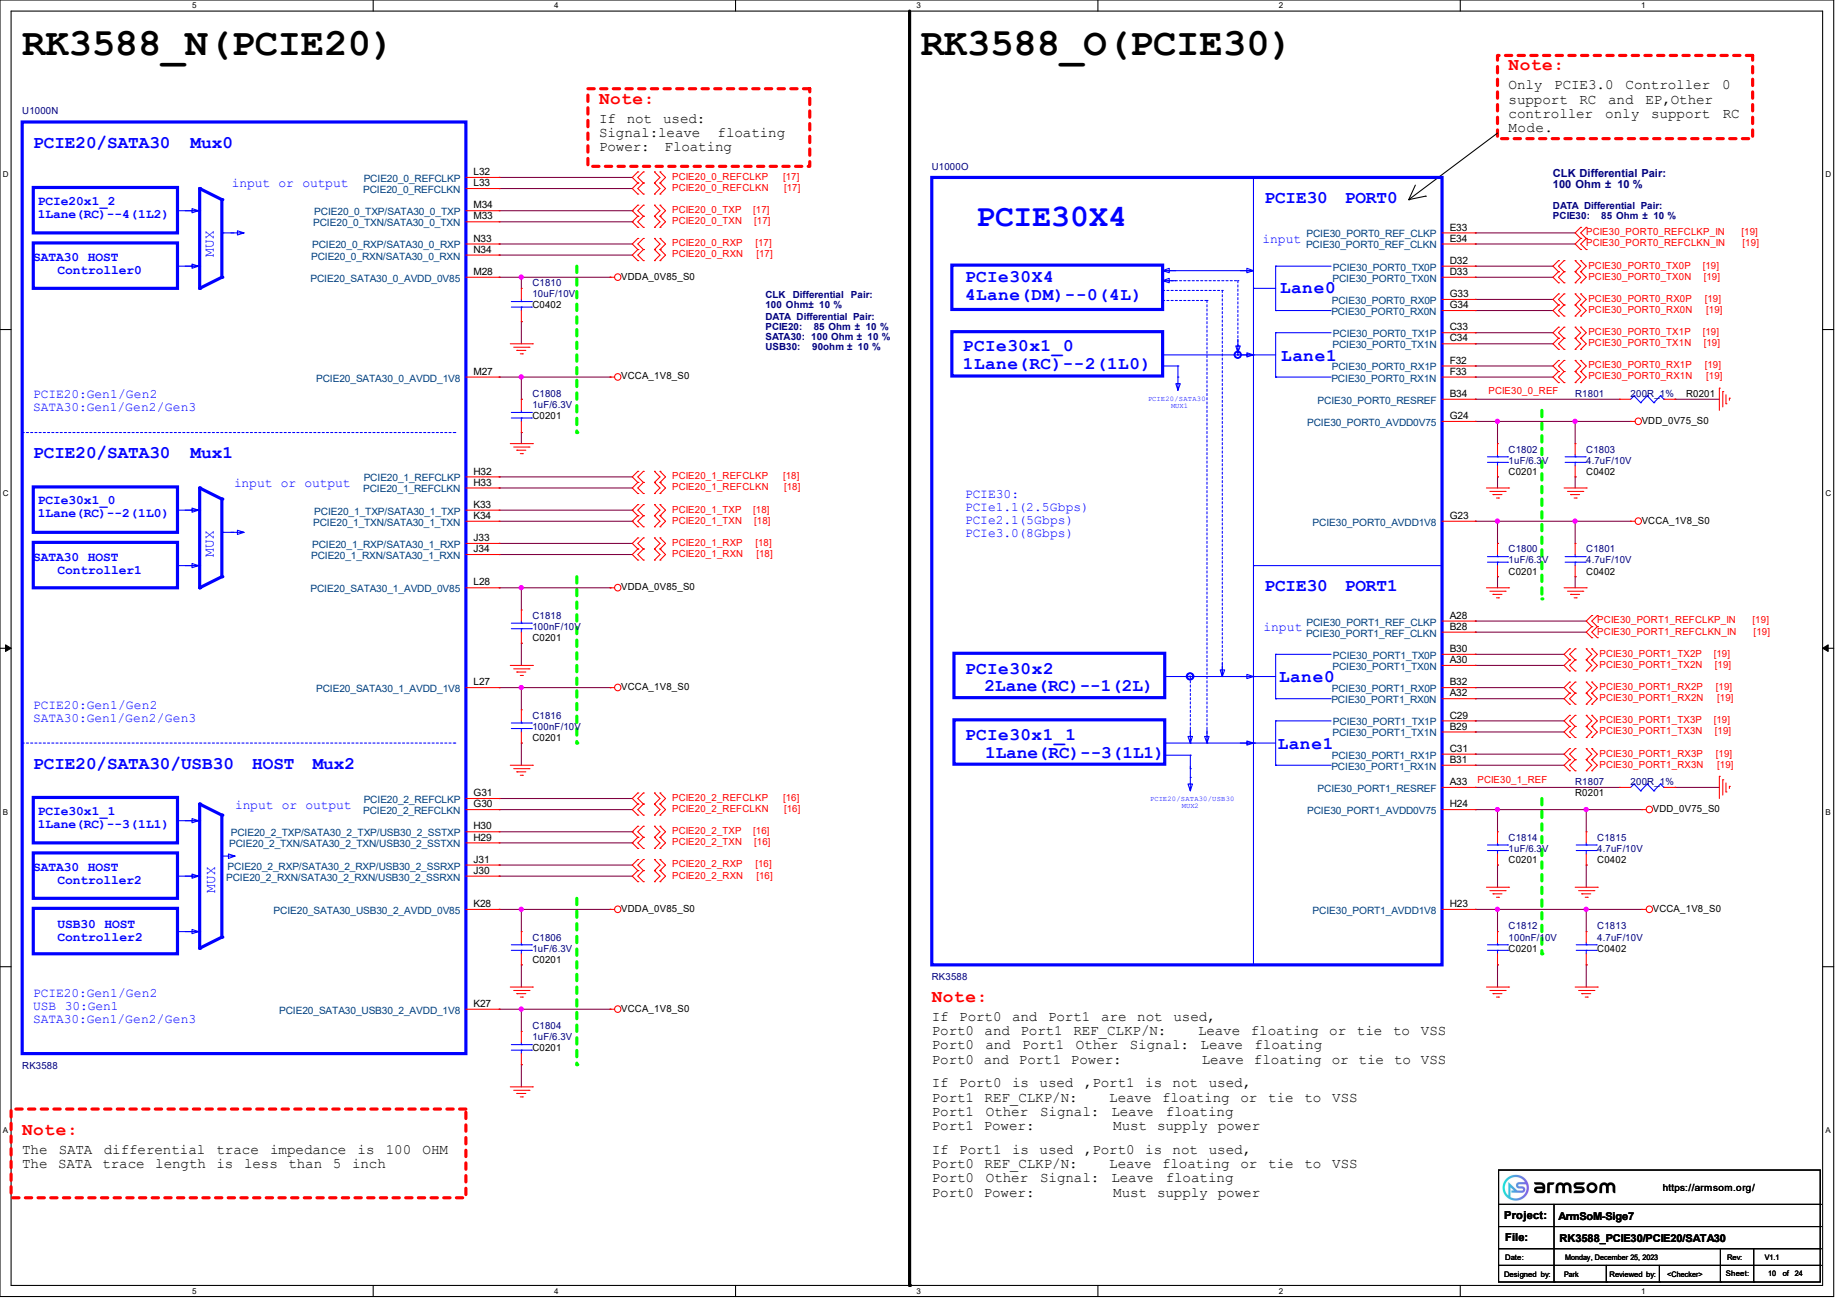
[picture p39: page 10]

Note:
Only PCIE3.0 Controller 0
support RC and EP,Other
controller only support RC
Mode.
PCIE30_PORT0_RESREF B34 PCIE30_PORT1_TX1P C29 PCIE30_PORT1_RX1P C31

If Port0 and Port1 are not used,
Port0 and Port1 Other Signal: Leave floating
If Port0 is used ,Port1 is not used,
Port1 Other Signal: Leave floating
If Port1 is used ,Port0 is not used,
Port0 Other Signal: Leave floating

The SATA differential trace impedance is 100 OHM
The SATA trace length is less than 5 inch

https://armsom.org/ Monday, December 25, 2023 RK3588_PCIE30/PCIE20/SATA30

RK3588_J(VCCIO5 Domain) | RK3588_K(VCCIO6 Domain)

# BT_REG_ON_H_3V3 [16] HOST_WAKE_BT_H_3V3 [16]

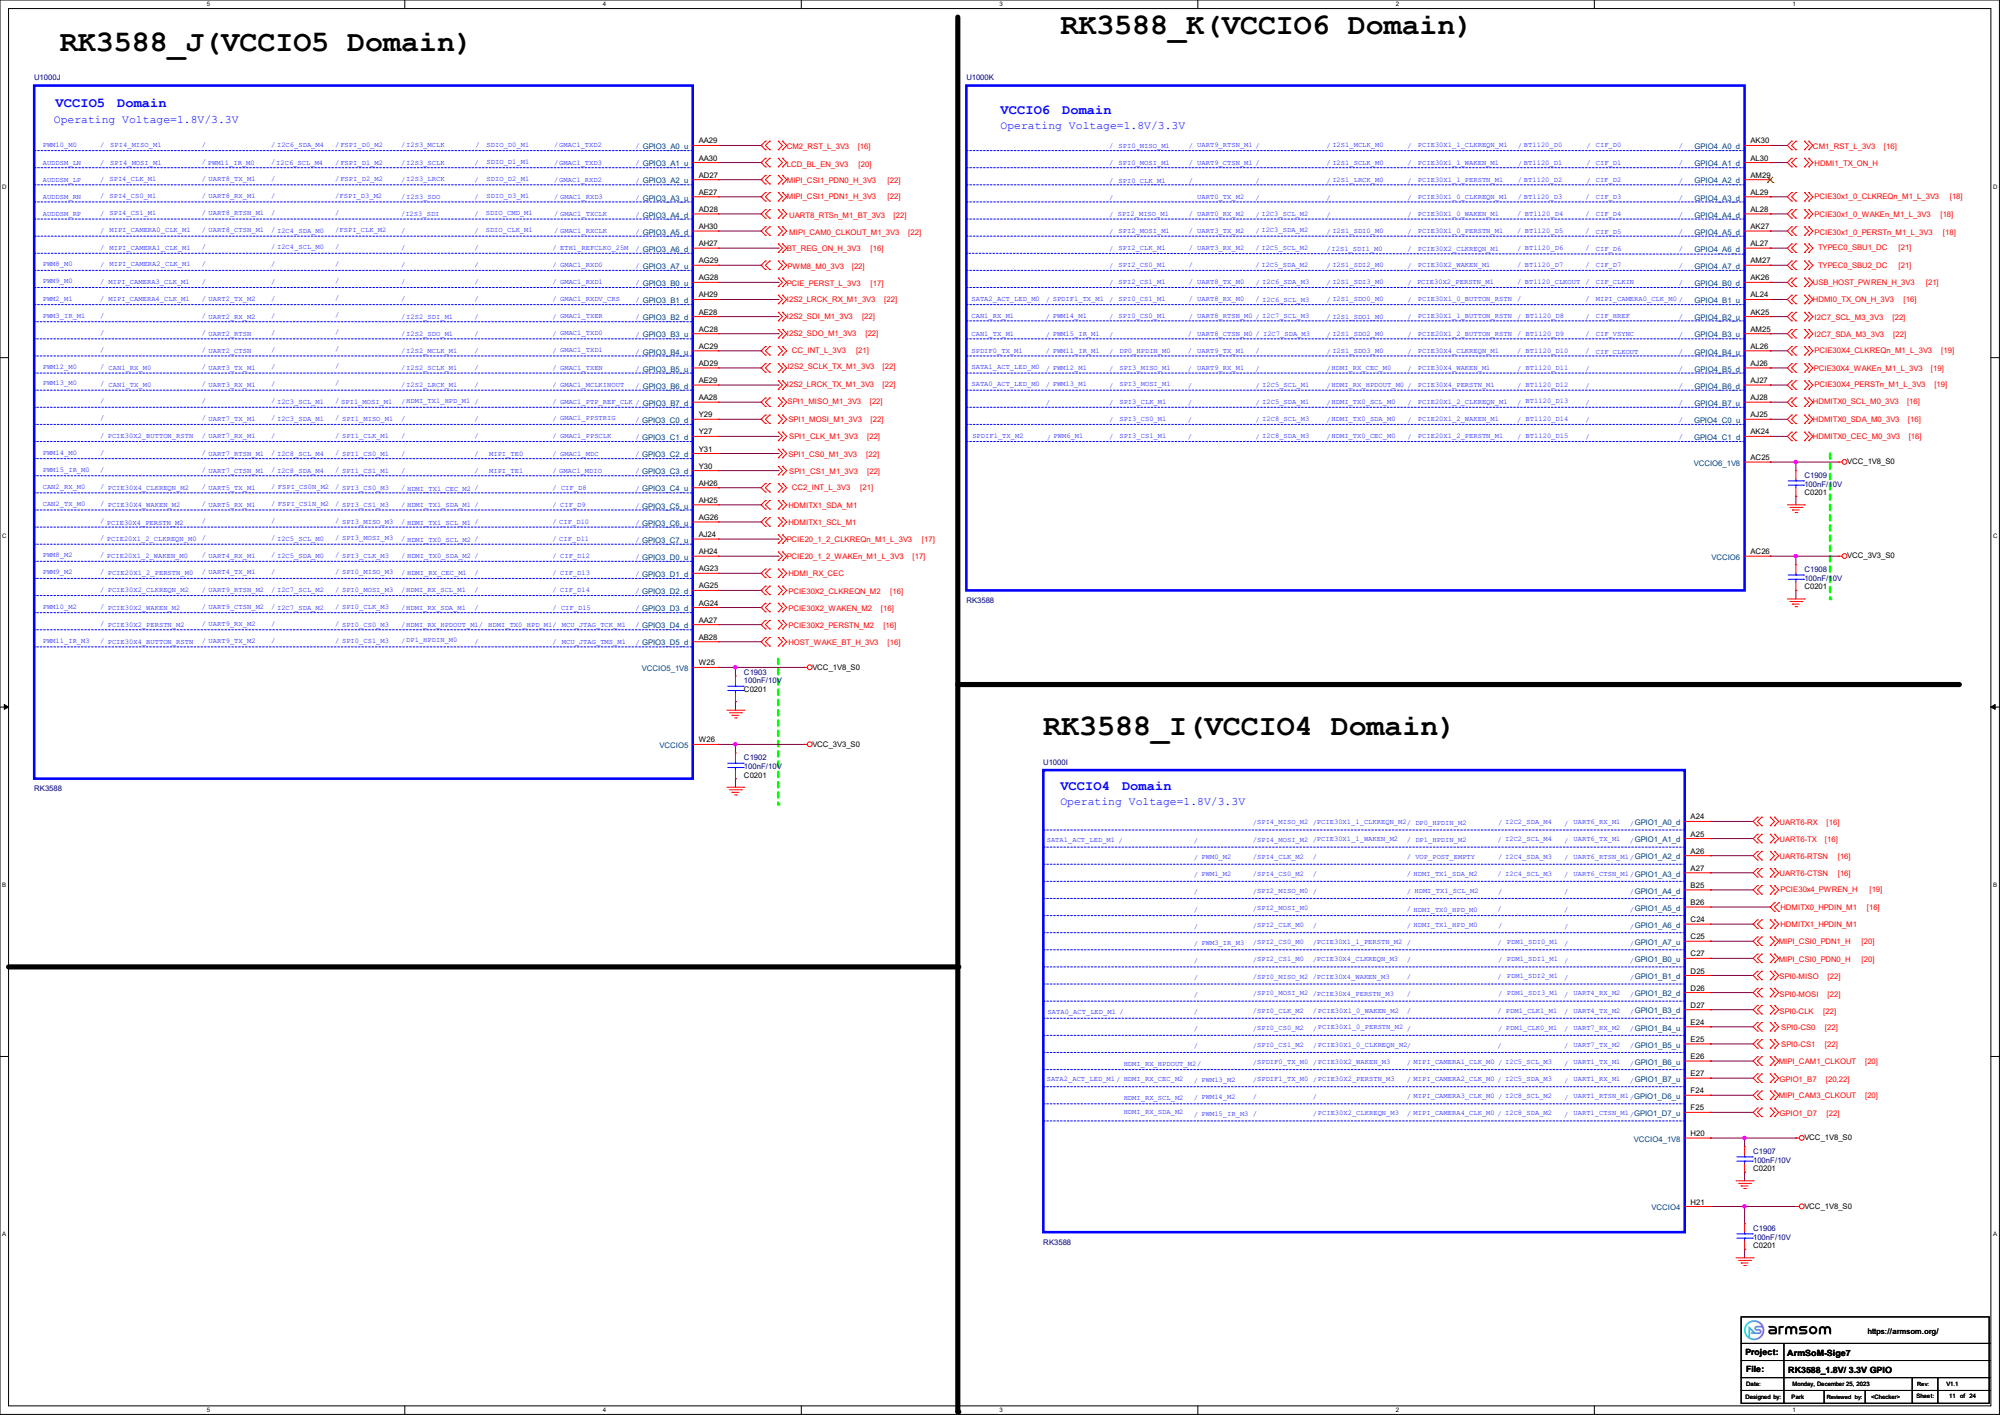
[picture p40: page 11]

UART6-RX [16] UART6-TX [16] UART6-CTSN [16] UART6-RTSN [16]

https://armsom.org/ Monday, December 25, 2023 RK3588_1.8V/ 3.3V GPIO

# PMIC RK806-1 BUCK

# Low frequency:0.85V-->0.75V ¹⁰⁰R RK3588

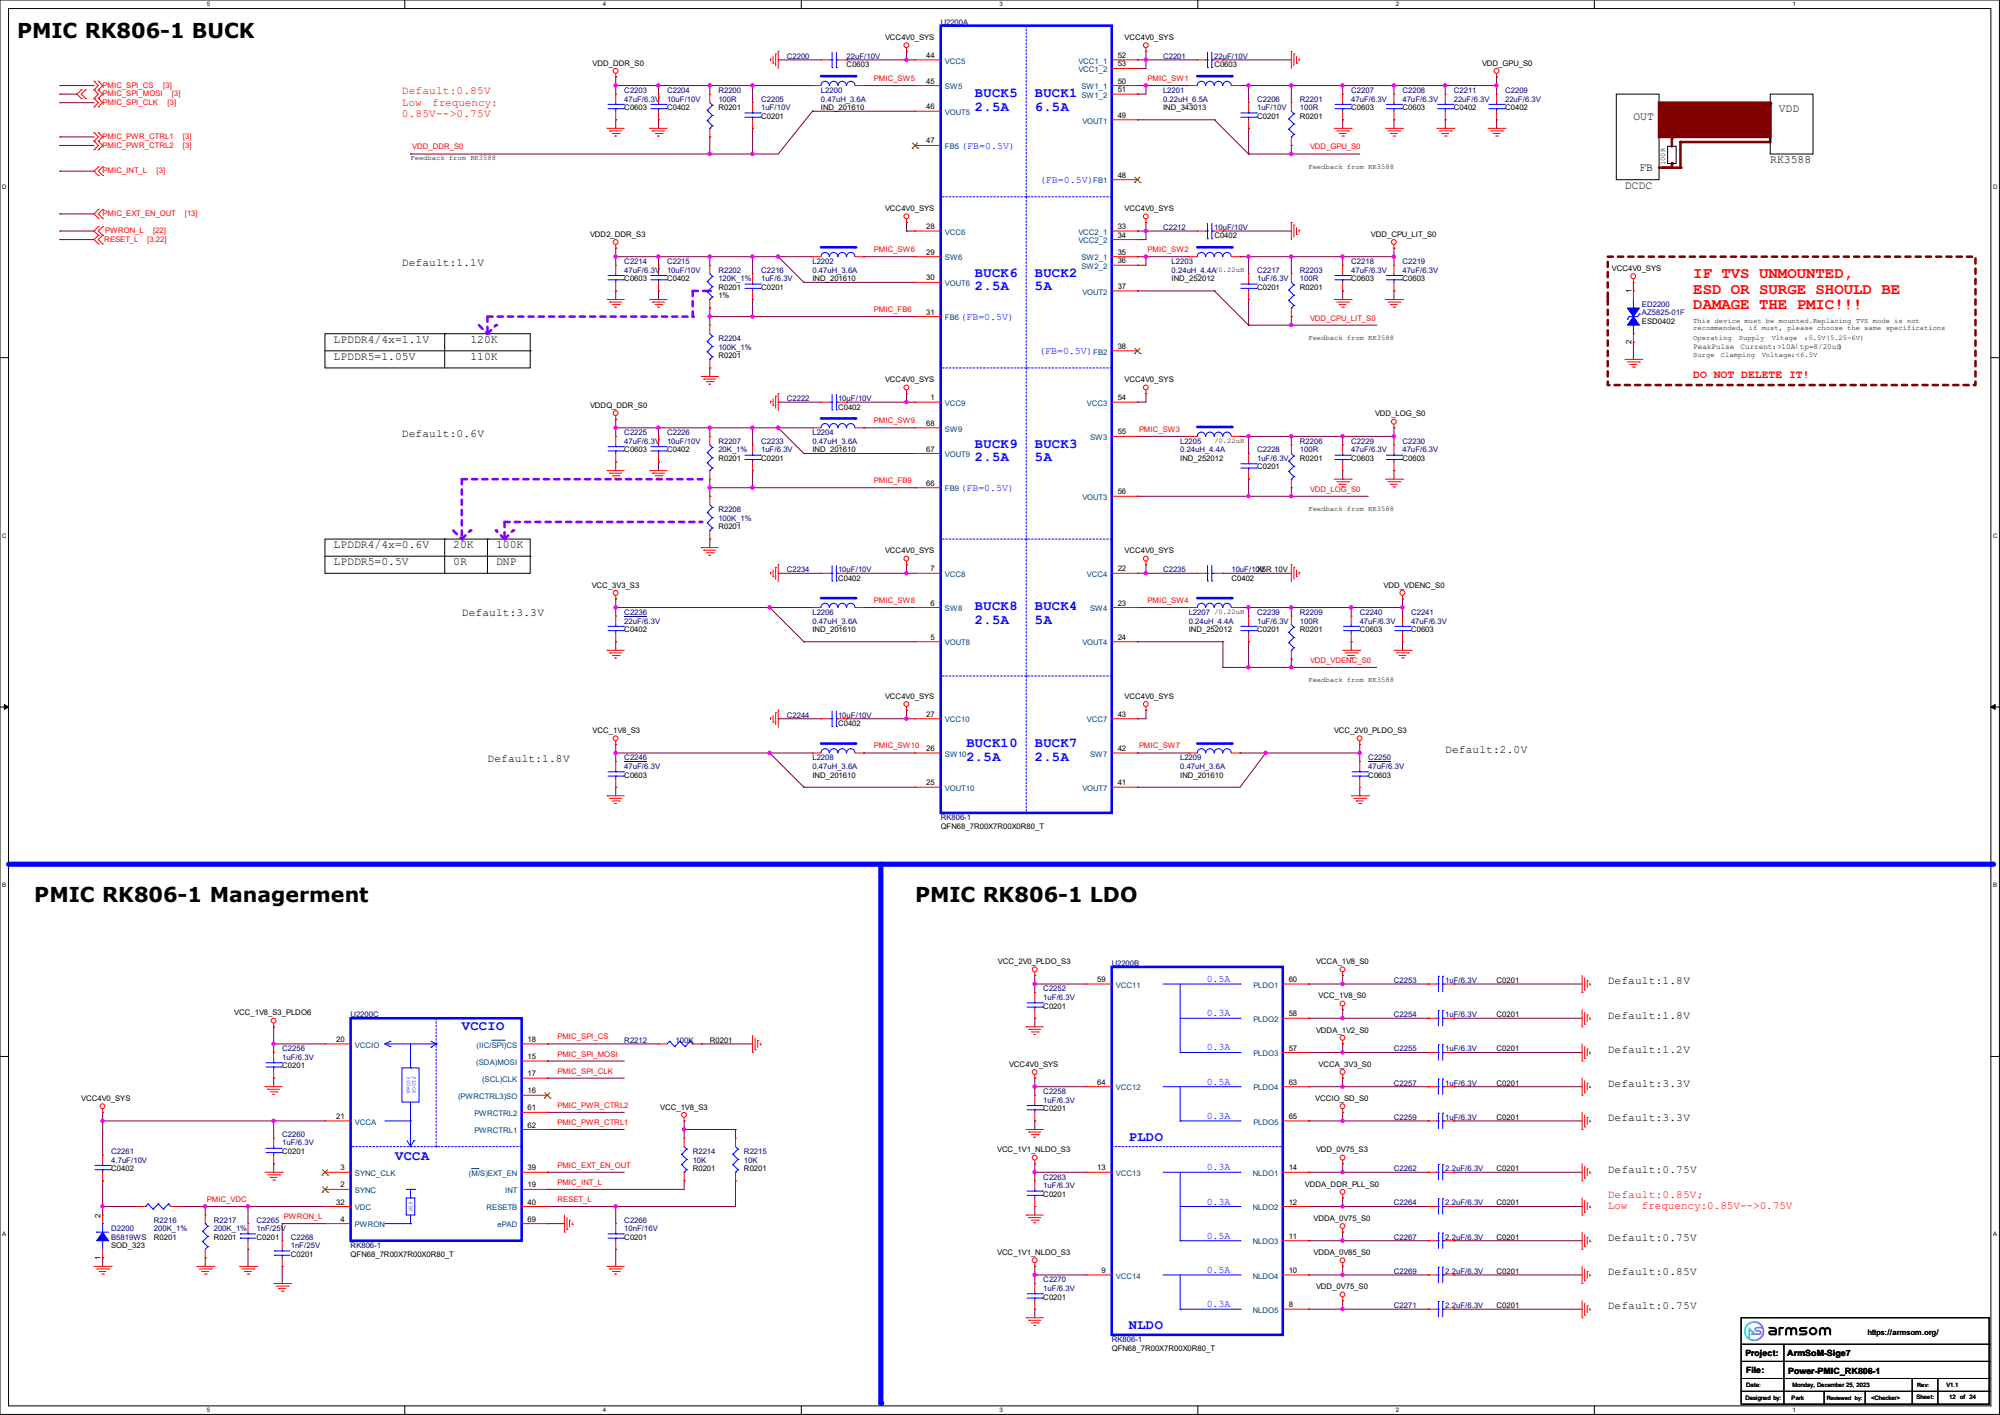
[picture p41: page 12]

IF TVS UNMOUNTED,
ESD OR SURGE SHOULD BE
DAMAGE THE PMIC!!!

This device must be mounted.Replacing TVS mode is not
recommended, if must, please choose the same specifications
Operating Supply Vltage ：5.5V(5.25-6V)
PeakPulse Current：>10A（tp=8/20uS)
Surge Clamping Voltage：<6.5V
DO NOT DELETE IT!

# Feedback from RK3588

VDD_CPU_BIG1 100R | RK3588

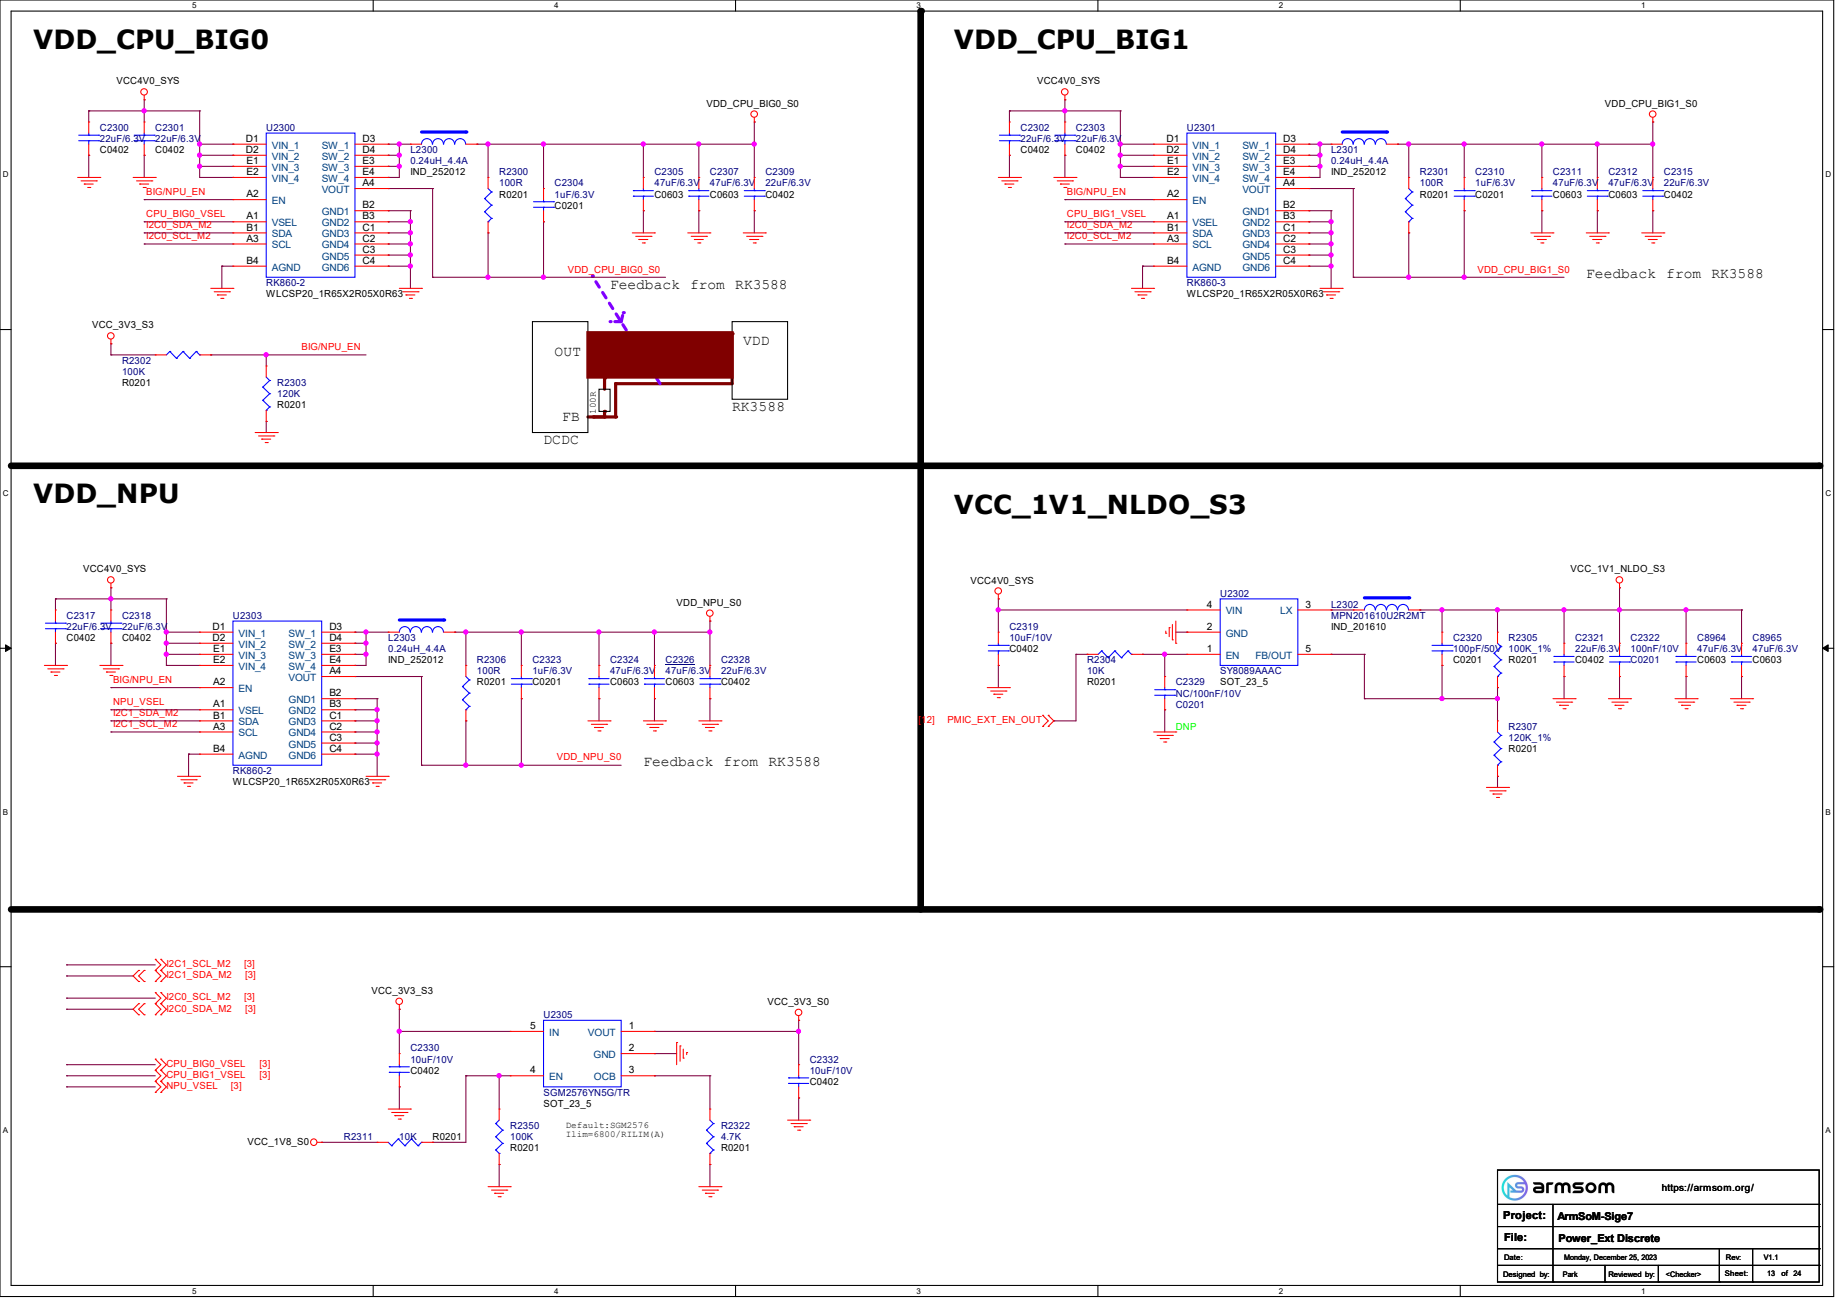
[picture p42: page 13]

SOT_23_5 OCB 3 GND 2 VOUT 1 EN 4

https://armsom.org/ Monday, December 25, 2023 Power_Ext Discrete

# LPDDR4/4X

DDR_CH0_DQ0_B | [4] DDR_CH0_DQ1_B | [4] DDR_CH0_DQ2_B | [4] DDR_CH0_DQ3_B | [4] DDR_CH0_DQ4_B | [4] DDR_CH0_DQ5_B | [4] DDR_CH0_DQ6_B | [4] DDR_CH0_DQ7_B | [4] DDR_CH0_DQ8_B | [4] DDR_CH0_DQ9_B | [4] DDR_CH0_DQ10_B | [4] DDR_CH0_DQ11_B | [4] DDR_CH0_DQ12_B | [4] DDR_CH0_DQ13_B | [4] DDR_CH0_DQ14_B | [4] DDR_CH0_DQ15_B | [4] DDR_CH0_DQS0P_B | [4] DDR_CH0_DQS0N_B | [4] DDR_CH0_DQS1P_B | [4] DDR_CH0_DQS1N_B | [4]

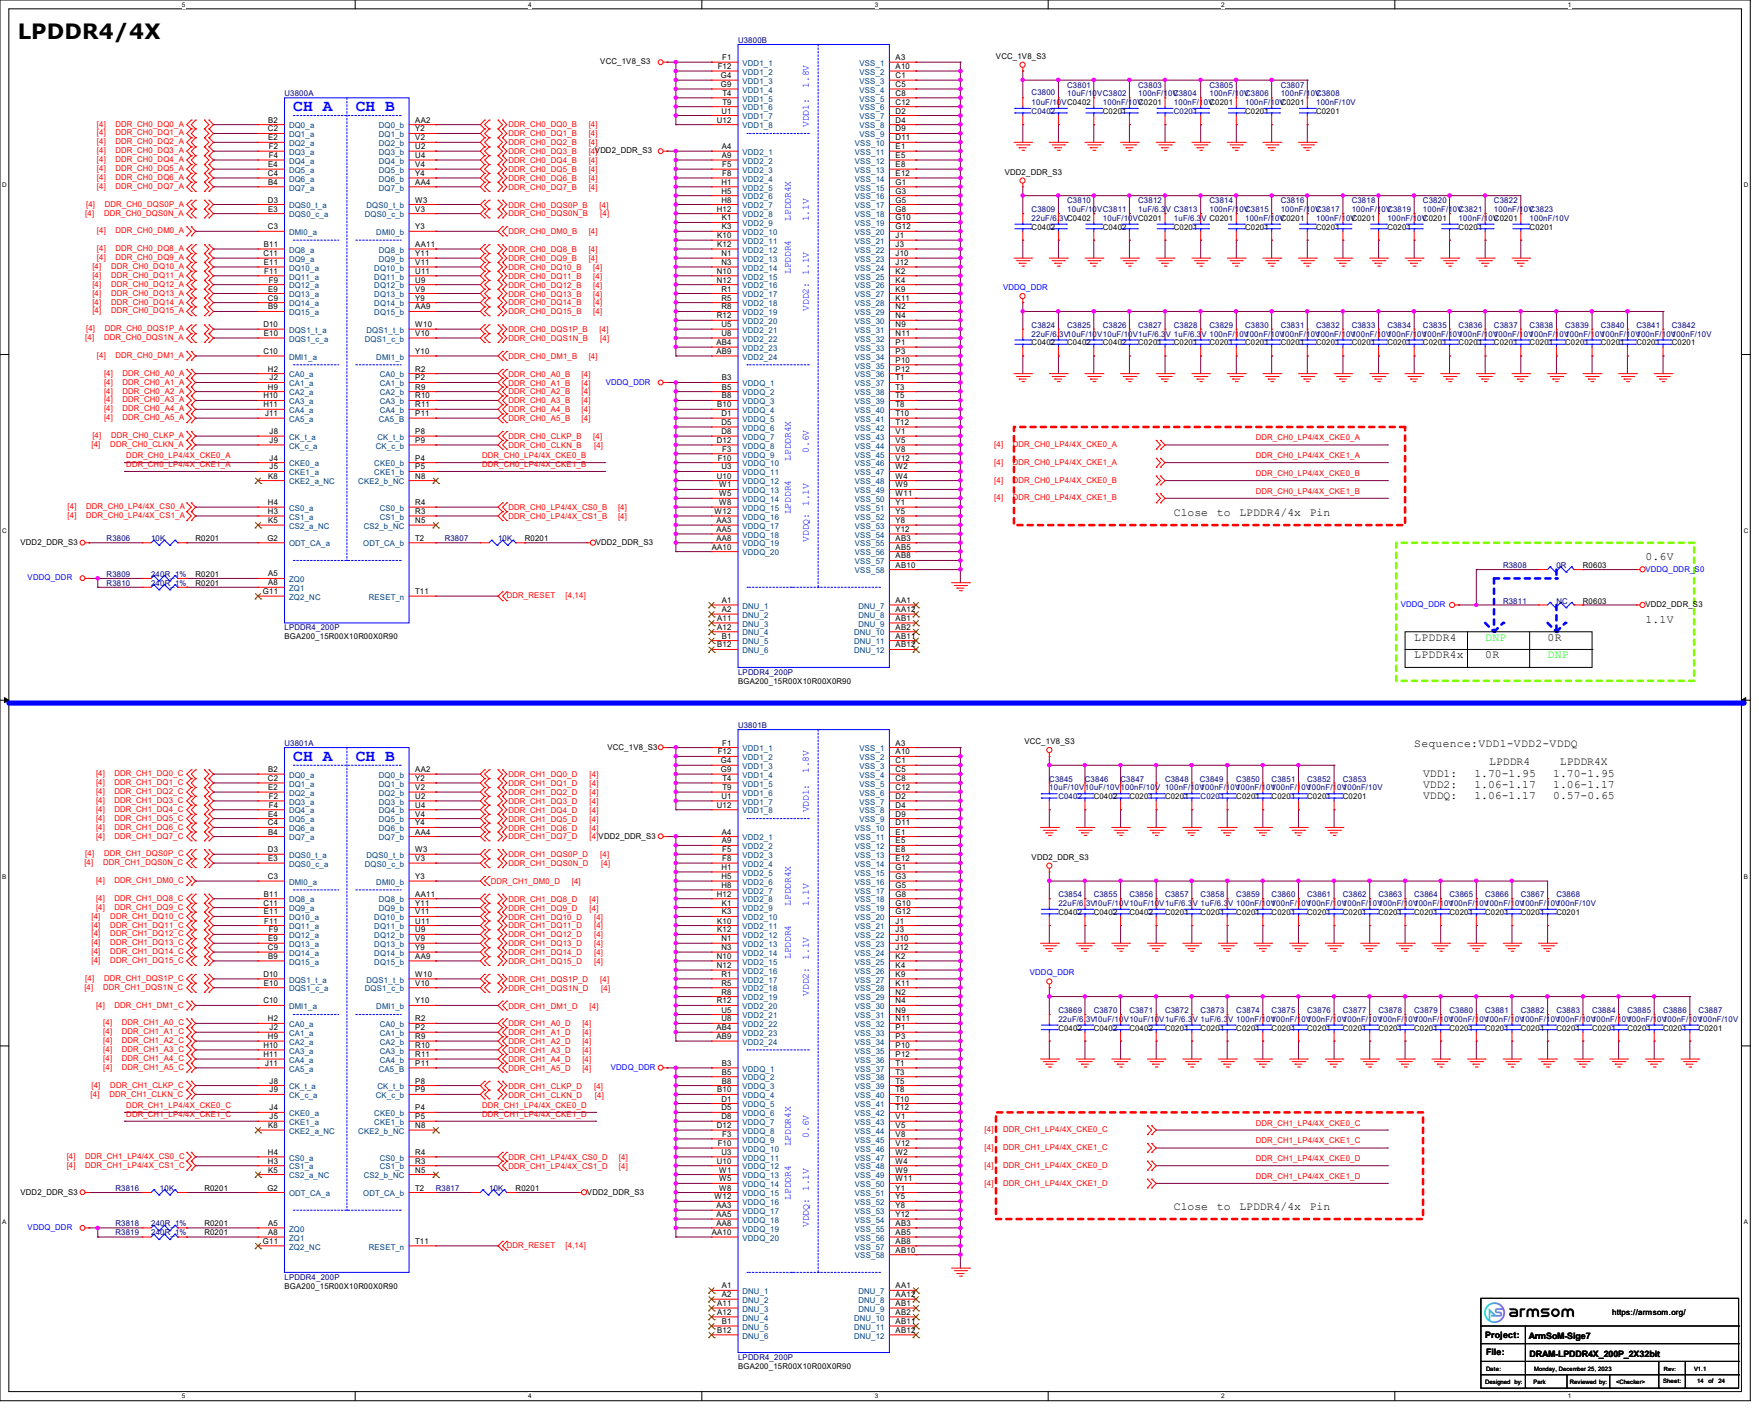
[picture p43: page 14]

D D

# eMMC

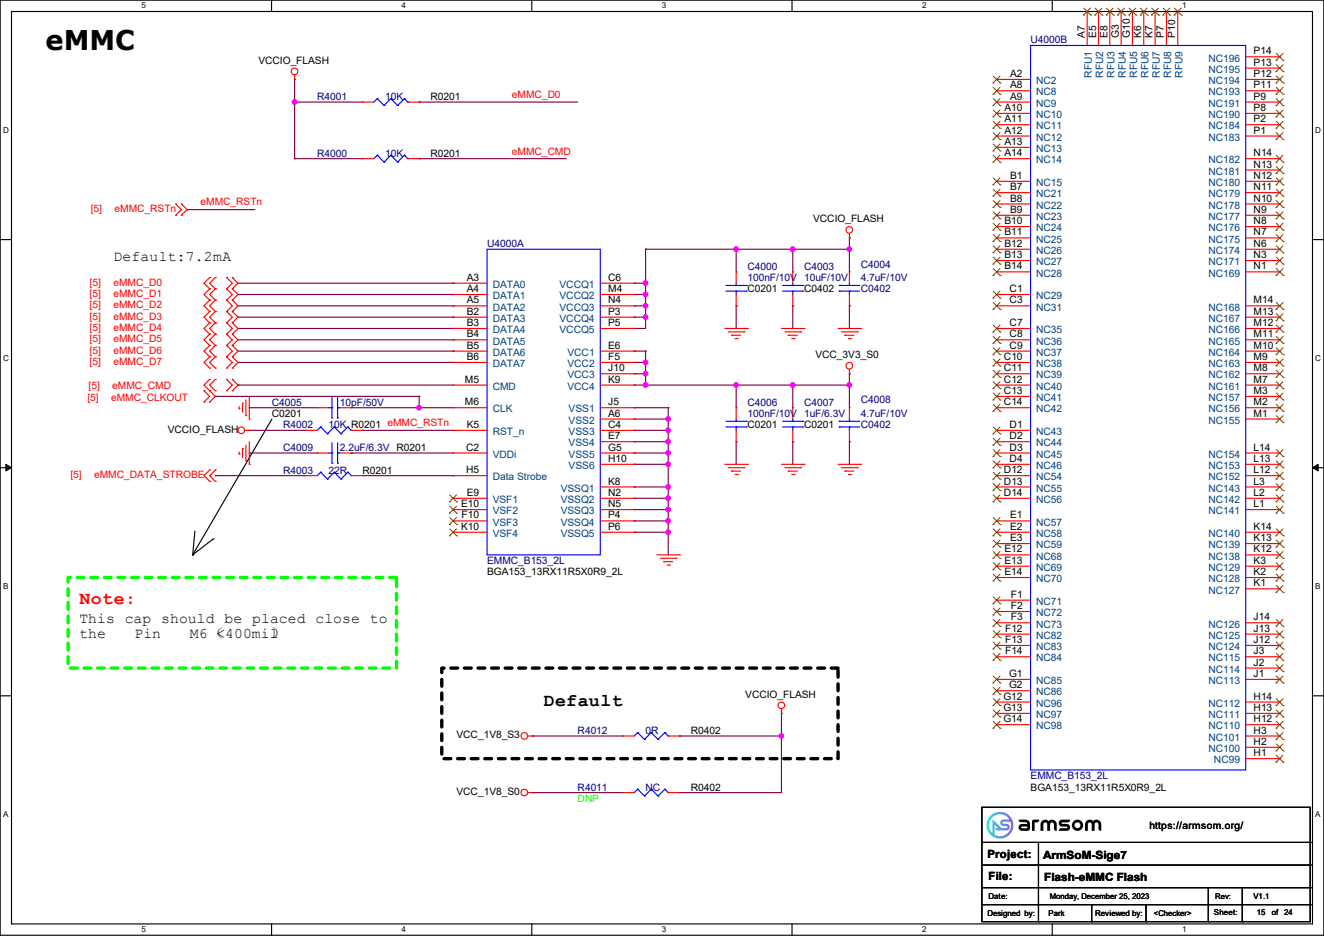
[picture p44: page 15]

NC127 K1 NC128 K2 NC129 K3 RFU⁶ K⁶ RFU⁷ K⁷

Note:
This cap should be placed close to

HDMI TX0 | HDMI TX DDC

# HDMI TX eARC

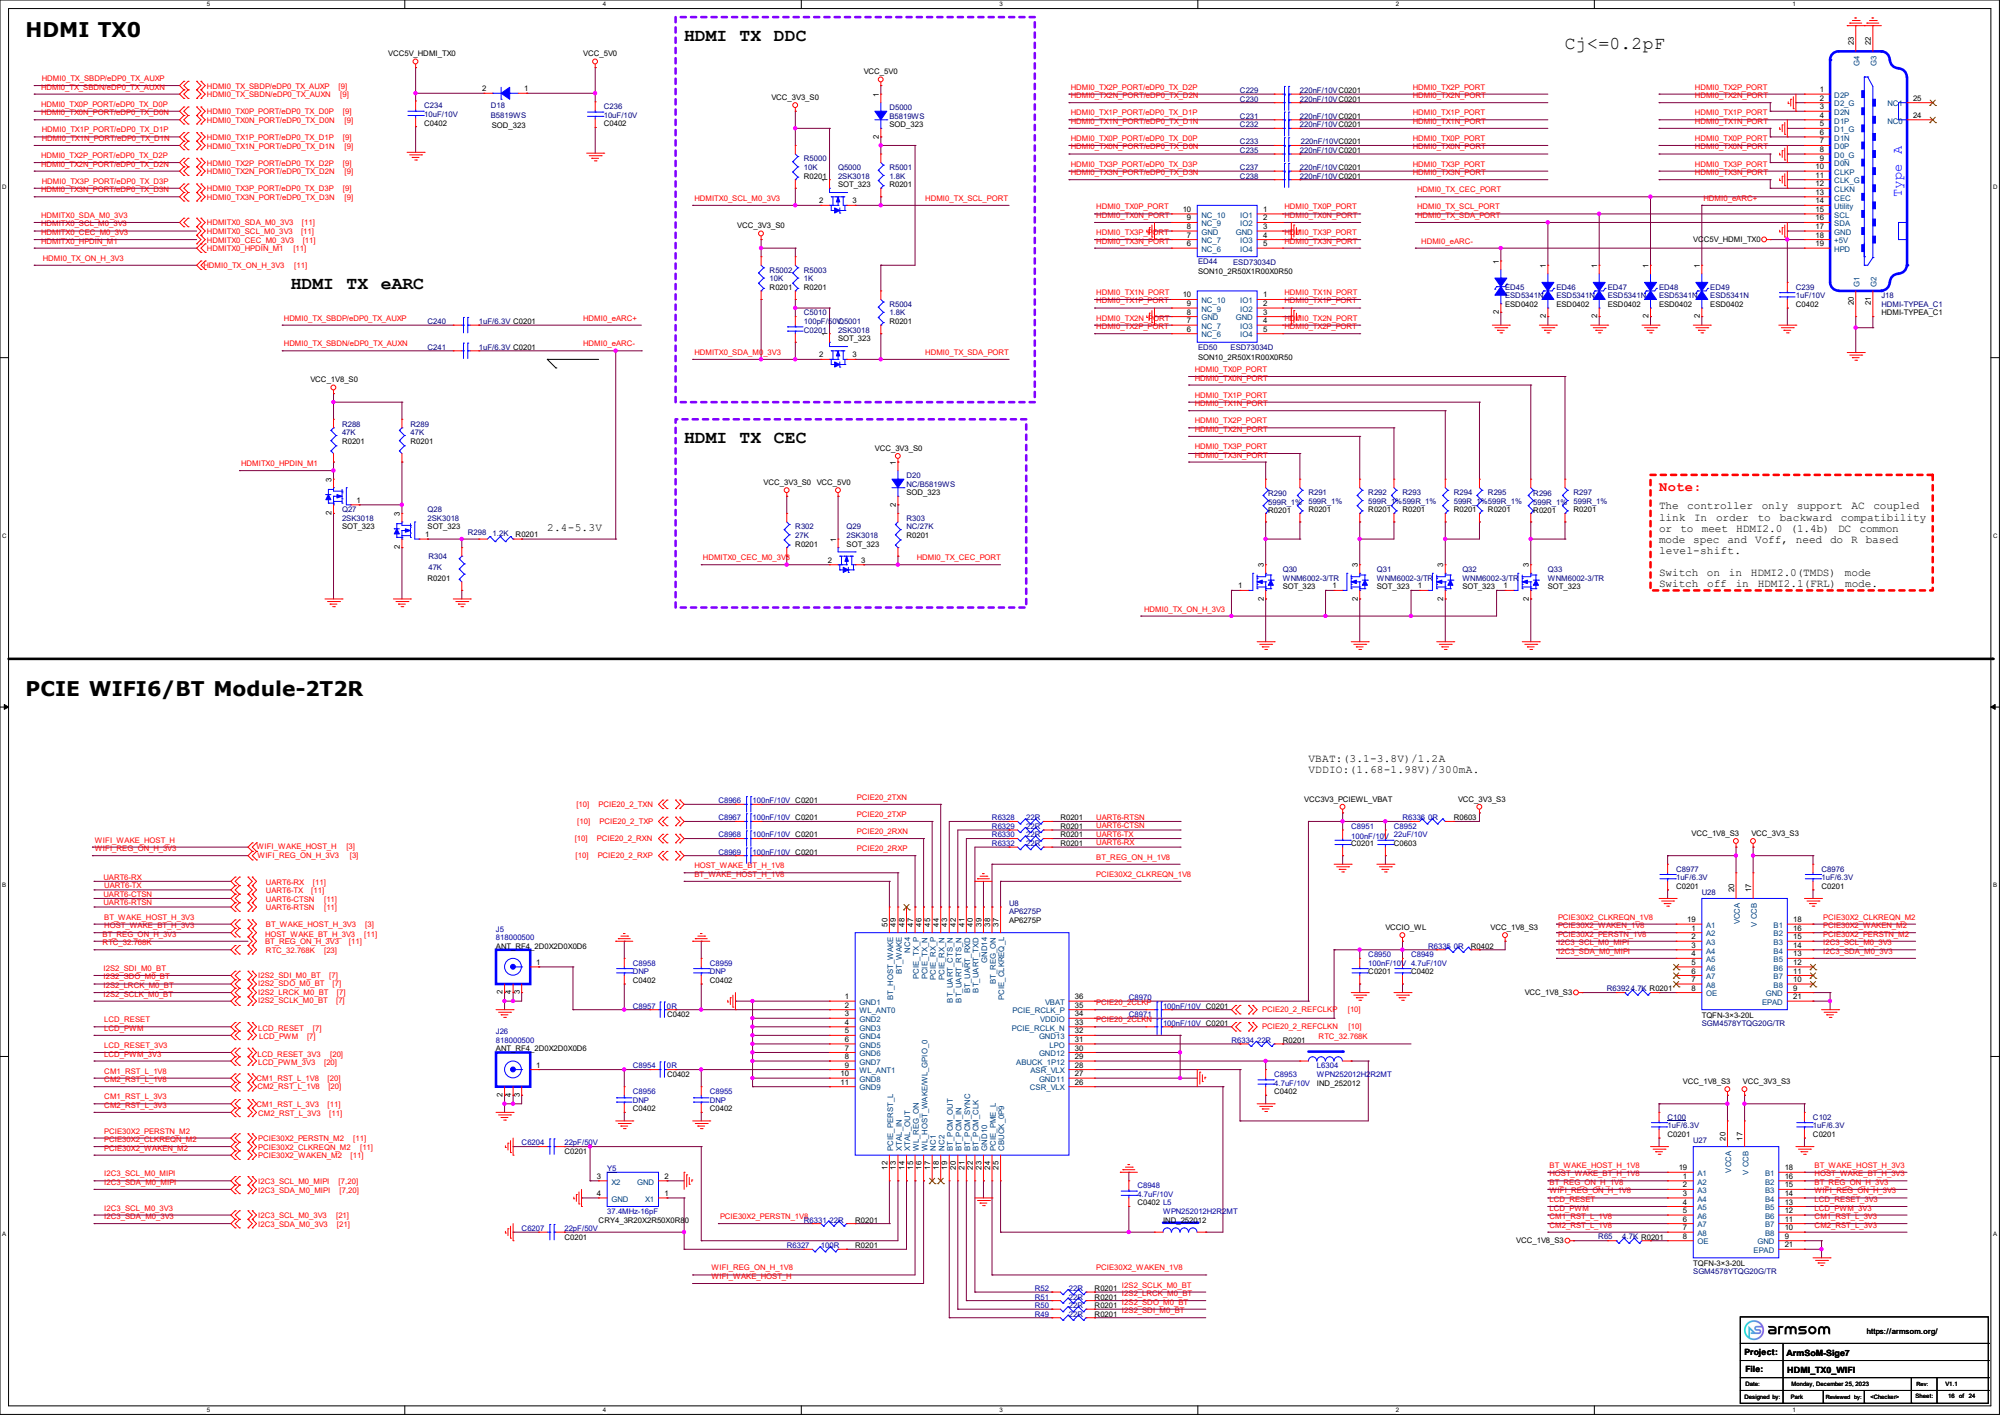
[picture p45: page 16]

Note:
The controller only support AC coupled
link In order to backward compatibility
or to meet HDMI2.0 (1.4b) DC common
mode spec and Voff, need do R based
level-shift.

Switch on in HDMI2.0(TMDS) mode
Switch off in HDMI2.1(FRL) mode.

29 GND¹⁰ 23 PCIE_RX_P ⁴⁵ PCIE_TX_N ⁴⁶ PCIE_TX_P ⁴⁷ NC⁴ ⁴⁸ BT_WAKE ⁴⁹ BT_HOST_WAKE ⁵⁰

# PCIE TO RJ45

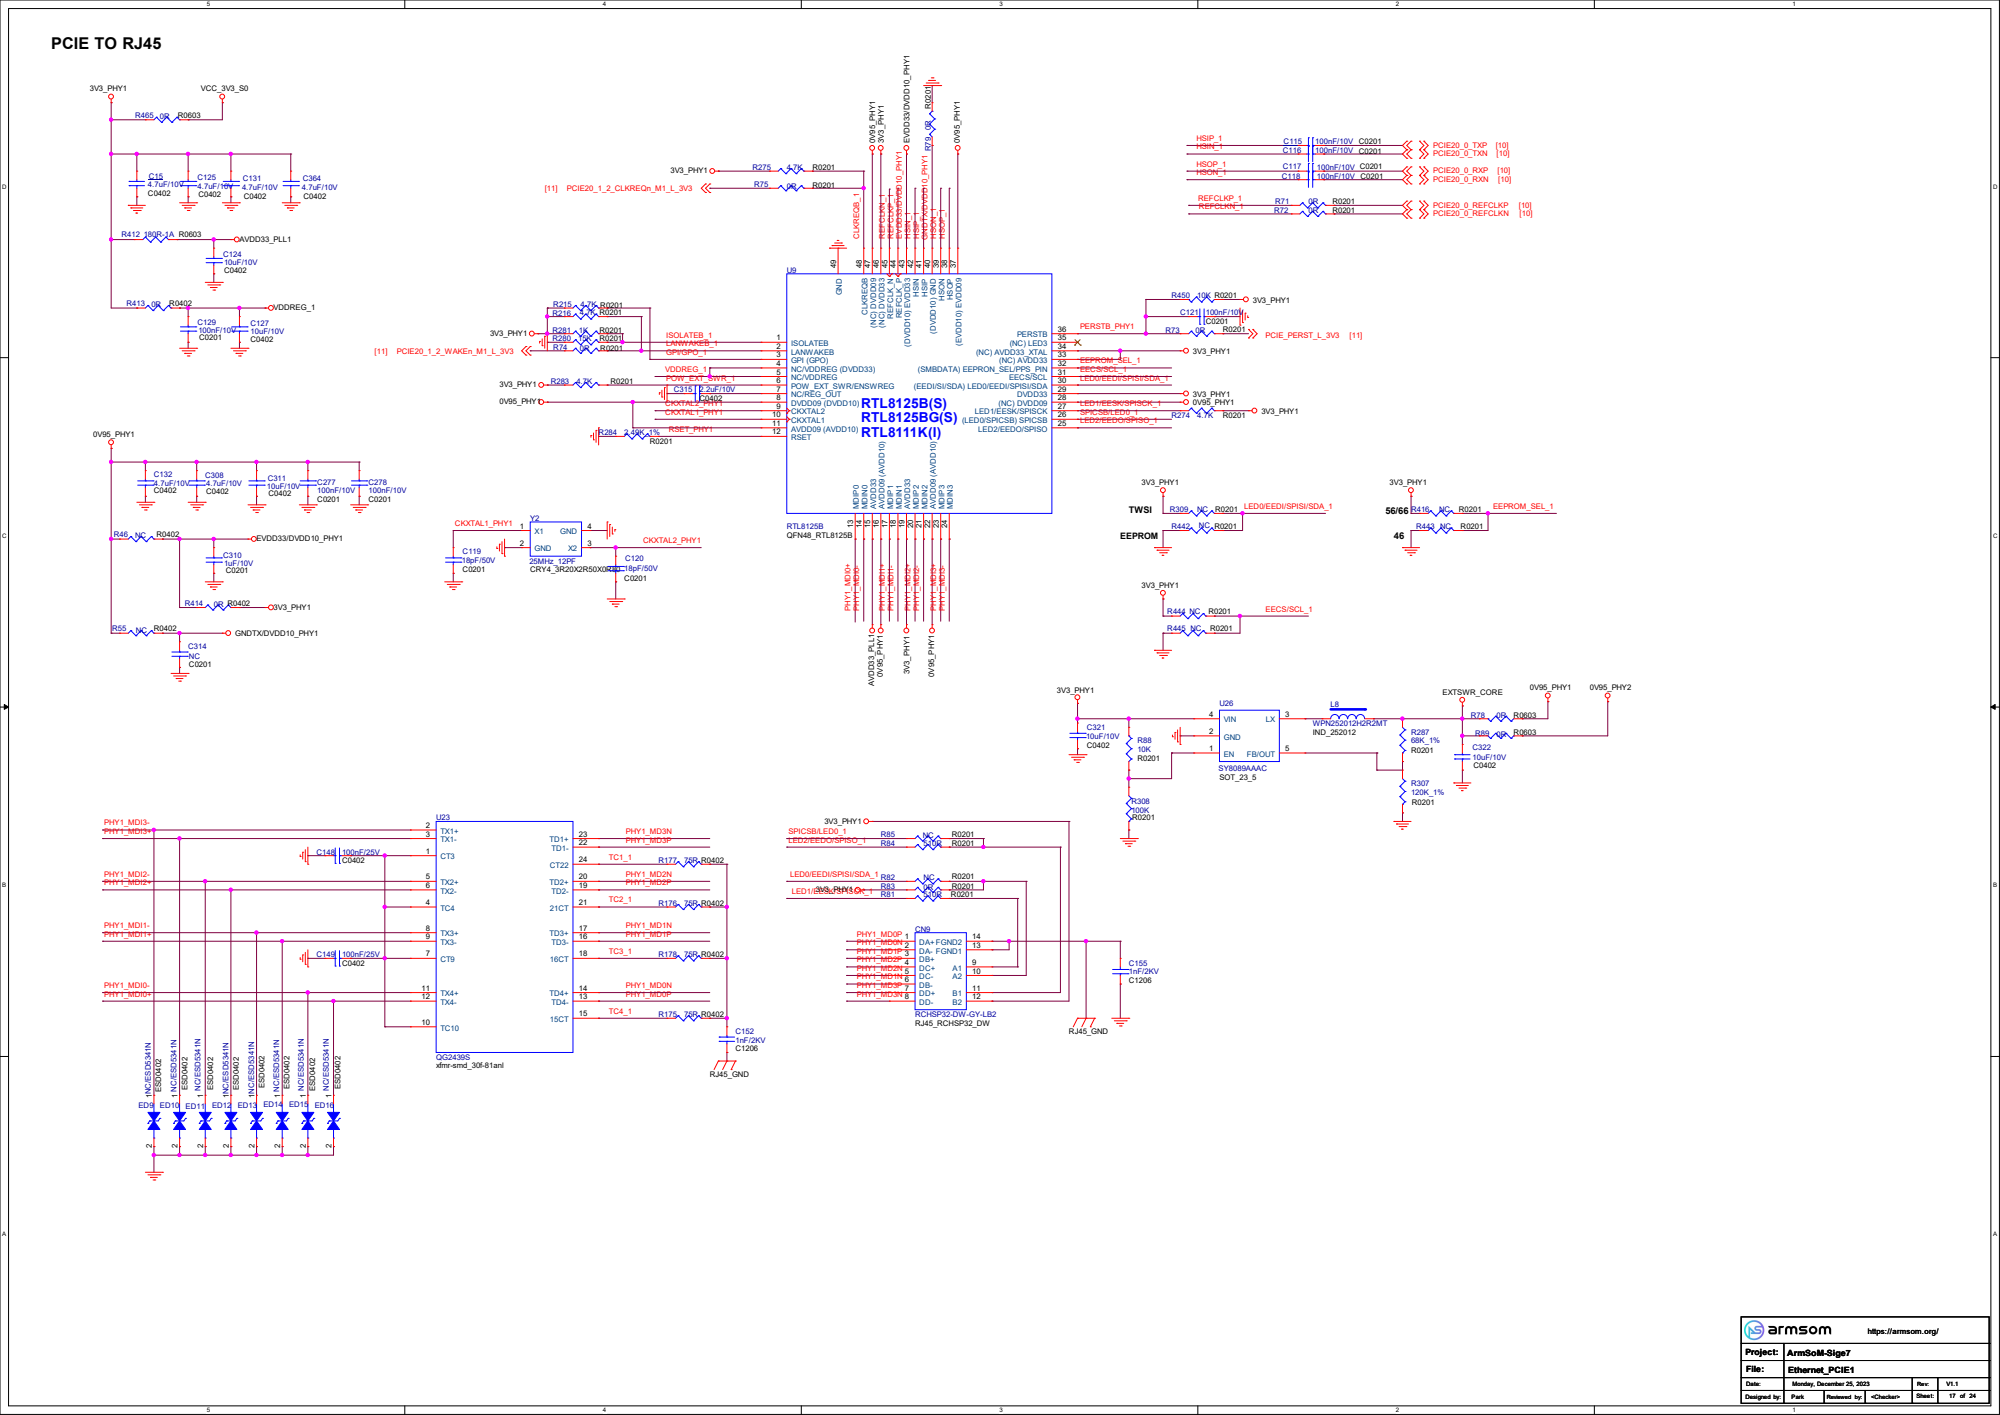
[picture p46: page 17]

2 48 CLKREQB (NC⁾ DVDD⁰⁹ ⁴⁷ GPI (GPO) 3 NC/VDDREG (DVDD33) 4 NC/VDDREG
RTL8111K(I) U9QFN48_RTL8125B RTL8125B

25 ⁽NC⁾ DVDD³³ ⁴⁶ REFCLK_N ⁴⁵⁴⁴ REFCLK_P (DVDD¹⁰⁾ EVDD³³ ⁴³ HSIN ⁴²⁴¹ HSIP (DVDD¹⁰⁾ GND ⁴⁰ HSON ³⁹³⁸ HSOP (EVDD¹⁰⁾ EVDD⁰⁹ ³⁷ GND ⁴⁹

ED13 ESD⁰⁴⁰² NC/ESD⁵³⁴¹N 1 2 C314 NC

# PCIE TO RJ45

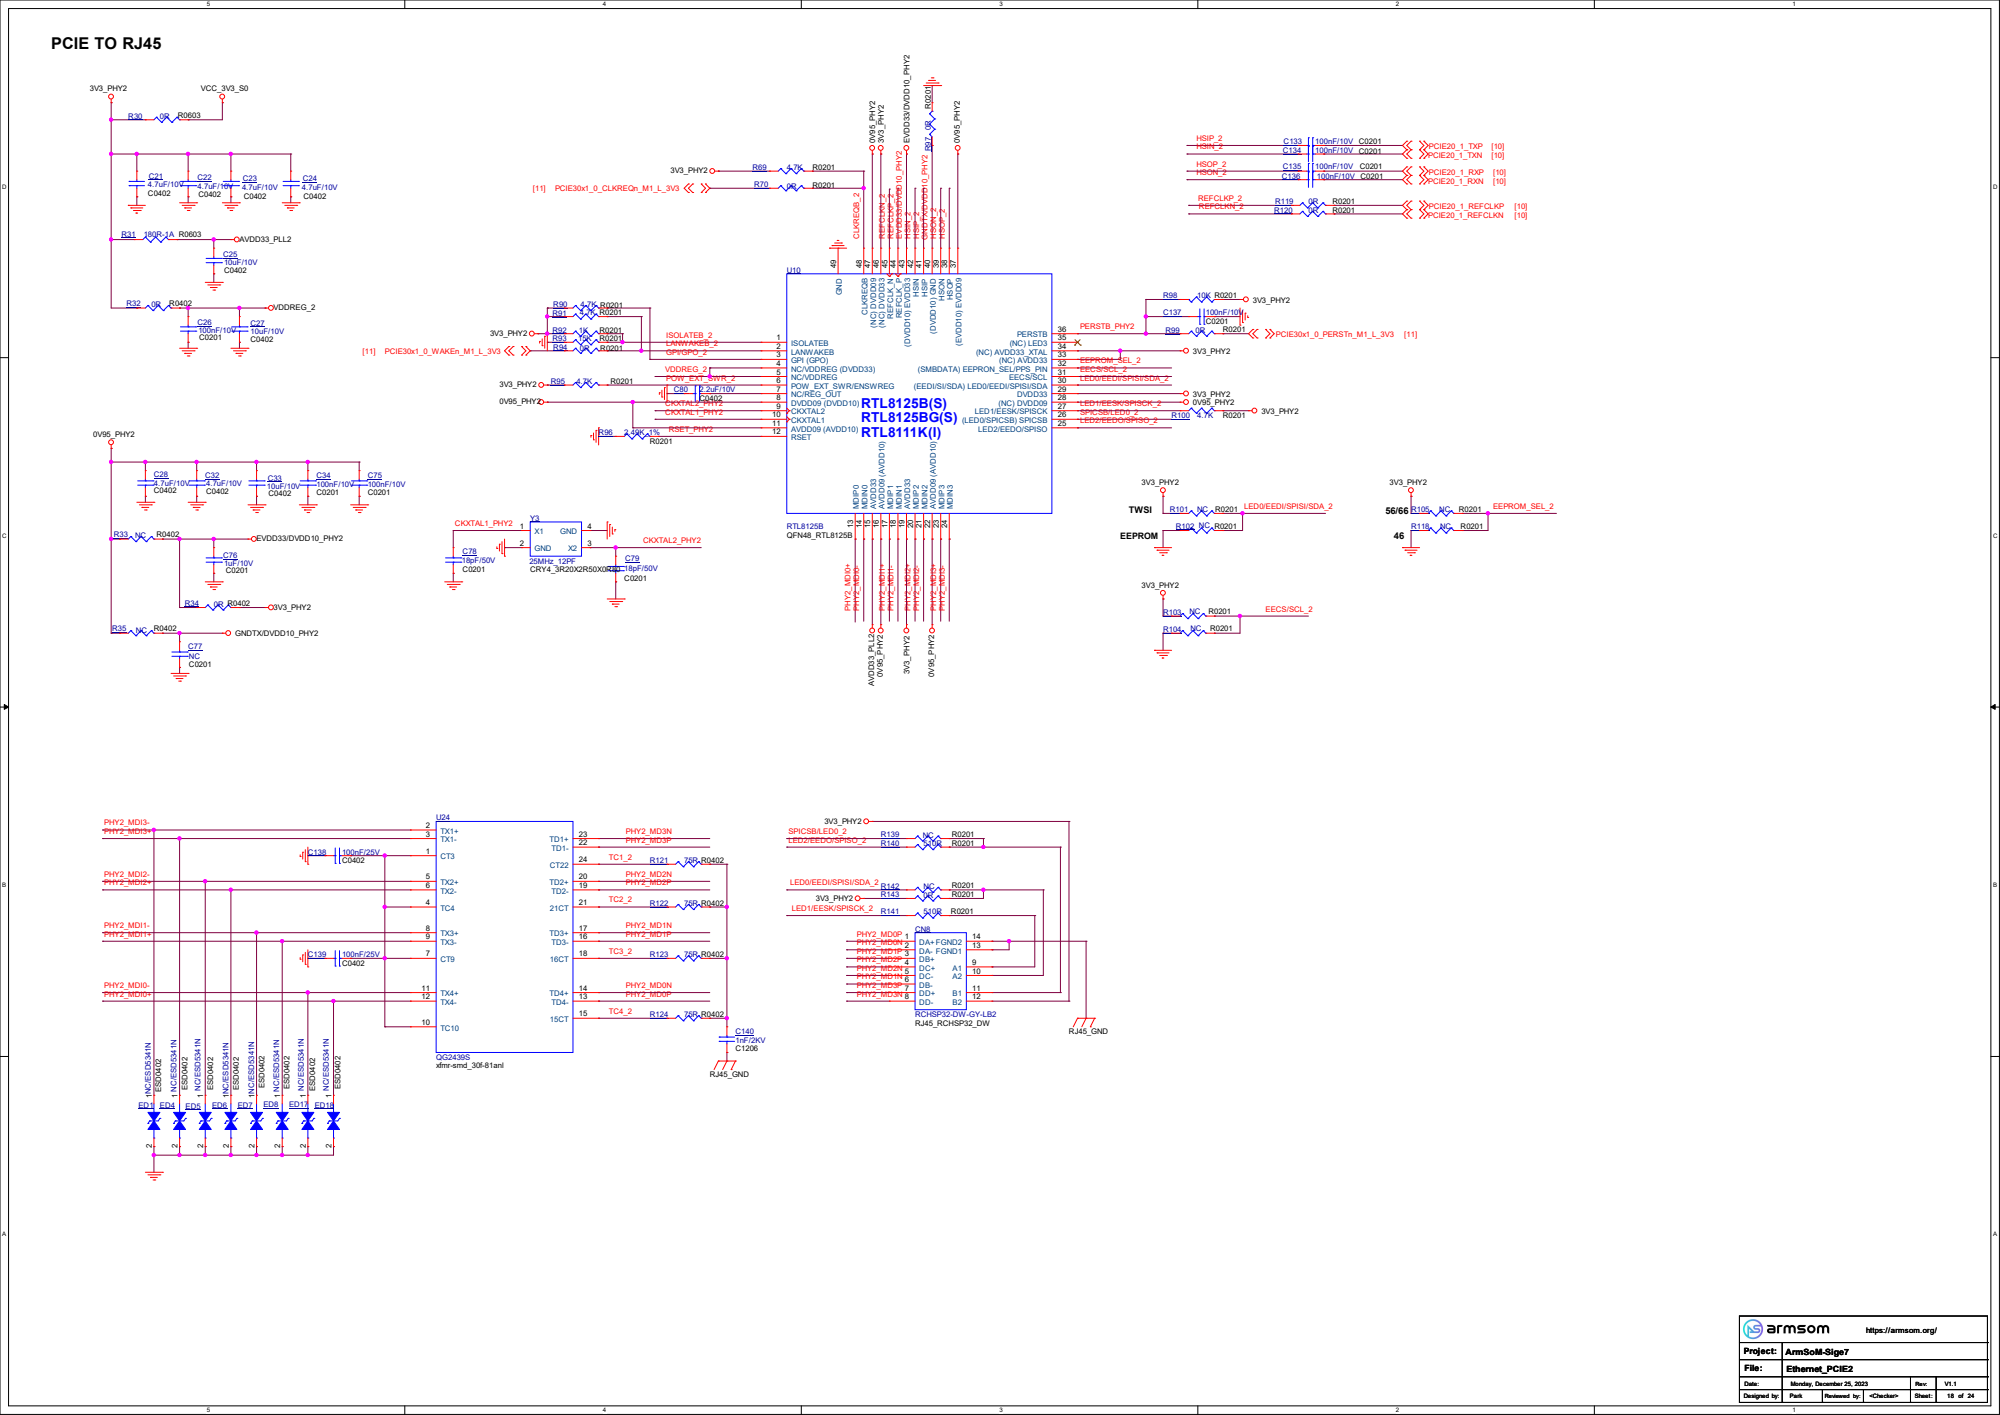
[picture p47: page 18]

2 48 CLKREQB (NC⁾ DVDD⁰⁹ ⁴⁷ GPI (GPO) 3 NC/VDDREG (DVDD33) 4 NC/VDDREG
RTL8111K(I) U10 QFN48_RTL8125B RTL8125B

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

# TF CARD

# SDMMC_DET_L SDMMC0_D0 SDMMC0_D1 SDMMC0_D2 SDMMC0_D3 SDMMC0_CMD

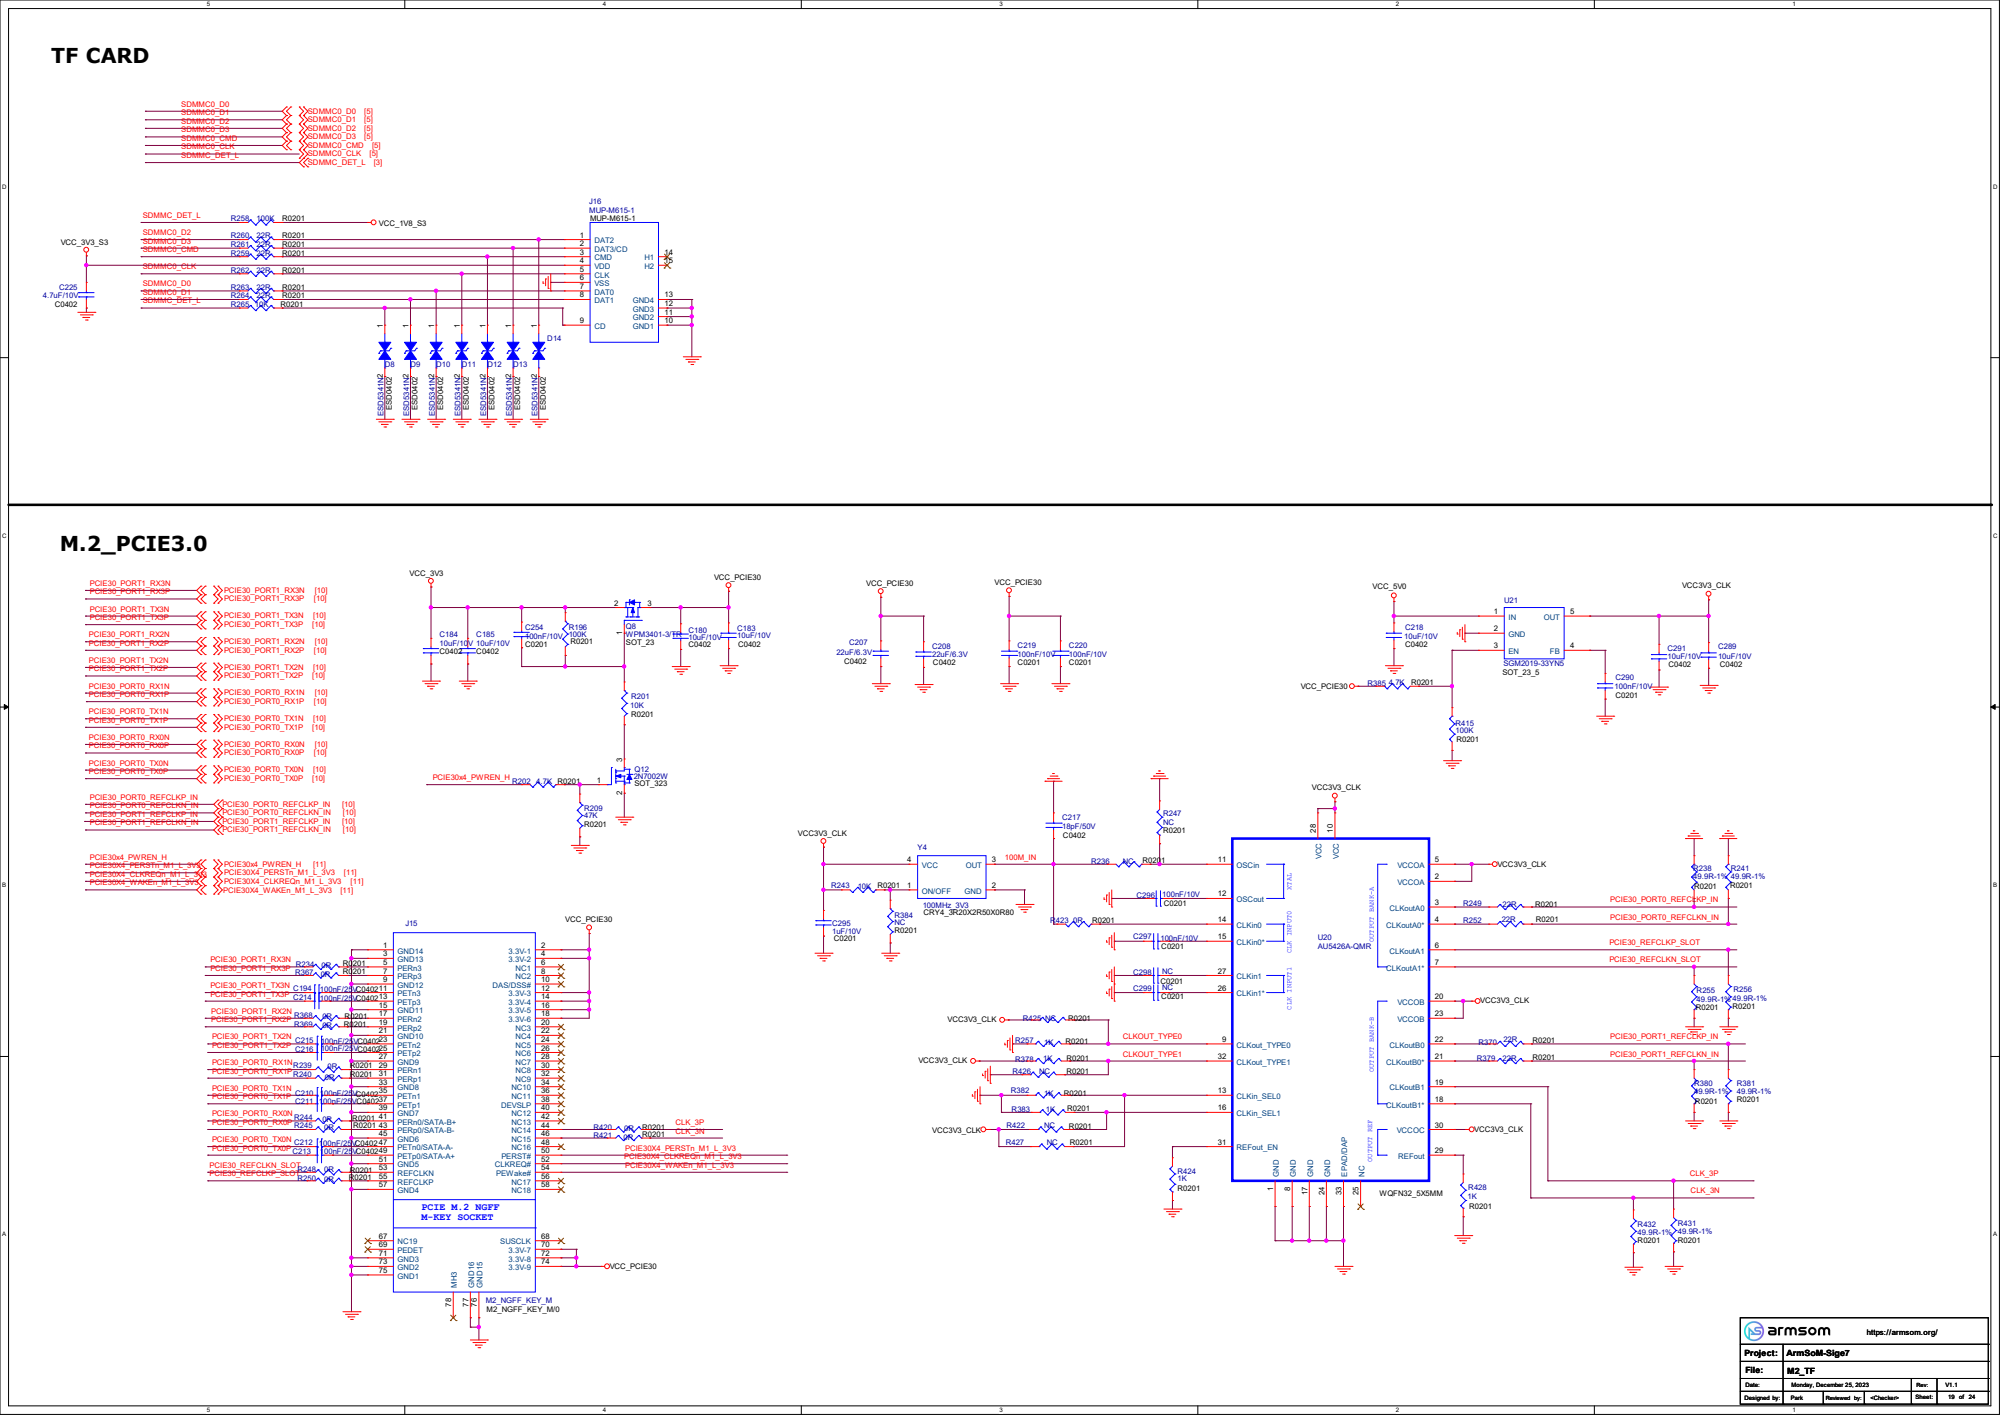
[picture p48: page 19]

# CSI0_MIPI

MIPI_CSI0_RX_CLK0P [8] MIPI_CSI0_RX_CLK0N [8] MIPI_CSI0_RX_D0P [8] MIPI_CSI0_RX_D0N [8] MIPI_CSI0_RX_D1P [8] MIPI_CSI0_RX_D1N [8] MIPI_CSI0_RX_CLK1P [8] MIPI_CSI0_RX_CLK1N [8] MIPI_CSI0_RX_D2P [8] MIPI_CSI0_RX_D2N [8] MIPI_CSI0_RX_D3P [8] MIPI_CSI0_RX_D3N [8] MIPI_CAM3_CLKOUT [11] MIPI_CAM1_CLKOUT [11] MIPI_CSI0_PDN0_H | [11] MIPI_CSI0_PDN1_H | [11] CM1_RST_L_1V8 [16]

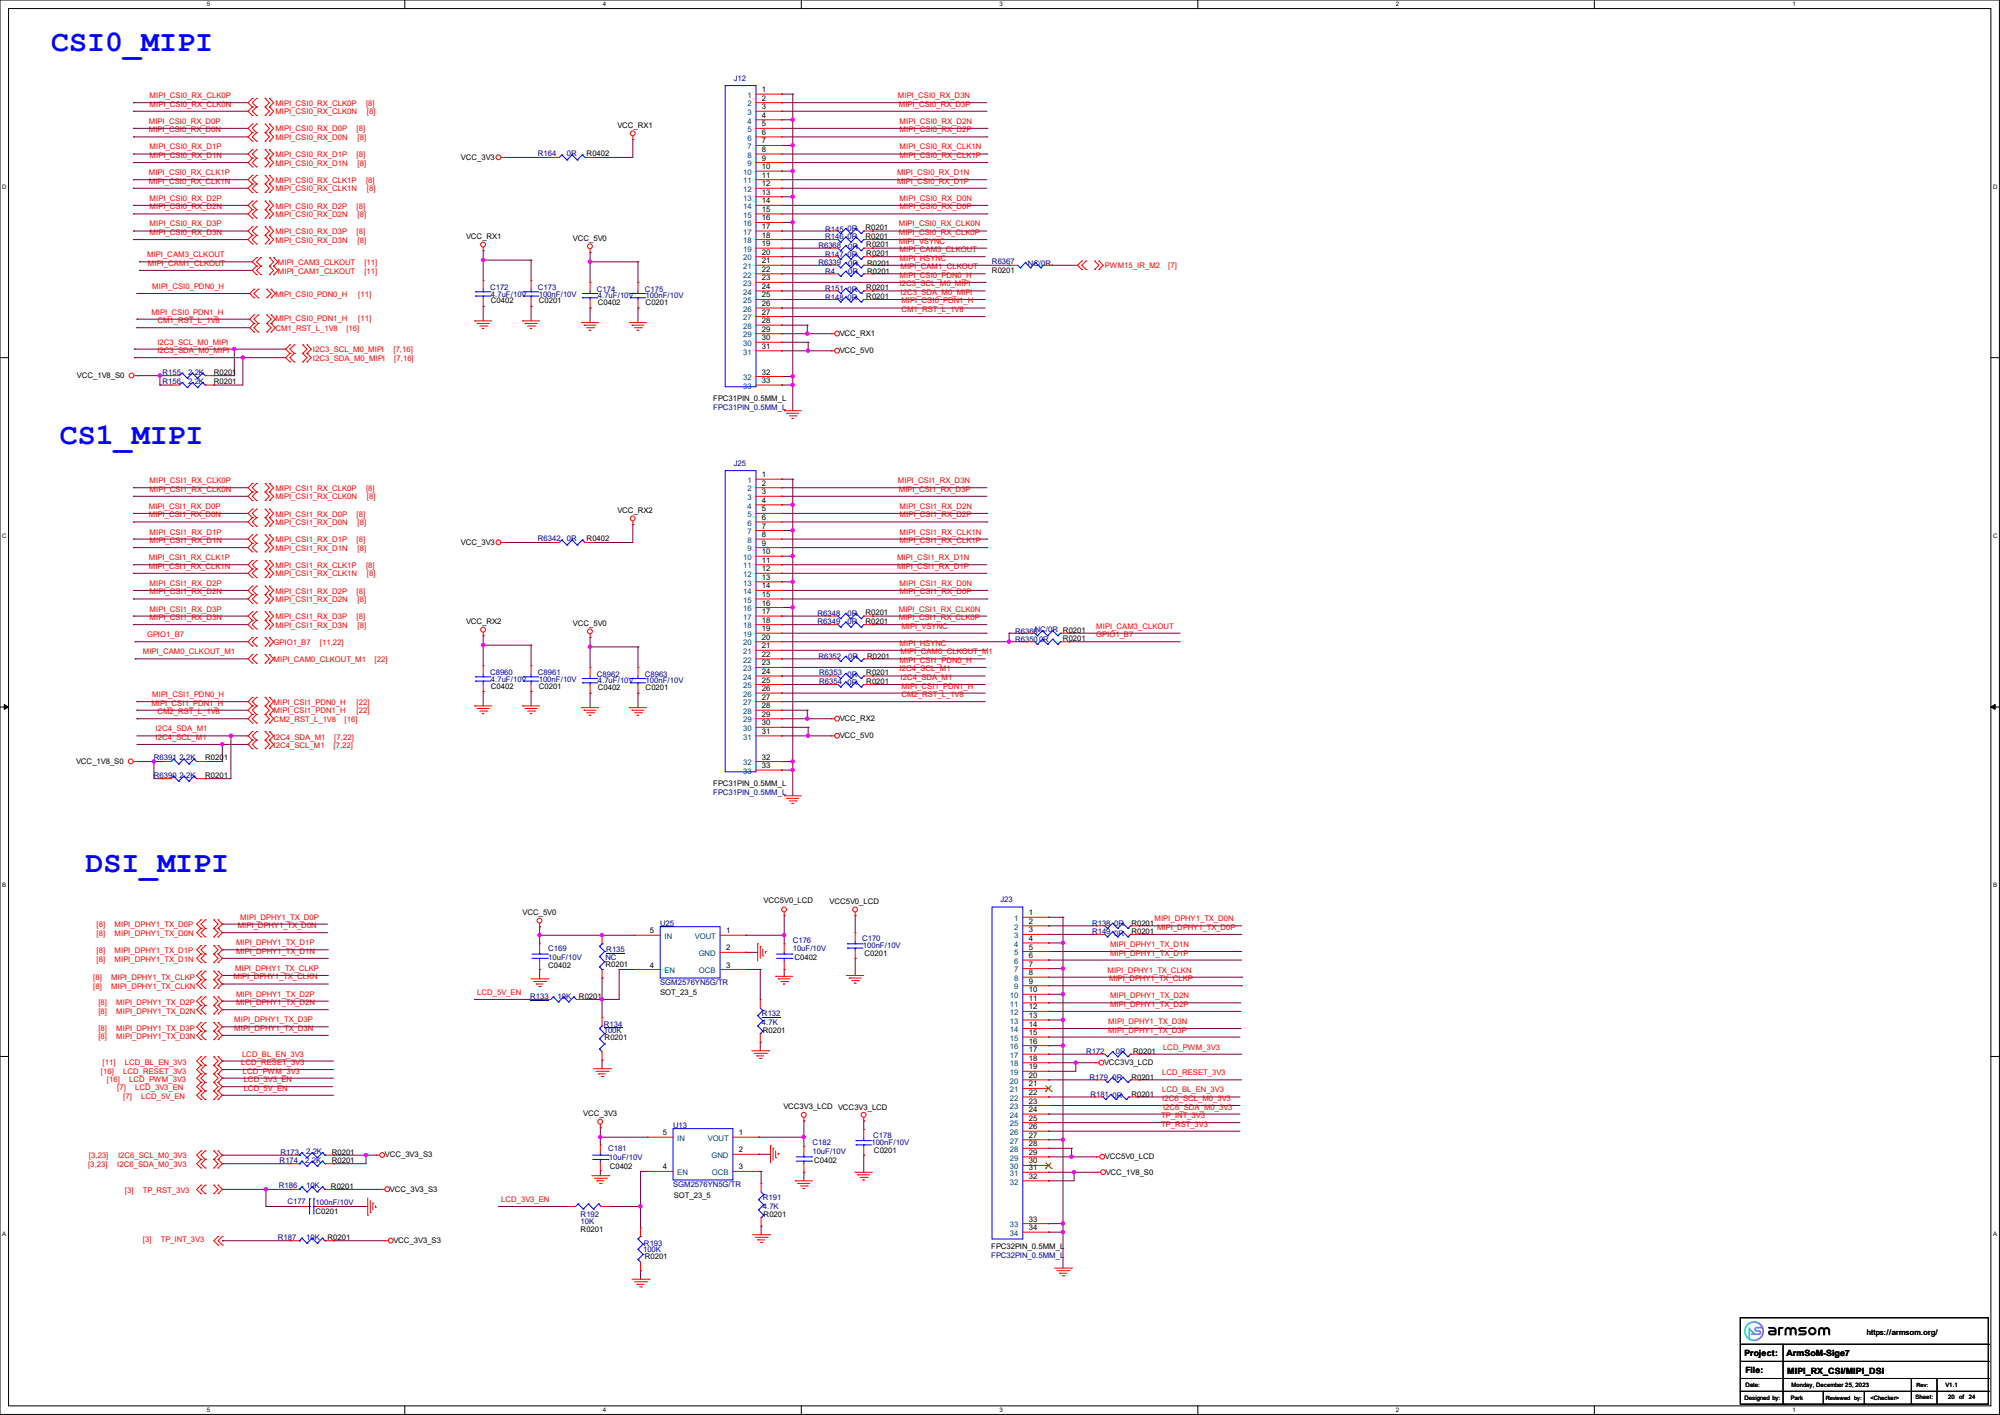
[picture p49: page 20]

D D

# Type-C

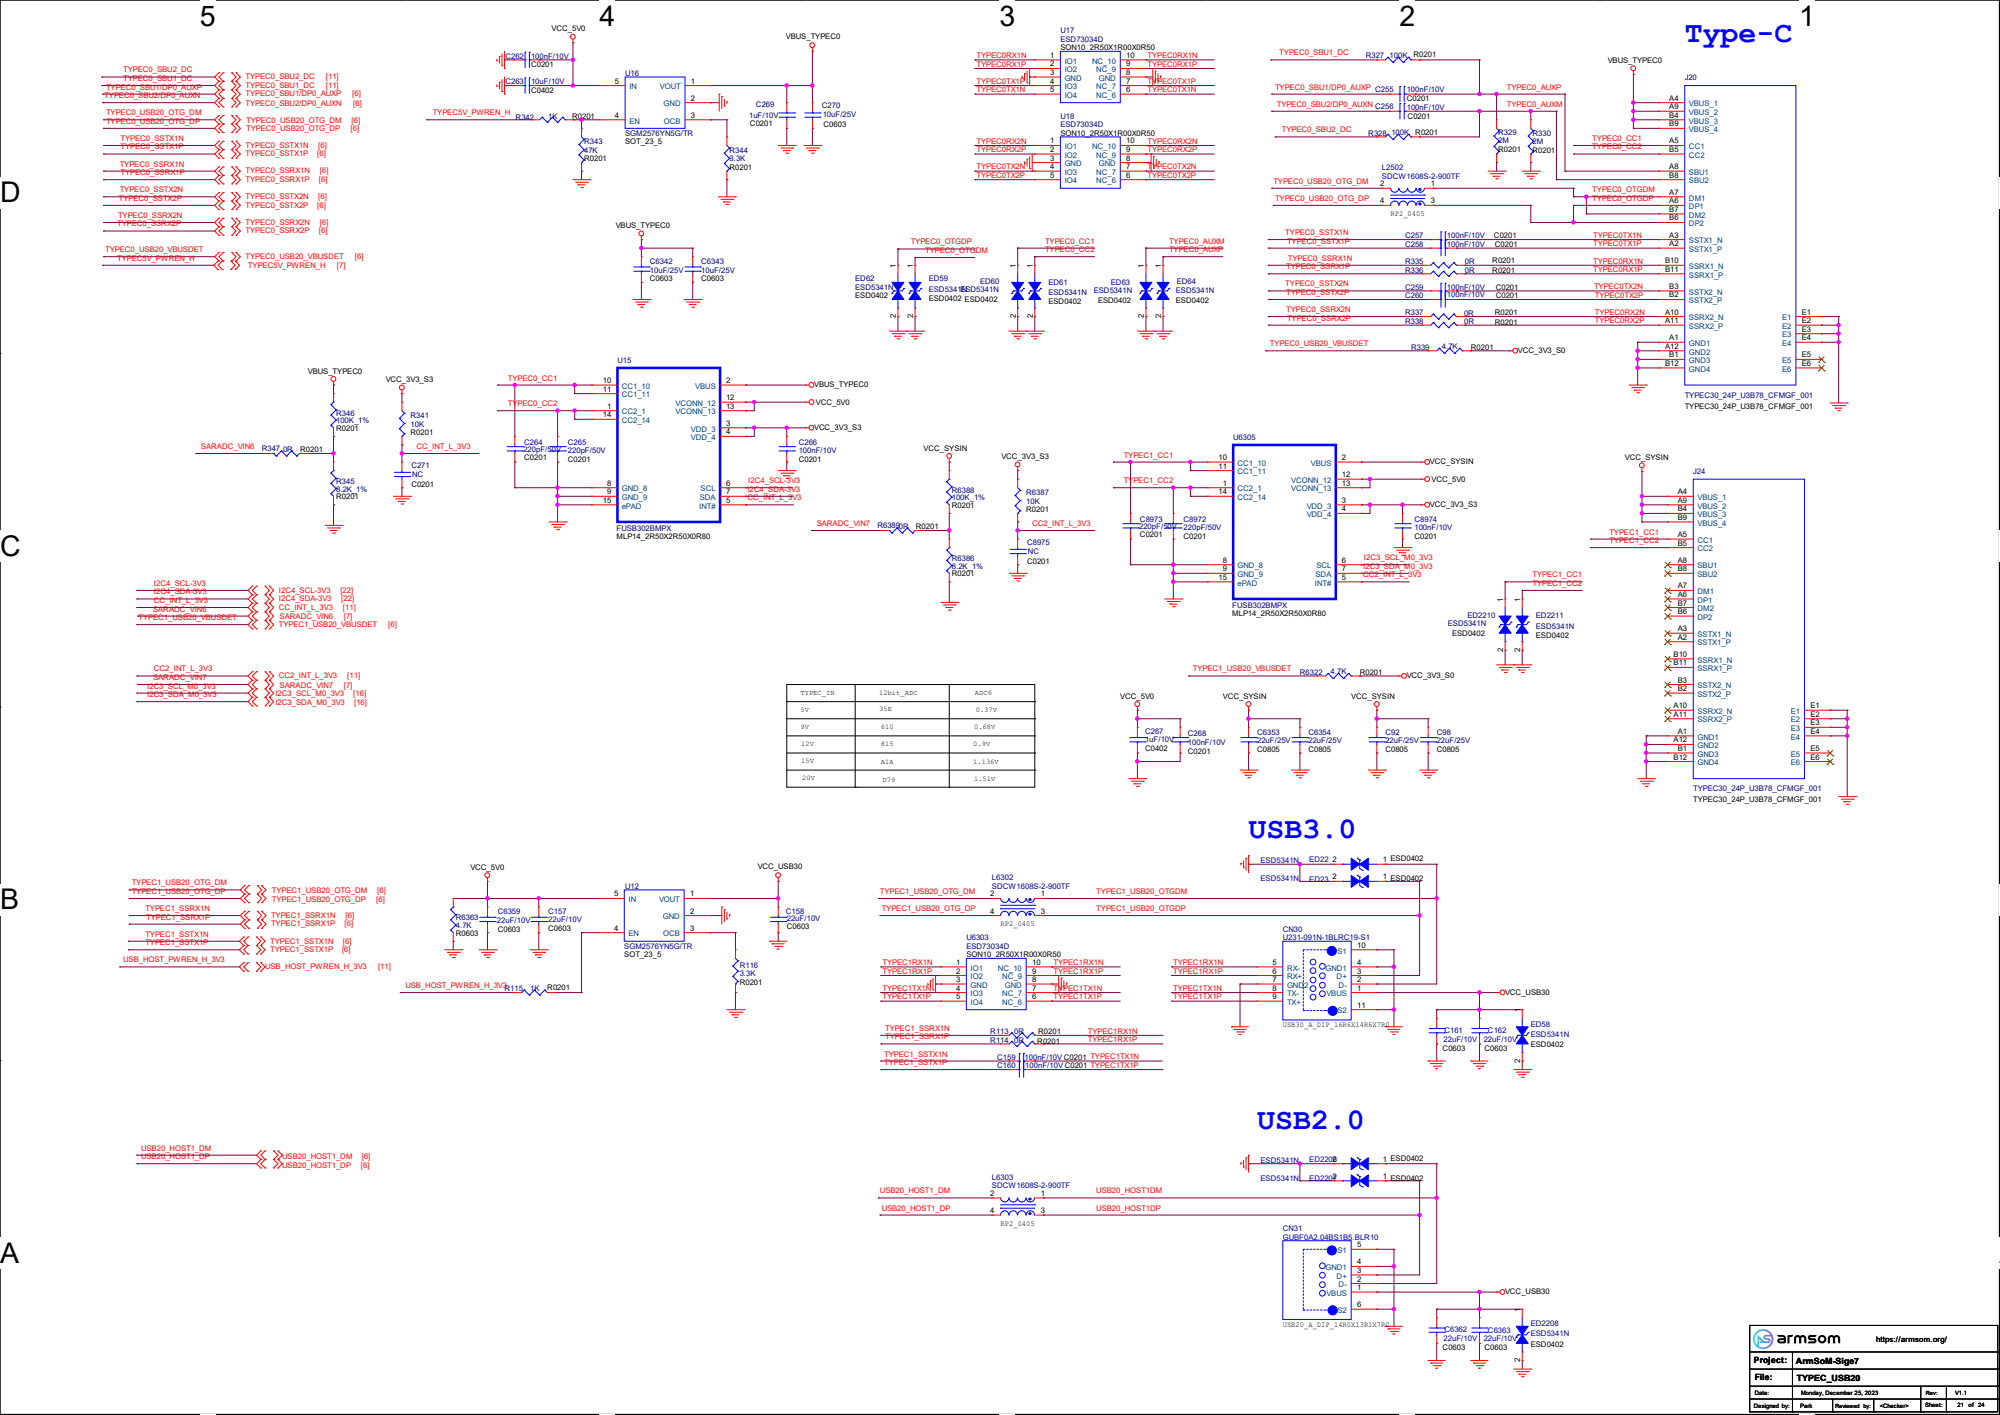
[picture p50: page 21]

# CODEC ES8316

# PWR_KEY

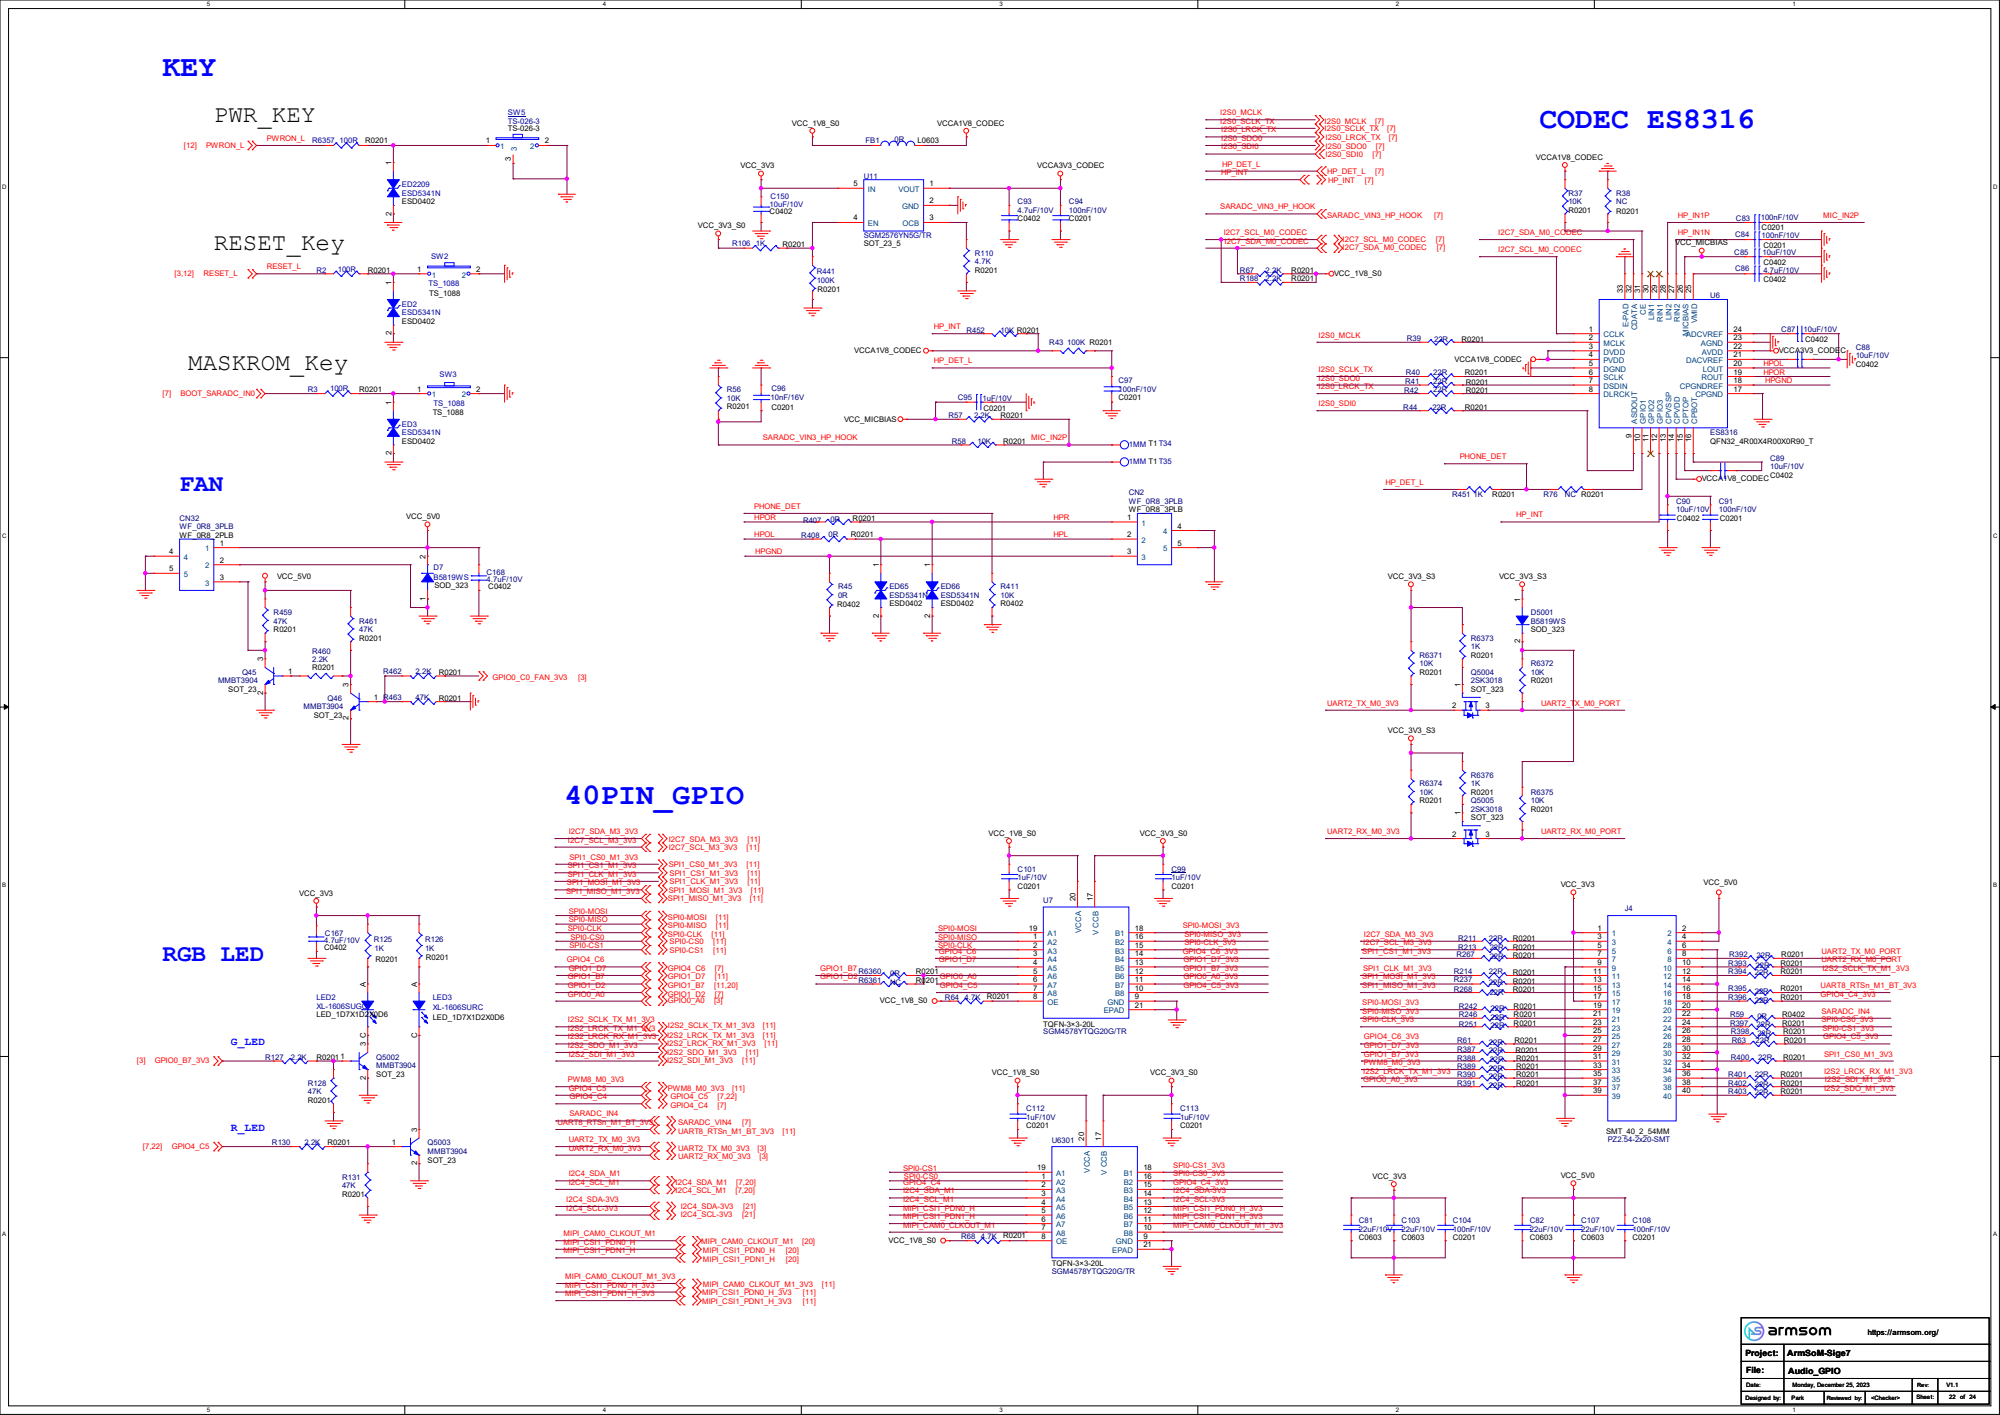
[picture p51: page 22]

24 VMID ²⁵ MICBIAS ²⁶ RIN² ²⁷ LIN² ²⁸ RIN¹ ²⁹ LIN¹ ³⁰ CE ³¹ CDATA ³² E⁻PAD ³³
U6ES8316 QFN32_4R00X4R00X0R90_T CCLK

9 GPIO1 10 GPIO2 11 GPIO3 12 CPVSSP 13 CPVDD 14 CPTOP 15 CPBOT 16 CPGND

https://armsom.org/ Monday, December 25, 2023 Audio_GPIO

# DC_5.1V

# I2C6_SDA_M0_3V3 RTC_INT_L RTC_32.768K

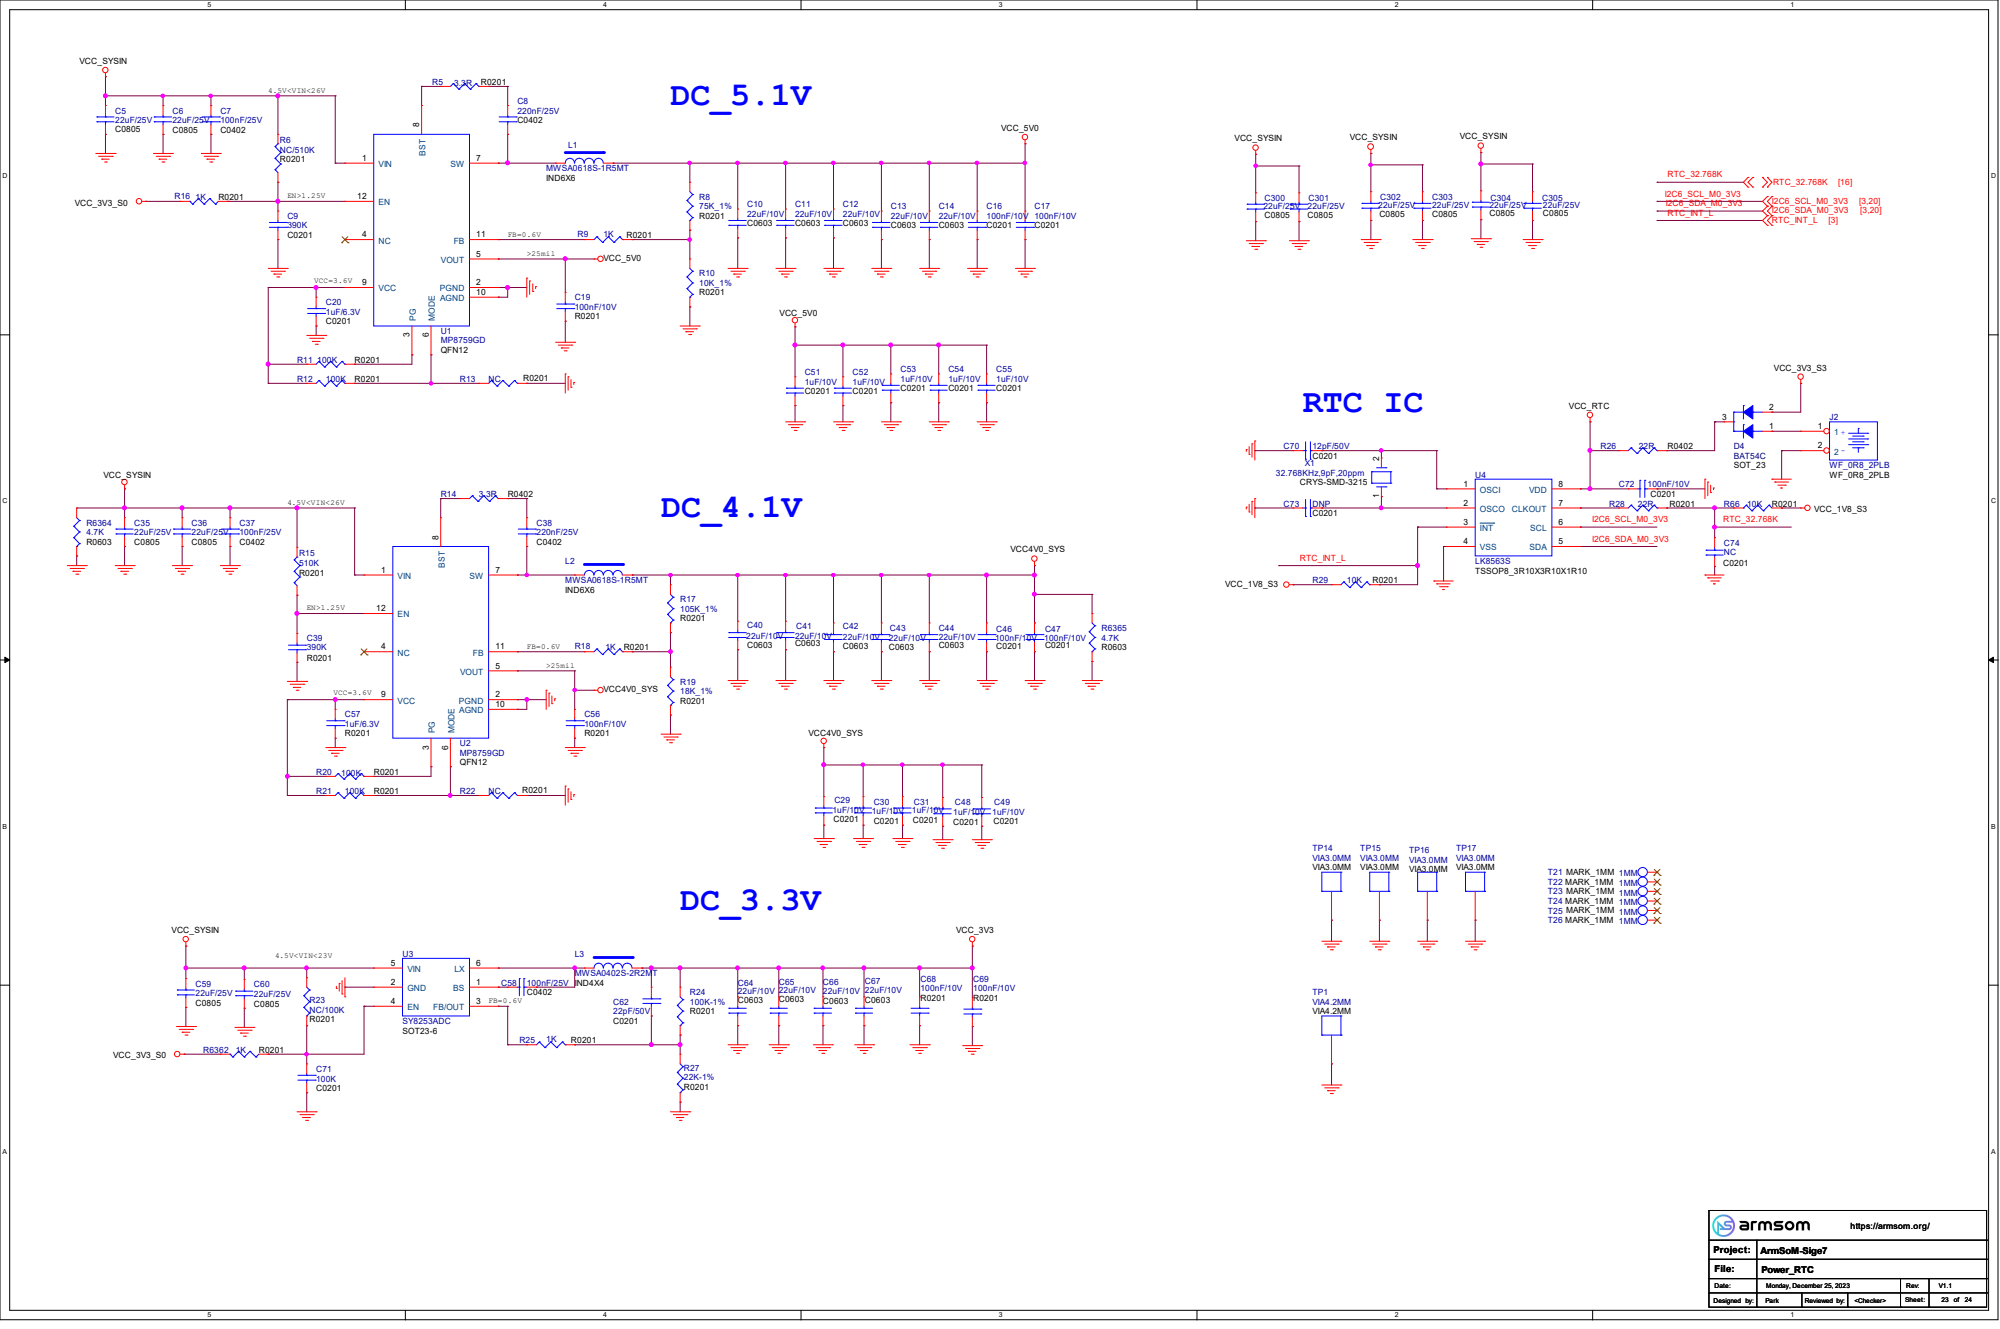
[picture p52: page 23]

https://armsom.org/ Monday, December 25, 2023 Power_RTC

D D

# Revision History

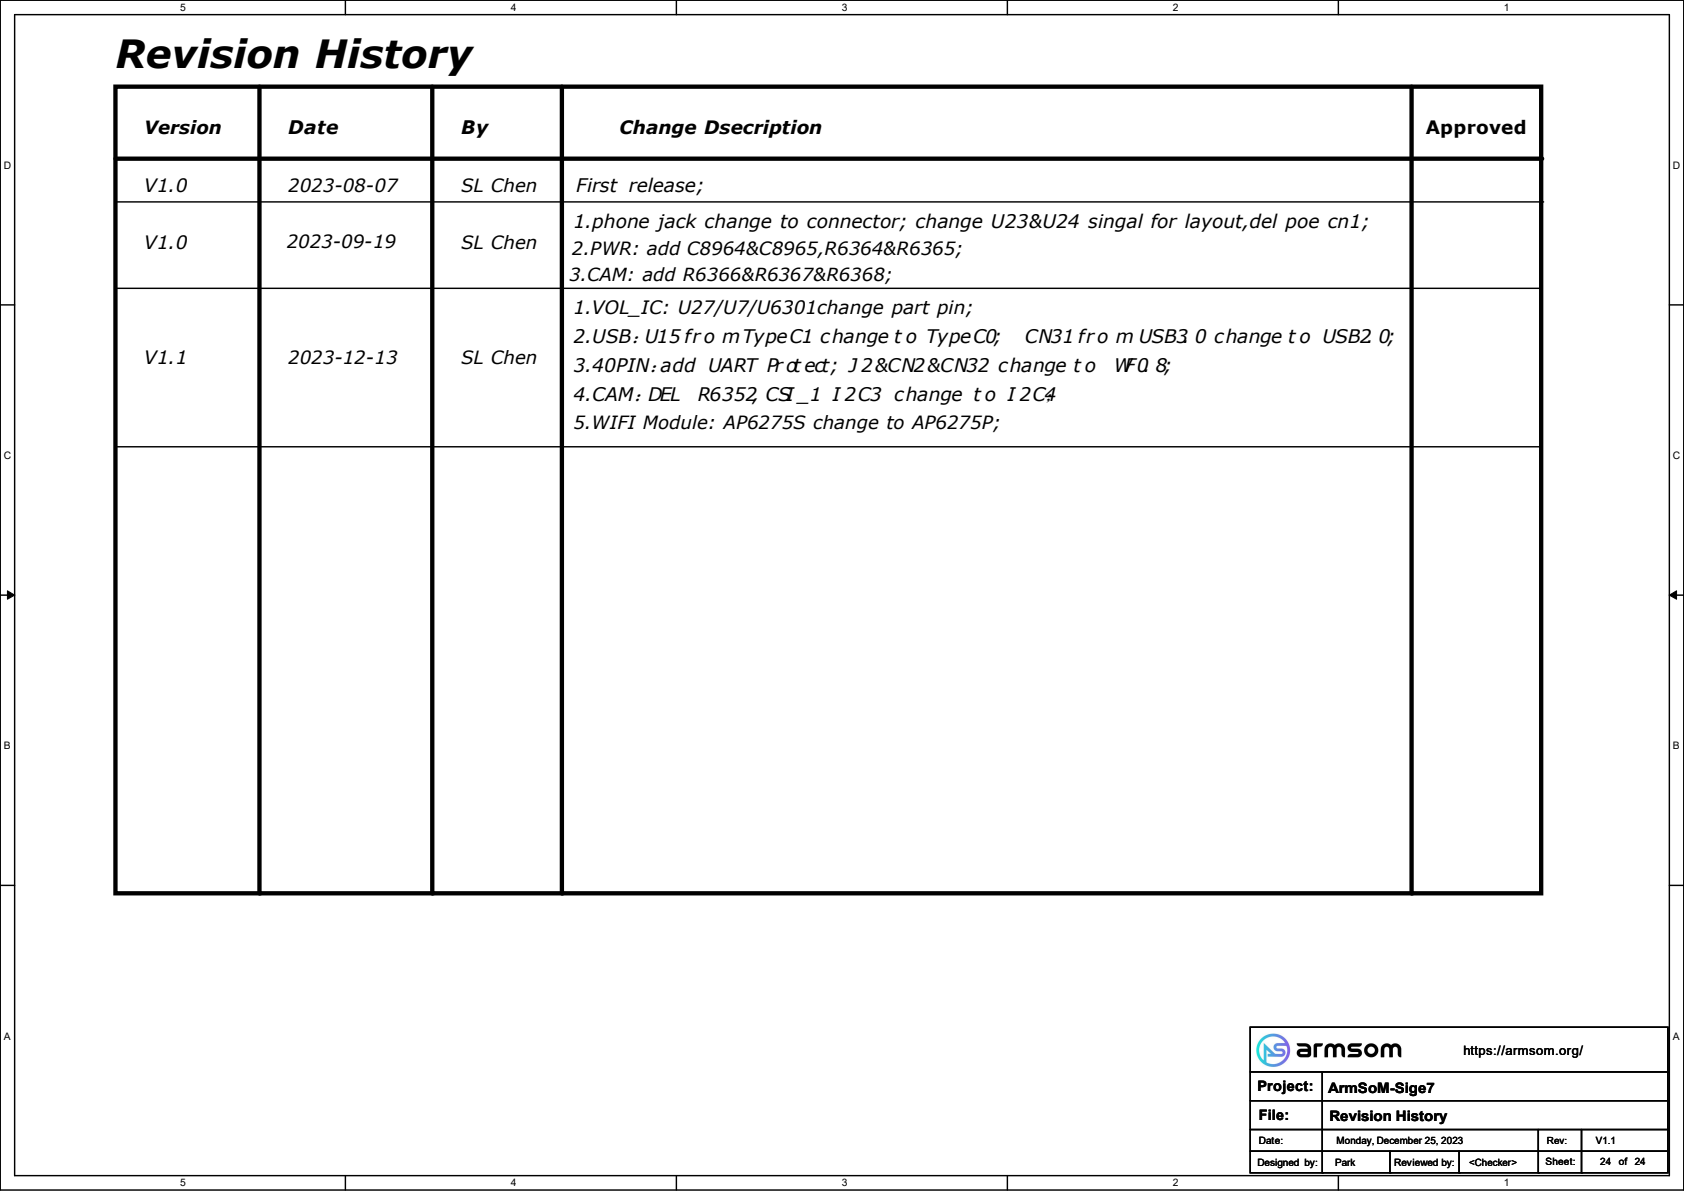
[picture p53: page 24]
Version; Date; Change Dsecription; Approved; SL Chen; First release;; 2.PWR: add C8964&C8965,R6364&R6365;; Project:; Monday, December 25, 2023; Revision History; ArmSoM-Sige7 Park; 24 V1.1 <Checker>

1.phone jack change to connector; change U23&U24 singal for layout,del poe cn1;

3.CAM: add R6366&R6367&R6368;
1.VOL_IC: U27/U7/U6301change part pin;
2.USB：U15 fr o m TypeC1 change t o TypeC0; CN31 fr o m USB3. 0 change t o USB2. 0;
3.40PIN：add UART Pr ot ect; J 2&CN2&CN32 change t o WF0. 8;
4.CAM：DEL R6352, CSI _1 I 2C3 change t o I 2C4；
5.WIFI Module: AP6275S change to AP6275P;

https://armsom.org/
