as-jackson/-RK3588-Development-Board-/(list of files, drawings)

Other design files:
RK3588_Schematics/RK3588_core_board_ArmSoM_W3_1V2_20240617.DSN
