as-jackson/-RK3588-Development-Board-/(commit log)

2024-10-31 rk3588 development board
    [RK3588_sbc_ArmSoM-Sige7_1V1_20231219_bot.dxf, RK3588_sbc_ArmSoM-Sige7_1V1_20231219_top.dxf, rk3588_core_board_ArmSoM_W3_1V2_bot.dxf]
2024-10-31 rk3588 core board
    [RK3588_core_board_ArmSoM_W3_1V2_20240617.DSN]
